ronmart17/nova-robot/docs/images/NOVA_RevB_hero_face.png

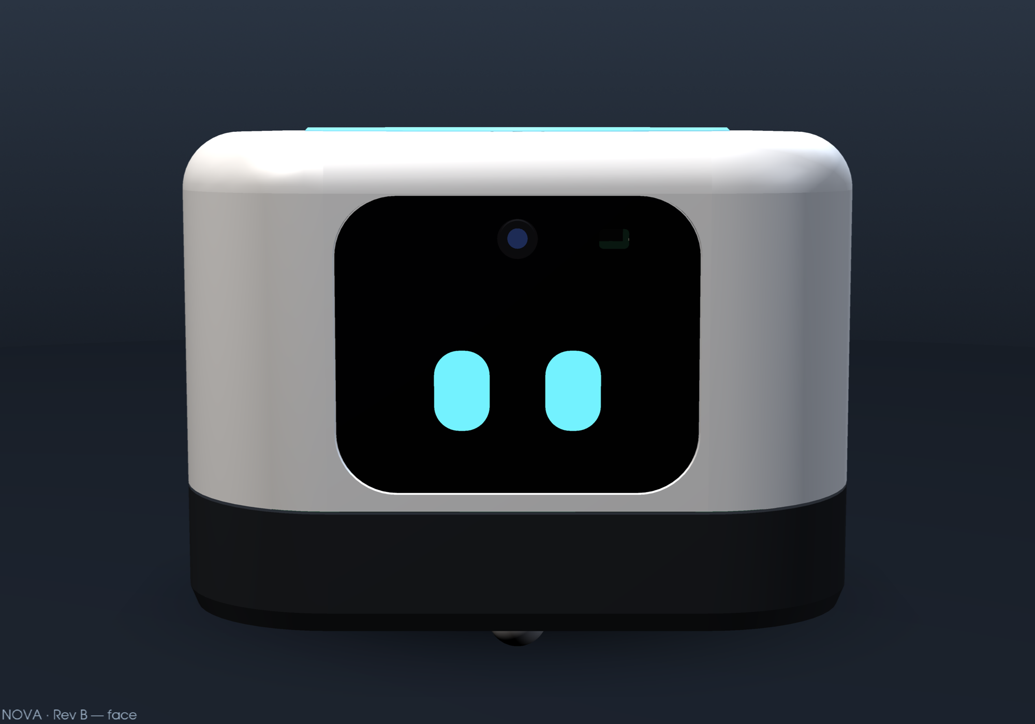
docs/images/NOVA_RevB_hero_face.png
