ronmart17/nova-robot/mechanics/renders/concept_core_iso.png

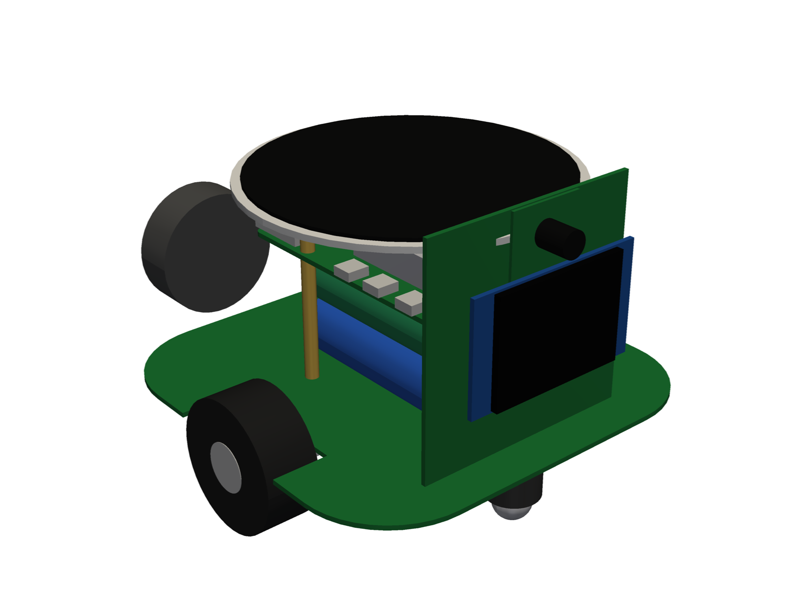
mechanics/renders/concept_core_iso.png
