ronmart17/nova-robot/mechanics/renders/concept_shell_iso.png

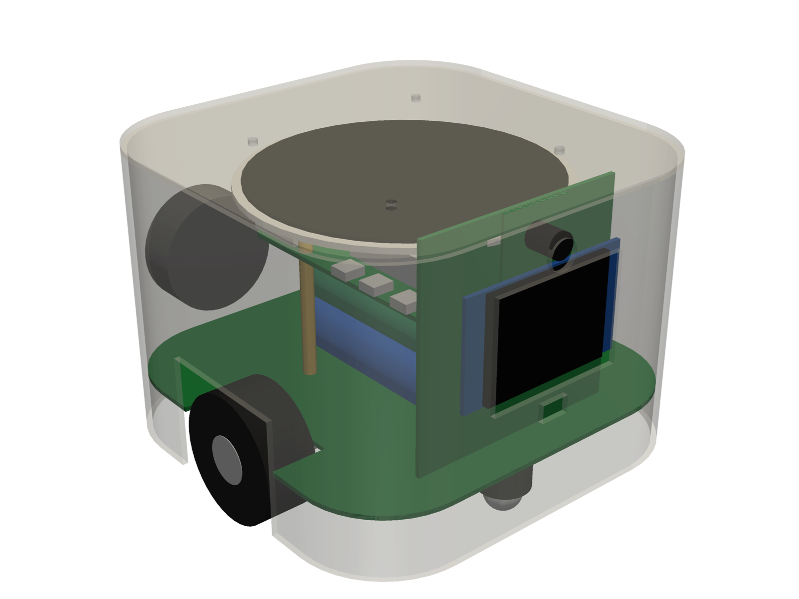
mechanics/renders/concept_shell_iso.png
