ronmart17/nova-robot/mechanics/renders/concept_side.png

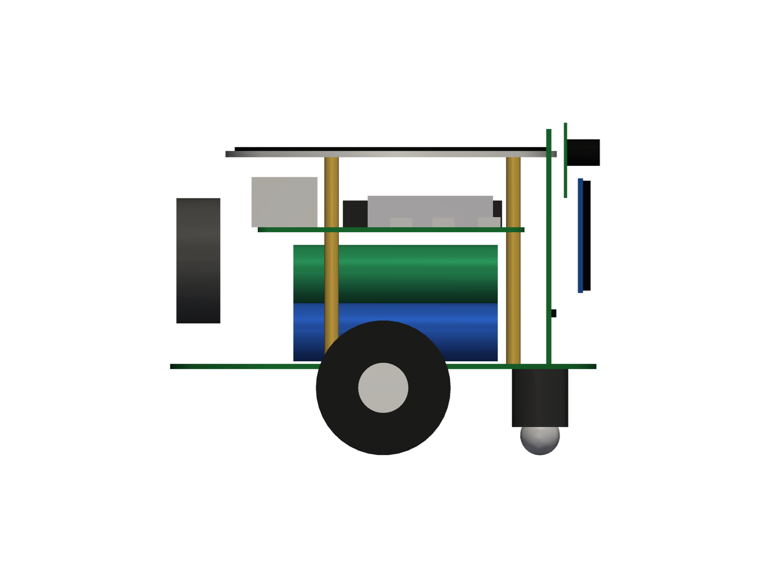
mechanics/renders/concept_side.png
