ronmart17/nova-robot/mechanics/renders/layout_top.png

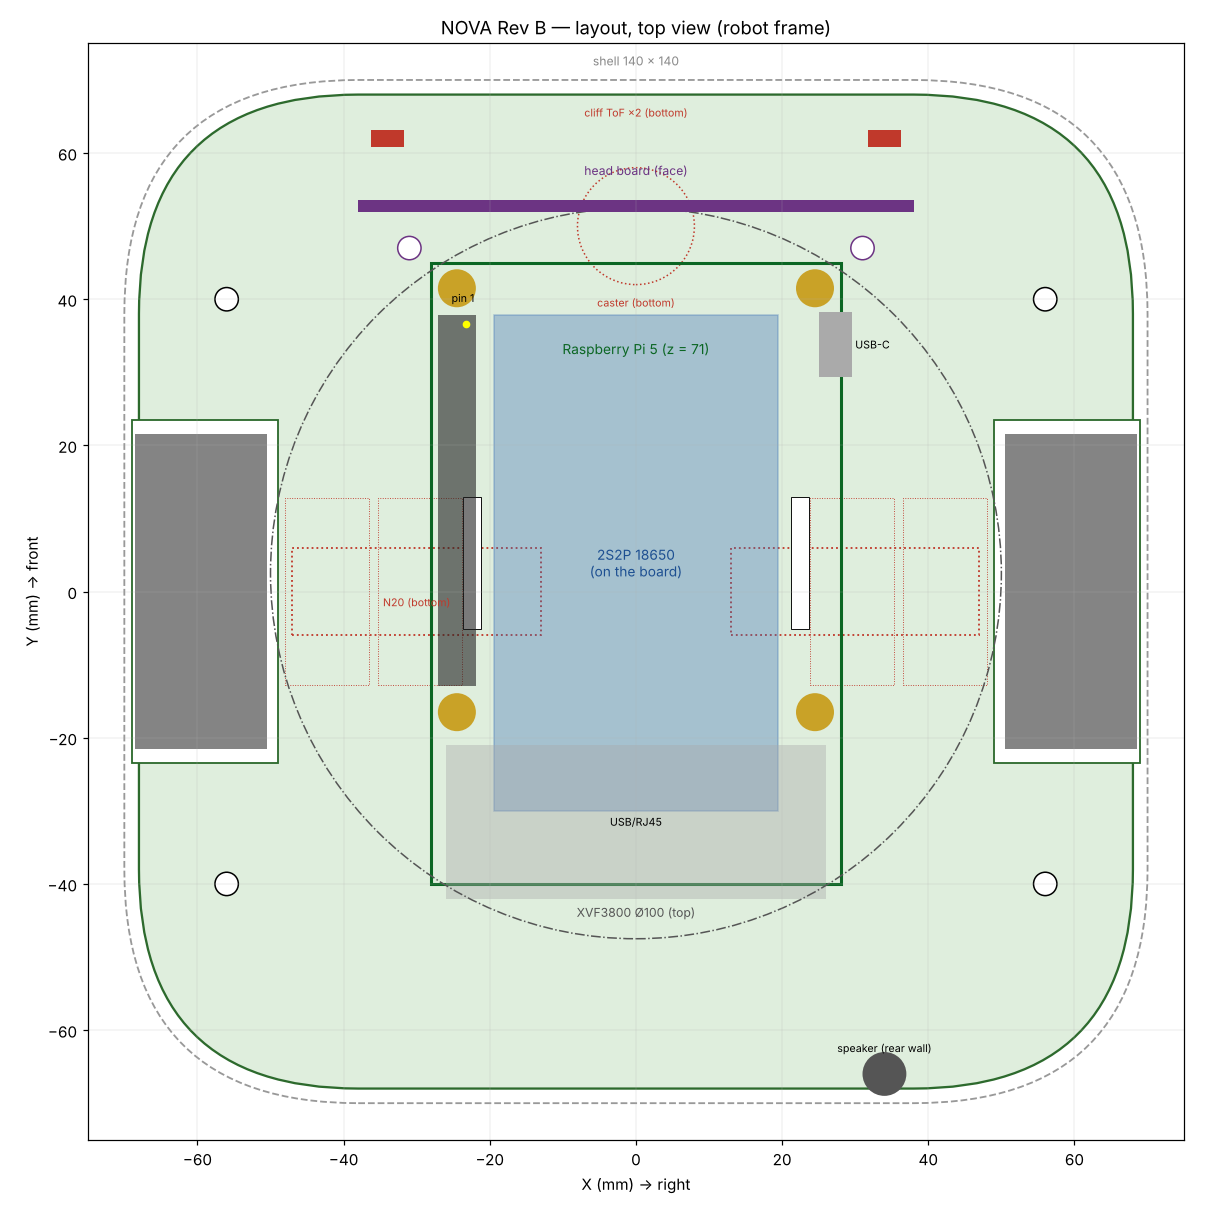
mechanics/renders/layout_top.png
