ronmart17/nova-robot/mechanics/renders/NOVA_RevB_core_left.png

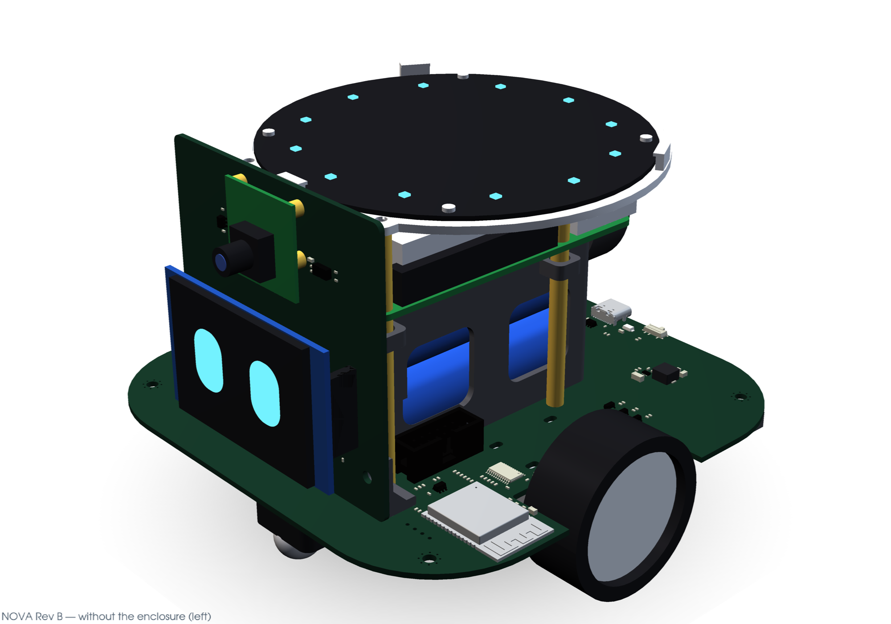
mechanics/renders/NOVA_RevB_core_left.png
