ronmart17/nova-robot/mechanics/renders/NOVA_RevB_dock.png

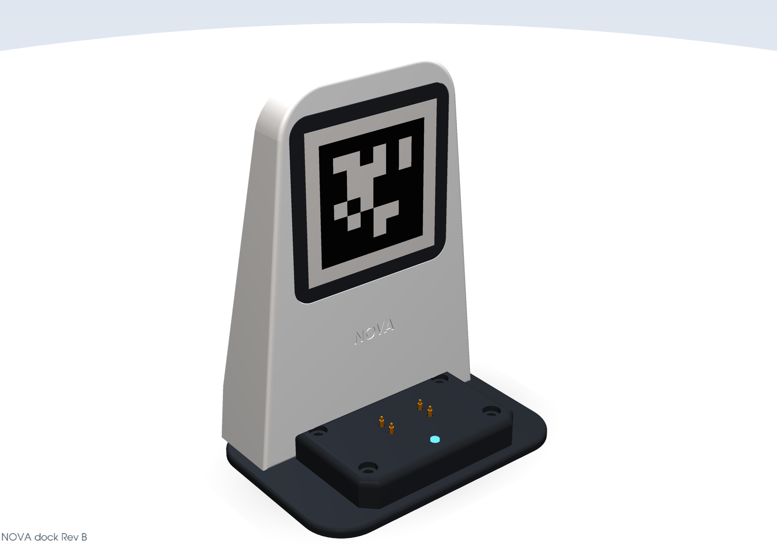
mechanics/renders/NOVA_RevB_dock.png
