ronmart17/nova-robot/mechanics/renders/NOVA_RevB_docked.png

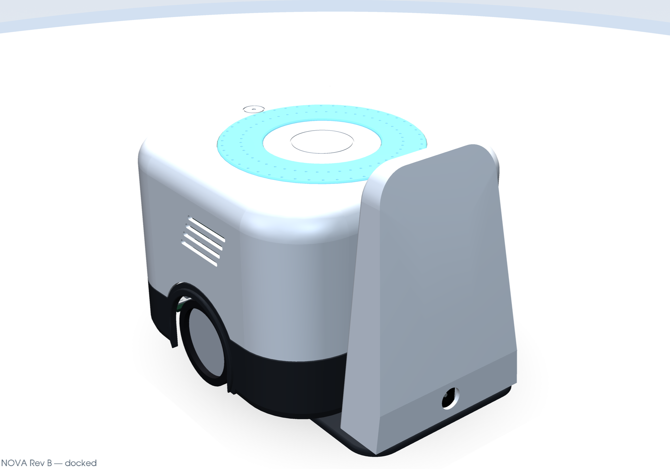
mechanics/renders/NOVA_RevB_docked.png
