ronmart17/nova-robot/mechanics/renders/NOVA_RevB_front.png

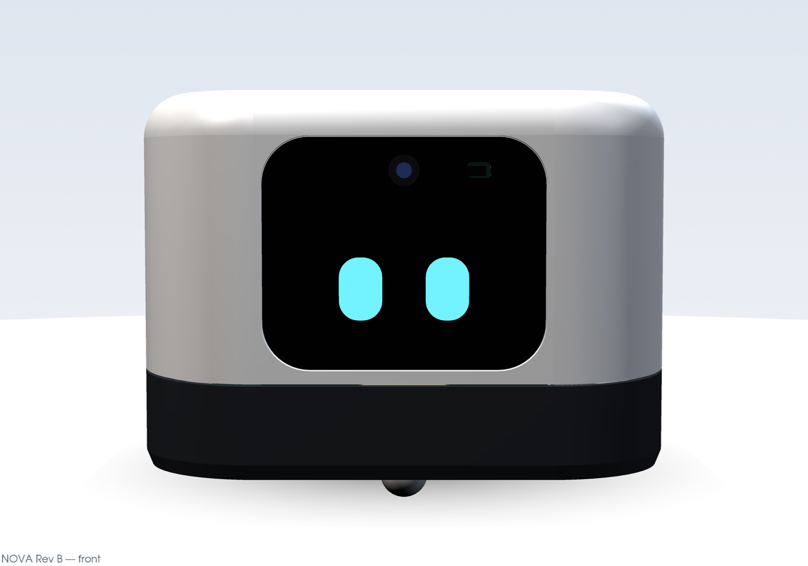
mechanics/renders/NOVA_RevB_front.png
