ronmart17/nova-robot/mechanics/renders/NOVA_RevB_hero_dock.png

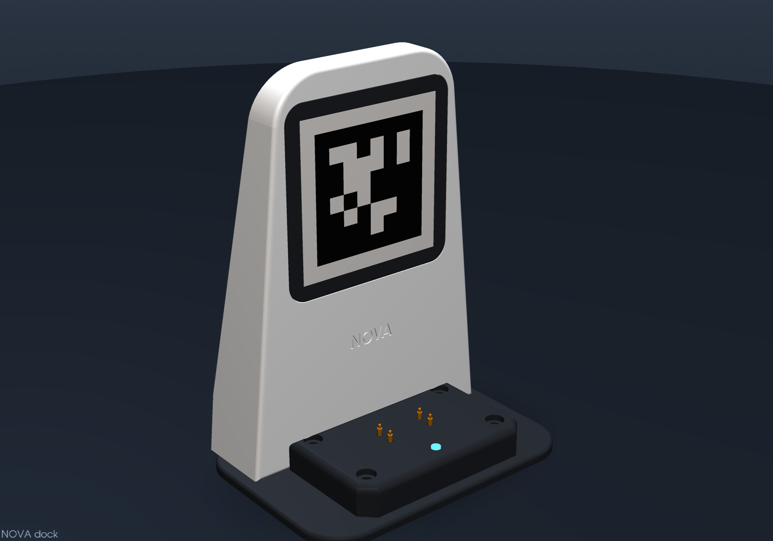
mechanics/renders/NOVA_RevB_hero_dock.png
