ronmart17/nova-robot/mechanics/renders/NOVA_RevB_iso.png

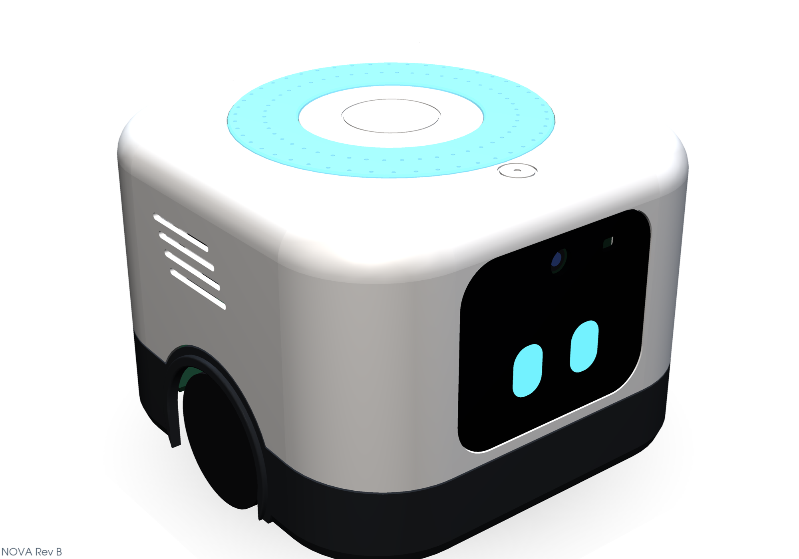
mechanics/renders/NOVA_RevB_iso.png
