ronmart17/nova-robot/mechanics/renders/NOVA_RevB_rear.png

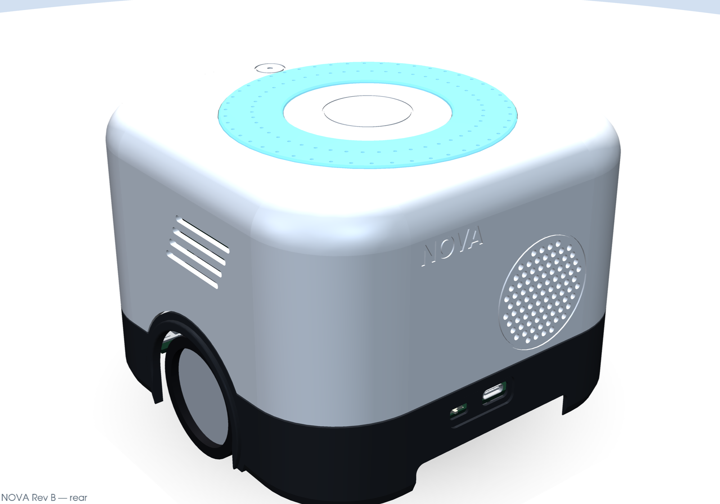
mechanics/renders/NOVA_RevB_rear.png
