ronmart17/nova-robot/mechanics/renders/NOVA_RevB_under.png

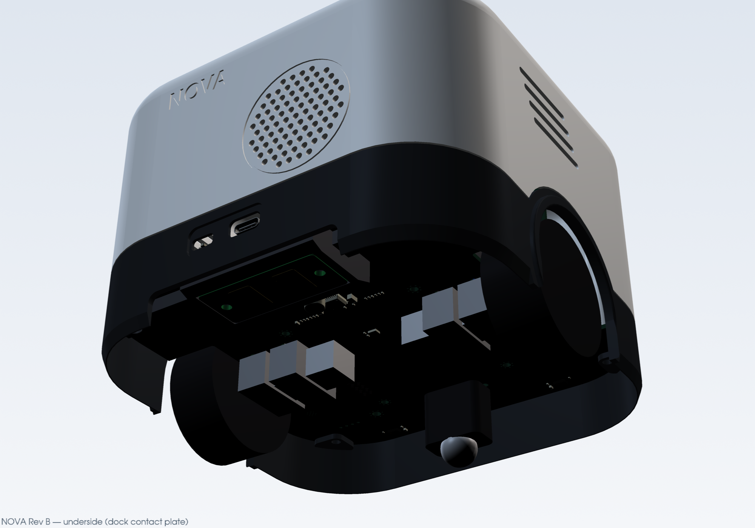
mechanics/renders/NOVA_RevB_under.png
