ronmart17/nova-robot/simulations/plots/s1_vsys_motors_6.6V.png

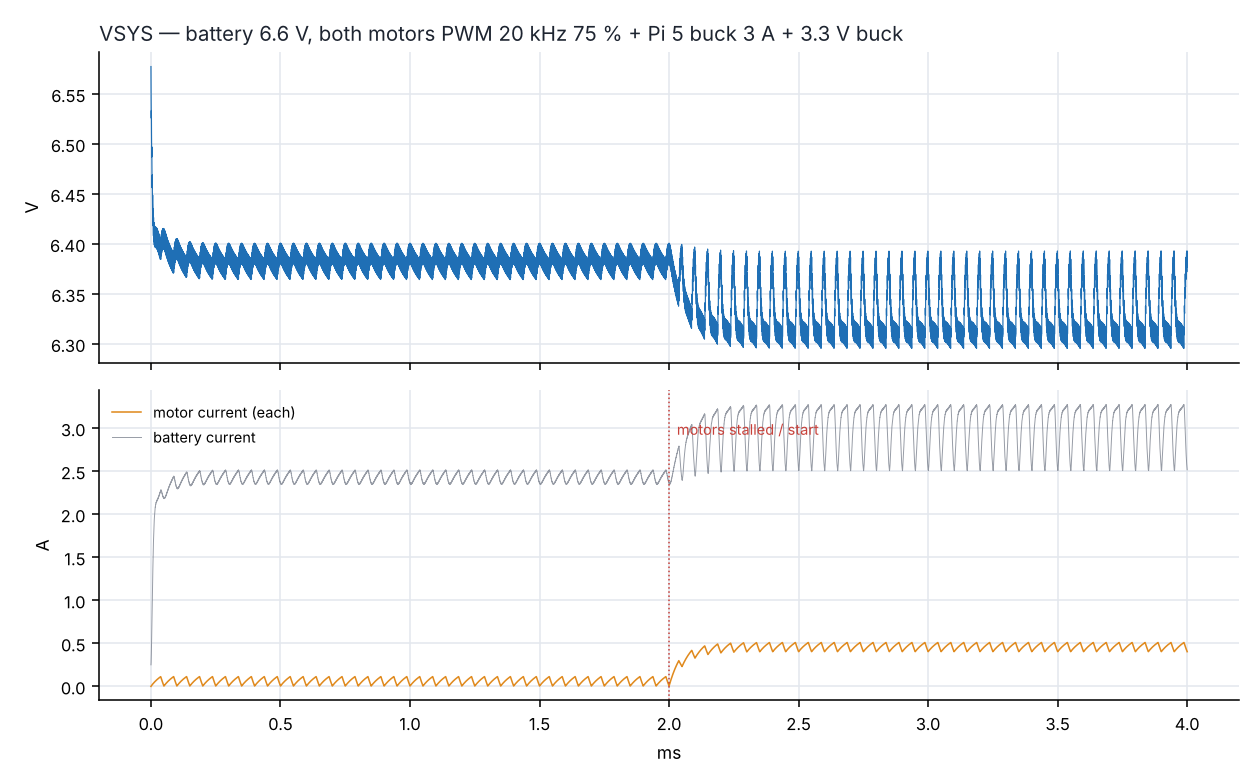
simulations/plots/s1_vsys_motors_6.6V.png
