ronmart17/nova-robot/hardware/nova-head/fabrication/nova-head_BOM.csv

Item | Qty | Designators | Value | Footprint | Manufacturer | MPN | LCSC | Mouser | DigiKey | Alt MPN | Alt Mouser | Alt DigiKey | Description | Sourcing note | DNP
1 | 1 | C101 | 10u/10V | C_0603_1608Metric | Yageo | CC0603KRX5R6BB106 | C326057 | 603-CC603KRX5R6BB106 |  |  |  |  | MLCC 10uF 10V X5R 0603 | JLC Basic alt C19702
2 | 5 | C102, C103, C105, C106, C108 | 100n | C_0402_1005Metric | Samsung | CL05B104KB54PNC | C307331 | 187-CL05B104KB54PNC | 1276-CL05B104KB54PNCCT-ND |  |  |  | MLCC 100nF 50V X7R 0402 | JLC Basic
3 | 1 | C104 | 4.7u/16V | C_0603_1608Metric | Samsung | CL10A475KO8NNNC | C19666 |  | 1276-1784-1-ND |  |  |  | MLCC 4.7uF 16V X5R 0603 | JLC Basic
4 | 1 | C109 | 8.2n | C_0402_1005Metric | Yageo | CC0402KRX7R9BB822 | C107032 | 603-CC402KRX7R9BB822 | 311-3817-1-ND |  |  |  | MLCC 8.2nF 50V X7R 0402 — QT1010 Cs
5 | 1 | J101 | HEAD | JST_SH_SM20B-SRSS-TB_1x20-1MP_P1.00mm_Horizontal | JST | SM20B-SRSS-TB(LF)(SN) | C160415 | 306-SM20BSRSSTBLFSN | 455-SM20B-SRSS-TBCT-ND |  |  |  | JST SH 20-pin SMD — cable to head board
6 | 1 | J102 | LCD ST7789 | PinSocket_1x08_P2.54mm_Vertical | Amphenol FCI | 75915-308LF | C3322318 | 649-75915-308LF | 609-3559-ND |  |  |  | Female header 1x8 2.54 mm — 2.0" ST7789 240x320 SPI module (GND VCC SCL SDA RES DC CS BLK) | LCSC 151 pcs.
7 | 1 | J103 | LCD ST7789 | PinSocket_1x08_P2.54mm_Vertical | Amphenol FCI | 75915-308LF | C3322318 | 649-75915-308LF | 609-3559-ND |  |  |  | Female header 1x8 2.54 mm — 2.0" ST7789 240x320 SPI module (GND VCC SCL SDA RES DC CS BLK) | LCSC 151 pcs. | DNP
8 | 1 | Q101 | AO3401A | SOT-23 | Alpha & Omega | AO3401A | C15127 |  | 785-1001-1-ND |  |  |  | P-MOSFET -30V -4A, VGS ±12V, 60 mOhm@-4.5V, SOT-23 | JLC Basic
9 | 1 | Q102 | 2N7002LT1G | SOT-23 | onsemi | 2N7002LT1G | C16338 | 863-2N7002LT1G | 2N7002LT1GOSCT-ND |  |  |  | N-MOSFET 60V 115mA SOT-23
10 | 4 | R101, R102, R105, R106 | 10k | R_0402_1005Metric | Yageo | RC0402FR-0710KL | C60490 | 603-RC0402FR-0710KL | 311-10.0KLRCT-ND |  |  |  | Thick-film resistor 10k 1% 0402
11 | 1 | R103 | 100R | R_0402_1005Metric | Yageo | RC0402FR-07100RL | C106232 | 603-RC0402FR-07100RL | 311-100LRCT-ND |  |  |  | Thick-film resistor 100R 1% 0402 | JLC Basic alt C25076
12 | 1 | R104 | 100k | R_0402_1005Metric | Yageo | RC0402FR-07100KL | C60491 | 603-RC0402FR-07100KL | 311-100KLRCT-ND |  |  |  | Thick-film resistor 100k 1% 0402 | JLC Basic alt C25741
13 | 1 | R108 | 4.7k | R_0402_1005Metric | Yageo | RC0402FR-074K7L | C105871 | 603-RC0402FR-074K7L |  |  |  |  | Thick-film resistor 4.7k 1% 0402 | JLC Basic alt C25900
14 | 1 | R109 | 1k | R_0402_1005Metric | Yageo | RC0402FR-071KL | C106235 | 603-RC0402FR-071KL | 311-1.00KLRCT-ND |  |  |  | Thick-film resistor 1k 1% 0402 | JLC Basic alt C11702
15 | 1 | U101 | VL53L1CXV0FY/1 | ST_VL53L1x | STMicroelectronics | VL53L1CXV0FY/1 | C190004 | 511-VL53L1CXV0FY/1 | 497-17764-1-ND |  |  |  | 4m distance ranging ToF sensor, Optical LGA12
16 | 1 | U103 | AT42QT1010-TSHR | SOT-23-6 | Microchip | AT42QT1010-TSHR | C74512 | 556-AT42QT1010-TSHR | AT42QT1010-TSHRCT-ND |  |  |  | Single-key Touch Sensor, SOT-23-6
