ronmart17/nova-robot/hardware/nova-main/fabrication/nova-main_BOM.csv

Item | Qty | Designators | Value | Footprint | Manufacturer | MPN | LCSC | Mouser | DigiKey | Alt MPN | Alt Mouser | Alt DigiKey | Description | Sourcing note | DNP
1 | 2 | C201, C202 | 1u/25V | C_0603_1608Metric | Yageo | CC0603KRX5R8BB105 | C14664 | 603-CC603KRX5R8BB105 | 311-1445-1-ND |  |  |  | MLCC 1uF 25V X5R 0603
2 | 15 | C203, C204, C206, C207, C208, C210, C211, C212, C213, C214, C216, C217, C301, C302, C303 | 10u/25V | C_0805_2012Metric | Samsung | CL21A106KAYNNNE | C15850 | 187-CL21A106KAYNNNE | 1276-6455-1-ND |  |  |  | MLCC 10uF 25V X5R 0805 | JLC Basic
3 | 21 | C205, C209, C215, C304, C306, C310, C315, C316, C321, C323, C326, C402, C404, C501, C505, C601, C602, C604, C608, C702, C703 | 100n | C_0402_1005Metric | Samsung | CL05B104KB54PNC | C307331 | 187-CL05B104KB54PNC | 1276-CL05B104KB54PNCCT-ND |  |  |  | MLCC 100nF 50V X7R 0402 | JLC Basic
4 | 3 | C218, C603, C607 | 4.7u/16V | C_0603_1608Metric | Samsung | CL10A475KO8NNNC | C19666 |  | 1276-1784-1-ND |  |  |  | MLCC 4.7uF 16V X5R 0603 | JLC Basic
5 | 2 | C219, C220 | 47n | C_0402_1005Metric | Samsung | CL05B473KA5NNNC | C318631 | 187-CL05B473KA5NNNC |  |  |  |  | MLCC 47nF 25V X7R 0402
6 | 6 | C221, C312, C506, C507, C508, C509 | 1n | C_0402_1005Metric | Samsung | CL05B102KB5NNNC | C14442 | 187-CL05B102KB5NNNC | 1276-1032-1-ND |  |  |  | MLCC 1nF 50V X7R 0402
7 | 2 | C305, C403 | 1u/25V | C_0402_1005Metric | Samsung | CL05A105KA5NQNC | C52923 | 187-CL05A105KA5NQNC | 1276-1445-1-ND |  |  |  | MLCC 1uF 25V X5R 0402 | JLC Basic
8 | 3 | C307, C308, C309 | 47u/10V | C_1206_3216Metric | Samsung | CL31A476MPHNNNE | C96123 |  |  |  |  |  | MLCC 47uF 10V X5R 1206 | JLC Basic; alt. Murata GRM31CR61A476ME15L (C94034)
9 | 1 | C311 | 33p C0G | C_0402_1005Metric | Samsung | CL05C330JB5NNNC | C70465 | 187-CL05C330JB5NNNC | 1276-1009-1-ND |  |  |  | MLCC 33pF 50V C0G 0402
10 | 3 | C320, C503, C504 | 22u/25V | C_1206_3216Metric | Samsung | CL31A226KAHNNNE | C12891 |  | 1276-3047-6-ND |  |  |  | MLCC 22uF 25V X5R 1206 | JLC Basic; Western sourcing: Yageo CC1206MKX5R8BB226 (Mouser/DigiKey)
11 | 1 | C322 | 33n | C_0402_1005Metric | Samsung | CL05B333KB5VPNC | C472437 | 187-CL05B333KB5VPNC |  |  |  |  | MLCC 33nF 50V X7R 0402
12 | 4 | C324, C325, C401, C701 | 22u/10V | C_0805_2012Metric | Taiyo Yuden | LMK212BJ226MG-T | C92814 | 963-LMK212BJ226MG-T | 587-1958-1-ND |  |  |  | MLCC 22uF 10V X5R 0805
13 | 1 | C502 | 100u/50V | CP_Elec_6.3x7.7 | Panasonic | EEE-FTH101XAP | C165974 | 667-EEE-FTH101XAP | PCE5024CT-ND |  |  |  | Aluminium electrolytic 100uF 50V, 6.3x7.7 mm, ESR 0.34 ohm — damping bulk on VM
14 | 2 | C510, C609 | 10u/10V | C_0603_1608Metric | Yageo | CC0603KRX5R6BB106 | C326057 | 603-CC603KRX5R6BB106 |  |  |  |  | MLCC 10uF 10V X5R 0603 | JLC Basic alt C19702
15 | 1 | C612 | 100u/50V | CP_Elec_6.3x7.7 | Panasonic | EEE-FTH101XAP | C165974 | 667-EEE-FTH101XAP | PCE5024CT-ND |  |  |  | Aluminium electrolytic 100uF 50V, 6.3x7.7 mm, ESR 0.34 ohm — damping bulk on VM |  | DNP
16 | 1 | D201 | SMF12A | D_SMF | Littelfuse | SMF12A | C123800 | 576-SMF12A |  |  |  |  | TVS unidirectional 12V standoff (VBR 13.3-14.7V, Vc 19.9V) 200W SMF — USB-C VBUS
17 | 1 | D202 | SMF15A | D_SMF | Littelfuse | SMF15A | C123802 | 576-SMF15A |  |  |  |  | TVS unidirectional 15V standoff (VBR 16.7-18.5V, Vc 24.4V) 200W SMF — 12 V dock input
18 | 1 | D401 | Green | LED_0603_1608Metric | Lite-On | LTST-C191KGKT | C125098 | 859-LTST-C191KGKT | 160-1446-1-ND |  |  |  | LED yellow-green 574 nm 0603
19 | 1 | D701 | SMF6.0A | D_SMF | Littelfuse | SMF6.0A | C123790 | 576-SMF6.0A |  |  |  |  | TVS unidirectional 6.0V standoff (VBR 6.67-7.37V, Vc 10.3V) 200W SMF — Pi 5 V rail
20 | 1 | F301 | 10A very fast | Fuse_Littelfuse-NANO2-451_453 | Littelfuse | 0451010.MRL | C44479 | 576-0451010.MRL | F2350CT-ND |  |  |  | SMD fuse NANO2 10A very fast-acting, 125V, 5.6 mOhm, 2410 (6.1x2.69 mm)
21 | 2 | J201, J702 | USB-C | USB_C_Receptacle_HRO_TYPE-C-31-M-12_GCT_USB4105 | Korean Hroparts Elec | TYPE-C-31-M-12 | C165948 |  |  | USB4105-GF-A (GCT) | 640-USB4105-GF-A | 2073-USB4105-GF-ACT-ND | USB-C receptacle USB 2.0, 16P, top mount, horizontal (HRO TYPE-C-31-M-12 / GCT USB4105-GF-A) | Approved alternative on the same footprint: GCT USB4105-GF-A (Mouser 640-USB4105-GF-A, DigiKey 2073-USB4105-GF-ACT-ND)
22 | 1 | J202 | NTC | JST_PH_B2B-PH-K_1x02_P2.00mm_Vertical | JST | B2B-PH-K-S(LF)(SN) | C131337 | 306-B2BPHKSLFSN | 455-1704-ND |  |  |  | JST PH 2-pin — 10k NTC (103AT) taped to the cells | Vertical (top entry) since the PCB phase
23 | 1 | J203 | DOCK 12V | JST_XH_B2B-XH-A_1x02_P2.50mm_Vertical | JST | B2B-XH-A(LF)(SN) | C158012 | 306-B2B-XH-ALFSN | 455-2247-ND |  |  |  | JST XH 2-pin vertical, 3 A — wires from the dock contact plate (1 = +12 V, 2 = GND)
24 | 1 | J301 | BATTERY 2S | JST_VH_B3P-VH_1x03_P3.96mm_Vertical | JST | B3P-VH(LF)(SN) | C160316 | 306-B3P-VHLFSN |  |  |  |  | JST VH 3-pin 3.96 mm, 10 A — 2S pack: 1 B-, 2 BM, 3 B+
25 | 1 | J401 | UART | PinHeader_1x04_P2.54mm_Vertical | Molex | 22-28-4040 | C587039 | 538-22-28-4040 |  |  |  |  | Debug UART header 1x4 2.54 mm (not fitted) |  | DNP
26 | 2 | J501, J502 | MOTOR+ENC | JST_PH_S6B-PH-SM4-TB_1x06-1MP_P2.00mm_Horizontal | JST | S6B-PH-SM4-TB(LF)(SN) | C265405 |  |  |  |  |  | JST PH 6-pin SMD side entry (bottom side, under the pack) — N20 motor with Hall encoder
27 | 1 | J602 | HEAD | JST_SH_SM20B-SRSS-TB_1x20-1MP_P1.00mm_Horizontal | JST | SM20B-SRSS-TB(LF)(SN) | C160415 | 306-SM20BSRSSTBLFSN | 455-SM20B-SRSS-TBCT-ND |  |  |  | JST SH 20-pin SMD — cable to head board
28 | 1 | J603 | SERVO | PinHeader_1x03_P2.54mm_Vertical | BOOMELE | 2.54-1*3P header | C49257 |  |  |  |  |  | Pin header 1x3 2.54 mm — hobby servo (1 GND, 2 +5V, 3 signal) | Not fitted until a tilt servo is added | DNP
29 | 1 | J701 | PI GPIO 1-12 | IDC-Header_2x06_P2.54mm_Vertical | BOOMELE | 2.54-2*6P box header | C9136 |  |  |  |  |  | Box header 2x6 2.54 mm, shrouded, vertical — IDC ribbon to Raspberry Pi 5 header pins 1-12 | Any 2x6 2.54 mm shrouded box header fits
30 | 2 | L201, L301 | 2.2uH | L_Sunlord_MWSA0605S | Sunlord | MWSA0605S-2R2MT | C408463 |  |  |  |  |  | Power inductor 2.2uH 20%, Isat 11A, Irms 9A, 12.5 mOhm, shielded 7.0x6.6x5.0 mm | Alt. TAI-TECH TMPC0605H-2R2MG-D (C357209), same land pattern class
31 | 1 | L302 | 3.3uH | L_Bourns_SRP5030T | Bourns | SRP5030T-3R3M | C189931 | 652-SRP5030T-3R3M | SRP5030T-3R3MCT-ND |  |  |  | Power inductor 3.3uH 20%, Isat 8A, Irms 5A, 38 mOhm, shielded 5.7x5.2 — TPS62933 at 1.2 MHz
32 | 4 | Q201, Q202, Q203, Q204 | CSD17578Q3A | VSON-8_3.3x3.3mm_P0.65mm_NexFET | Texas Instruments | CSD17578Q3A | C205986 | 595-CSD17578Q3A |  |  |  |  | 30V N-channel NexFET, 9.4 mOhm @ VGS 4.5V, VSON-8 3.3x3.3 mm
33 | 2 | Q301, Q302 | CSD17579Q3A | VSON-8_3.3x3.3mm_P0.65mm_NexFET | Texas Instruments | CSD17579Q3A | C97376 | 595-CSD17579Q3A |  |  |  |  | 30V N-channel NexFET, 8.7 mOhm @ VGS 10V, VSON-8 3.3x3.3 mm
34 | 4 | Q303, Q701, Q702, Q703 | 2N7002LT1G | SOT-23 | onsemi | 2N7002LT1G | C16338 | 863-2N7002LT1G | 2N7002LT1GOSCT-ND |  |  |  | N-MOSFET 60V 115mA SOT-23
35 | 2 | R201, R202 | 5.1k | R_0402_1005Metric | Yageo | RC0402FR-075K1L | C105872 | 603-RC0402FR-075K1L | 311-5.10KLRCT-ND |  |  |  | Thick-film resistor 5.1k 1% 0402 | JLC Basic alt C25905
36 | 13 | R203, R214, R310, R312, R420, R601, R602, R604, R703, R705, R707, R710, R711 | 100k | R_0402_1005Metric | Yageo | RC0402FR-07100KL | C60491 | 603-RC0402FR-07100KL | 311-100KLRCT-ND |  |  |  | Thick-film resistor 100k 1% 0402 | JLC Basic alt C25741
37 | 1 | R204 | 200k | R_0402_1005Metric | Yageo | RC0402FR-07200KL | C114763 | 603-RC0402FR-07200KL | 311-200KLRCT-ND |  |  |  | Thick-film resistor 200k 1% 0402 | JLC Basic alt C25764
38 | 2 | R205, R206 | 0R | R_0402_1005Metric | Yageo | RC0402JR-070RL | C60485 | 603-RC0402JR-070RL | 311-0.0JRCT-ND |  |  |  | Thick-film resistor 0R 1% 0402 | JLC Basic alt C17168
39 | 1 | R207 | 5.23k | R_0402_1005Metric | Vishay | CRCW04025K23FKED | C2076550 | 71-CRCW0402-5.23K-E3 | 541-5.23KLCT-ND |  |  |  | Thick-film resistor 5.23k 1% 0402
40 | 1 | R208 | 30.1k | R_0402_1005Metric | Panasonic | ERJ-2RKF3012X | C2076806 | 667-ERJ-2RKF3012X | P30.1KLCT-ND |  |  |  | Thick-film resistor 30.1k 1% 0402
41 | 1 | R209 | 10k | R_0402_1005Metric | Yageo | RC0402FR-0710KL | C60490 | 603-RC0402FR-0710KL | 311-10.0KLRCT-ND |  |  |  | Thick-film resistor 10k 1% 0402 |  | DNP
42 | 1 | R210 | 4.7k | R_0402_1005Metric | Yageo | RC0402FR-074K7L | C105871 | 603-RC0402FR-074K7L |  |  |  |  | Thick-film resistor 4.7k 1% 0402 | JLC Basic alt C25900
43 | 19 | R212, R313, R321, R401, R410, R411, R414, R415, R416, R417, R418, R419, R501, R503, R505, R507, R709, R712, R713 | 10k | R_0402_1005Metric | Yageo | RC0402FR-0710KL | C60490 | 603-RC0402FR-0710KL | 311-10.0KLRCT-ND |  |  |  | Thick-film resistor 10k 1% 0402
44 | 1 | R213 | 8.2k | R_0402_1005Metric | UNI-ROYAL | 0402WGF8201TCE | C25924 |  |  |  |  |  | Thick-film resistor 8.2k 1% 0402 | JLC Basic
45 | 5 | R215, R603, R704, R706, R708 | 100R | R_0402_1005Metric | Yageo | RC0402FR-07100RL | C106232 | 603-RC0402FR-07100RL | 311-100LRCT-ND |  |  |  | Thick-film resistor 100R 1% 0402 | JLC Basic alt C25076
46 | 1 | R301 | 182k | R_0402_1005Metric | Yageo | RC0402FR-07182KL | C327365 | 603-RC0402FR-07182KL | 311-182KLRCT-ND |  |  |  | Thick-film resistor 182k 1% 0402 | TPS566238 feedback: 0.1% option RT0402BRD07182KL (C723556)
47 | 1 | R302 | 24k | R_0402_1005Metric | Yageo | RC0402FR-0724KL | C138026 | 603-RC0402FR-0724KL | 311-24.0KLRCT-ND |  |  |  | Thick-film resistor 24k 1% 0402
48 | 2 | R305, R308 | 330R | R_0402_1005Metric | Yageo | RC0402FR-07330RL | C105875 | 603-RC0402FR-07330RL |  |  |  |  | Thick-film resistor 330R 1% 0402
49 | 1 | R306 | 86.6k | R_0402_1005Metric | Yageo | RC0402FR-0786K6L | C477807 | 603-RC0402FR-0786K6L |  |  |  |  | Thick-film resistor 86.6k 1% 0402
50 | 1 | R307 | 23.2k | R_0402_1005Metric | Vishay | CRCW040223K2FKED | C2076557 | 71-CRCW0402-23.2K-E3 | 541-23.2KLCT-ND |  |  |  | Thick-film resistor 23.2k 1% 0402
51 | 8 | R309, R412, R502, R504, R506, R508, R701, R702 | 1k | R_0402_1005Metric | Yageo | RC0402FR-071KL | C106235 | 603-RC0402FR-071KL | 311-1.00KLRCT-ND |  |  |  | Thick-film resistor 1k 1% 0402 | JLC Basic alt C11702
52 | 1 | R320 | 31.6k | R_0402_1005Metric | Vishay | CRCW040231K6FKED | C482148 | 71-CRCW0402-31.6K-E3 | 541-31.6KLCT-ND |  |  |  | Thick-film resistor 31.6k 1% 0402
53 | 2 | R402, R403 | 33R | R_0402_1005Metric | Yageo | RC0402FR-0733RL | C138002 | 603-RC0402FR-0733RL | 311-33.0LRCT-ND |  |  |  | Thick-film resistor 33R 1% 0402
54 | 2 | R408, R409 | 2.2k | R_0402_1005Metric | Yageo | RC0402FR-072K2L | C114762 | 603-RC0402FR-072K2L | 311-2.20KLRCT-ND |  |  |  | Thick-film resistor 2.2k 1% 0402 | JLC Basic alt C25879
55 | 1 | SW301 | PWR | SW_SPDT_PCM12 | C&K | PCM12SMTR | C221841 | 611-PCM12SMTR | 401-2016-1-ND |  |  |  | Slide switch SPDT SMD; shorts PWR_EN to GND (OFF), contacts see <= 1.6 V
56 | 2 | SW401, SW402 | SW_Push | SW_SPST_PTS810 | C&K | PTS810SJK250SMTRLFS | C221896 | 611-PTS810SJK250SMTR | CKN10503CT-ND |  |  |  | Tactile switch SMD 4.2x3.2 mm, 2.6 N
57 | 1 | U201 | USBLC6-2SC6 | SOT-23-6 | STMicroelectronics | USBLC6-2SC6 | C7519 | 511-USBLC6-2SC6 | 497-5235-1-ND |  |  |  | Very low capacitance ESD protection diode, 2 data-line, SOT-23-6
58 | 1 | U202 | BQ25798RQMR | Texas_RQM0029A_VQFN-29_4x4mm_P0.4mm | Texas Instruments | BQ25798RQMR | C2876593 | 595-BQ25798RQMR |  |  |  |  | I2C 1-4 cell 5 A buck-boost charger, dual input selector, NVDC power path, 16-bit ADC, VQFN-HR-29
59 | 1 | U301 | R5460N212AF | SOT-23-6 | Nisshinbo (Ricoh) | R5460N212AF-TR-FE | C259717 | 848-R5460N212AF-TR |  |  |  |  | 2-cell Li-ion protector: OV 4.29V/4.05V, UV 3.00V/3.20V, discharge OC 0.2V, charge OC -0.2V, short 1.1V, SOT-23-6
60 | 1 | U302 | TPS566238PRQFR | Texas_RQF0009A_VQFN-HR-9_1.5x2mm_P0.5mm | Texas Instruments | TPS566238PRQFR | C2876603 | 595-TPS566238PRQFR |  |  |  |  | 3-18 V input, 6 A synchronous step-down converter, D-CAP3, 600 kHz, 98% max duty (frequency foldback), power-good, VQFN-HR-9 1.5x2 mm
61 | 1 | U303 | TPS62933DRLR | SOT-583-8 | Texas Instruments | TPS62933DRLR | C3200405 | 595-TPS62933DRLR | 296-TPS62933DRLRCT-ND |  |  |  | 3.8-30V, 3A Synchronous Buck Converters with pulse frequency modulation (PFM), SOT583-8
62 | 1 | U401 | ESP32-S3-WROOM-1-N16R8 | ESP32-S3-WROOM-1 | Espressif | ESP32-S3-WROOM-1-N16R8 | C2913202 | 356-ESP32S3WRM1N16R8 |  |  |  |  | RF Module, ESP32-S3 SoC, Wi-Fi 802.11b/g/n, Bluetooth, BLE, 32-bit, 3.3V, onboard antenna, SMD
63 | 1 | U402 | TCA9535PWR | TSSOP-24_4.4x7.8mm_P0.65mm | Texas Instruments | TCA9535PWR | C130204 | 595-TCA9535PWR | 296-25129-1-ND |  |  |  | 16-bit I/O expander, I2C and SMBus interface, interrupts, w/o pull-ups, TSSOP-24 package
64 | 1 | U501 | TB6612FNG | SSOP-24_5.3x8.2mm_P0.65mm | Toshiba | TB6612FNG,C,8,EL | C141517 | 757-TB6612FNGC8EL | TB6612FNGC8ELCT-ND |  |  |  | Driver IC for Dual DC motor, SSOP-24
65 | 1 | U601 | LSM6DSOXTR | LGA-14_3x2.5mm_P0.5mm_LayoutBorder3x4y | STMicroelectronics | LSM6DSOXTR | C481766 | 511-LSM6DSOXTR | 497-18367-1-ND |  |  |  | iNEMO 6DoF IMU with machine learning core, 3D accelerometer and 3D gyroscope, I2C/SPI, LGA-14L (pin-compatible with LSM6DSO)
66 | 2 | U602, U603 | VL53L4CDV0DH/1 | ST_VL53L4CD | STMicroelectronics | VL53L4CDV0DH/1 | C3178291 | 511-VL53L4CDV0DH/1 |  |  |  |  | Time-of-Flight ranging sensor 1-1300 mm, 18 deg FoV, I2C 0x29, 2.6-3.5 V, optical LGA12 4.4x2.4 mm
67 | 1 | U701 | SN74LVC1G125DBVR | SOT-23-5 | Texas Instruments | SN74LVC1G125DBVR | C23654 | 595-SN74LVC1G125DBVR | 296-11603-1-ND |  |  |  | Single bus buffer, 3-state, active-low OE, Ioff (partial power-down), 1.65-5.5 V, SOT-23-5
