ronmart17/nova-robot/hardware/nova-main/fabrication/nova-main.step

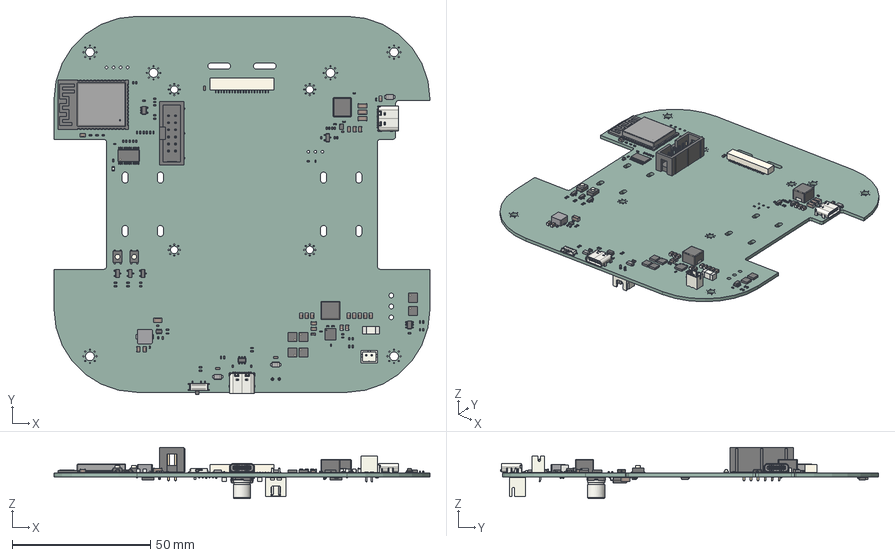
[picture p58: CAD file, 2026-11-02]
hardware/nova-main/fabrication/nova-main.step
136.0 x 136.9 x 18.5 mm
LED_0603_1608Metric
R_0402_1005Metric x 65
VSON_8_33x33mm_Pitch065mm_NexFET x 6
SOT_23_5
C_0402_1005Metric x 33
C_0805_2012Metric x 19
Fuse_Littelfuse-NANO2-451_453_0
Fuse_Littelfuse-NANO2-451_453_1
Fuse_Littelfuse-NANO2-451_453_2
C_1206_3216Metric x 6
SOT_23 x 4
SOT-583-8_0
SOT-583-8_1
SOT-583-8_2
SOT-583-8_3
SOT-583-8_4
SOT-583-8_5
SOT-583-8_6
SOT-583-8_7
SOT-583-8_8
SOT_23_6 x 2
Texas_RQF0009A_VQFN-HR-9_1.5x2mm_P0.5mm_0
Texas_RQF0009A_VQFN-HR-9_1.5x2mm_P0.5mm_1
Texas_RQF0009A_VQFN-HR-9_1.5x2mm_P0.5mm_2
Texas_RQF0009A_VQFN-HR-9_1.5x2mm_P0.5mm_3
Texas_RQF0009A_VQFN-HR-9_1.5x2mm_P0.5mm_4
Texas_RQF0009A_VQFN-HR-9_1.5x2mm_P0.5mm_5
Texas_RQF0009A_VQFN-HR-9_1.5x2mm_P0.5mm_6
Texas_RQF0009A_VQFN-HR-9_1.5x2mm_P0.5mm_7
Texas_RQF0009A_VQFN-HR-9_1.5x2mm_P0.5mm_8
Texas_RQF0009A_VQFN-HR-9_1.5x2mm_P0.5mm_9
Texas_RQF0009A_VQFN-HR-9_1.5x2mm_P0.5mm_10
IDC_Header_2x06_P254mm_Vertical
C_0603_1608Metric x 7
SW_SPST_PTS810_0 x 2
SW_SPST_PTS810_1 x 2
SW_SPST_PTS810_2 x 2
SW_SPST_PTS810_3 x 2
SW_SPST_PTS810_4 x 2
SW_SPST_PTS810_5 x 2
JST_B2B_PH_K
D_SMF x 3
USB_C_Receptacle_16P_TopMnt_Horizontal_GCT_USB4105-xx-A x 2
JST_SH_SM20B-SRSS-TB_1x20-1MP_P1.00mm_Horizontal_0
JST_SH_SM20B-SRSS-TB_1x20-1MP_P1.00mm_Horizontal_1
JST_SH_SM20B-SRSS-TB_1x20-1MP_P1.00mm_Horizontal_2
JST_SH_SM20B-SRSS-TB_1x20-1MP_P1.00mm_Horizontal_3
JST_SH_SM20B-SRSS-TB_1x20-1MP_P1.00mm_Horizontal_4
JST_SH_SM20B-SRSS-TB_1x20-1MP_P1.00mm_Horizontal_5
JST_SH_SM20B-SRSS-TB_1x20-1MP_P1.00mm_Horizontal_6
JST_SH_SM20B-SRSS-TB_1x20-1MP_P1.00mm_Horizontal_7
JST_SH_SM20B-SRSS-TB_1x20-1MP_P1.00mm_Horizontal_8
JST_SH_SM20B-SRSS-TB_1x20-1MP_P1.00mm_Horizontal_9
JST_SH_SM20B-SRSS-TB_1x20-1MP_P1.00mm_Horizontal_10
JST_SH_SM20B-SRSS-TB_1x20-1MP_P1.00mm_Horizontal_11
JST_SH_SM20B-SRSS-TB_1x20-1MP_P1.00mm_Horizontal_12
JST_SH_SM20B-SRSS-TB_1x20-1MP_P1.00mm_Horizontal_13
JST_SH_SM20B-SRSS-TB_1x20-1MP_P1.00mm_Horizontal_14
JST_SH_SM20B-SRSS-TB_1x20-1MP_P1.00mm_Horizontal_15
JST_SH_SM20B-SRSS-TB_1x20-1MP_P1.00mm_Horizontal_16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
