ronmart17/nova-robot/hardware/nova-dock/fabrication/nova-dock.step

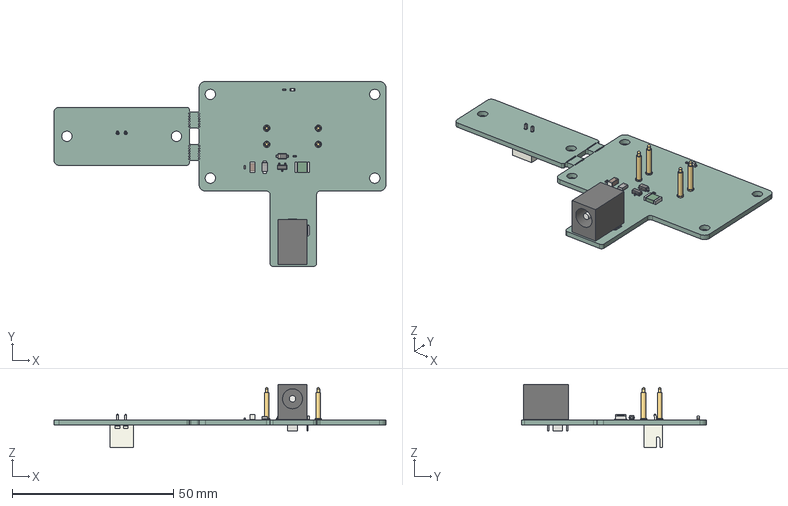
[picture p59: CAD file, 2026-11-02]
hardware/nova-dock/fabrication/nova-dock.step
103.0 x 57.4 x 19.7 mm
C_0402_1005Metric
Pogo_YTC1P-8020_D2.0mm_0 x 4
Pogo_YTC1P-8020_D2.0mm_1 x 4
Pogo_YTC1P-8020_D2.0mm_2 x 4
Pogo_YTC1P-8020_D2.0mm_3 x 4
LED_0603_1608Metric
C_1206_3216Metric
Fuse_1812_4532Metric_0
Fuse_1812_4532Metric_1
Fuse_1812_4532Metric_2
D_SMF
DC_Jack_XKB_DC-005-5A-2.0_Horizontal_0
DC_Jack_XKB_DC-005-5A-2.0_Horizontal_1
DC_Jack_XKB_DC-005-5A-2.0_Horizontal_2
DC_Jack_XKB_DC-005-5A-2.0_Horizontal_3
DC_Jack_XKB_DC-005-5A-2.0_Horizontal_4
D_SOD_123
R_0402_1005Metric x 2
SOT_23
JST_B2B_XH_A
nova-dock_PCB
