ronmart17/nova-robot/hardware/nova-head/fabrication/nova-head.step

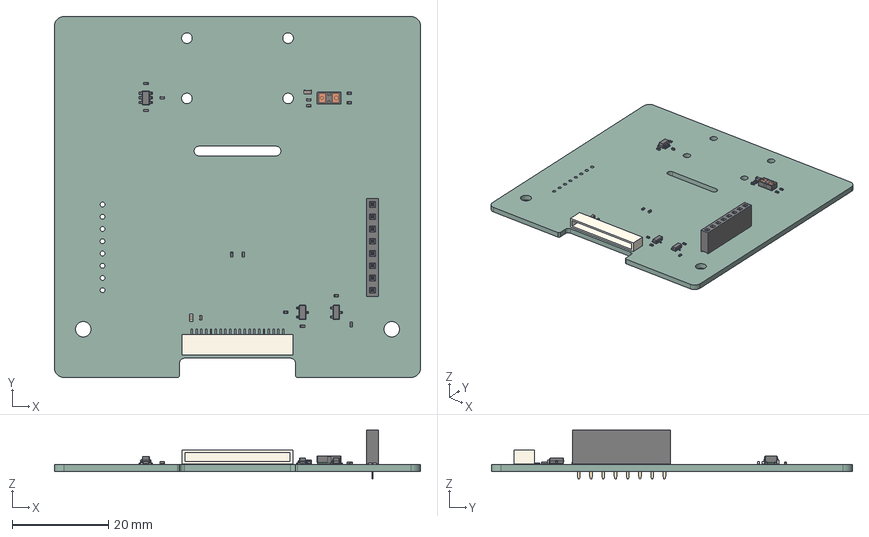
[picture p60: CAD file, 2026-11-02]
hardware/nova-head/fabrication/nova-head.step
76.0 x 74.9 x 10.1 mm
R_0402_1005Metric x 8
C_0603_1608Metric x 2
SOT_23 x 2
C_0402_1005Metric x 6
SOT_23_6
ST_VL53L1x
PinSocket_1x08_P254mm_Vertical
JST_SH_SM20B-SRSS-TB_1x20-1MP_P1.00mm_Horizontal_0
JST_SH_SM20B-SRSS-TB_1x20-1MP_P1.00mm_Horizontal_1
JST_SH_SM20B-SRSS-TB_1x20-1MP_P1.00mm_Horizontal_2
JST_SH_SM20B-SRSS-TB_1x20-1MP_P1.00mm_Horizontal_3
JST_SH_SM20B-SRSS-TB_1x20-1MP_P1.00mm_Horizontal_4
JST_SH_SM20B-SRSS-TB_1x20-1MP_P1.00mm_Horizontal_5
JST_SH_SM20B-SRSS-TB_1x20-1MP_P1.00mm_Horizontal_6
JST_SH_SM20B-SRSS-TB_1x20-1MP_P1.00mm_Horizontal_7
JST_SH_SM20B-SRSS-TB_1x20-1MP_P1.00mm_Horizontal_8
JST_SH_SM20B-SRSS-TB_1x20-1MP_P1.00mm_Horizontal_9
JST_SH_SM20B-SRSS-TB_1x20-1MP_P1.00mm_Horizontal_10
JST_SH_SM20B-SRSS-TB_1x20-1MP_P1.00mm_Horizontal_11
JST_SH_SM20B-SRSS-TB_1x20-1MP_P1.00mm_Horizontal_12
JST_SH_SM20B-SRSS-TB_1x20-1MP_P1.00mm_Horizontal_13
JST_SH_SM20B-SRSS-TB_1x20-1MP_P1.00mm_Horizontal_14
JST_SH_SM20B-SRSS-TB_1x20-1MP_P1.00mm_Horizontal_15
JST_SH_SM20B-SRSS-TB_1x20-1MP_P1.00mm_Horizontal_16
JST_SH_SM20B-SRSS-TB_1x20-1MP_P1.00mm_Horizontal_17
JST_SH_SM20B-SRSS-TB_1x20-1MP_P1.00mm_Horizontal_18
JST_SH_SM20B-SRSS-TB_1x20-1MP_P1.00mm_Horizontal_19
JST_SH_SM20B-SRSS-TB_1x20-1MP_P1.00mm_Horizontal_20
JST_SH_SM20B-SRSS-TB_1x20-1MP_P1.00mm_Horizontal_21
JST_SH_SM20B-SRSS-TB_1x20-1MP_P1.00mm_Horizontal_22
nova-head_PCB
