ronmart17/nova-robot/mechanics/printed_parts/NOVA_battery_cage.step

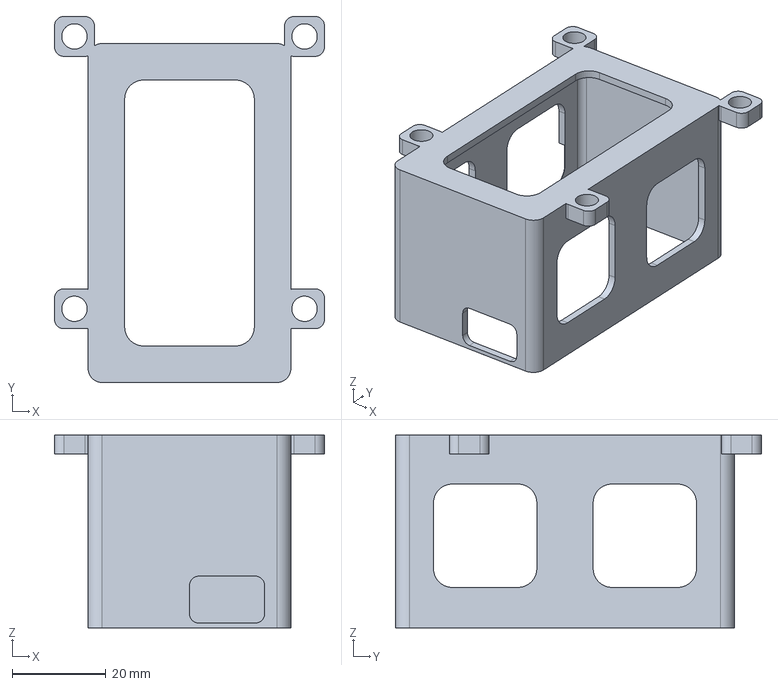
[picture p61: CAD file, 2026-11-02]
mechanics/printed_parts/NOVA_battery_cage.step
57.5 x 78.0 x 41.0 mm
