ronmart17/nova-robot/mechanics/step/NOVA_RevB_dock.step

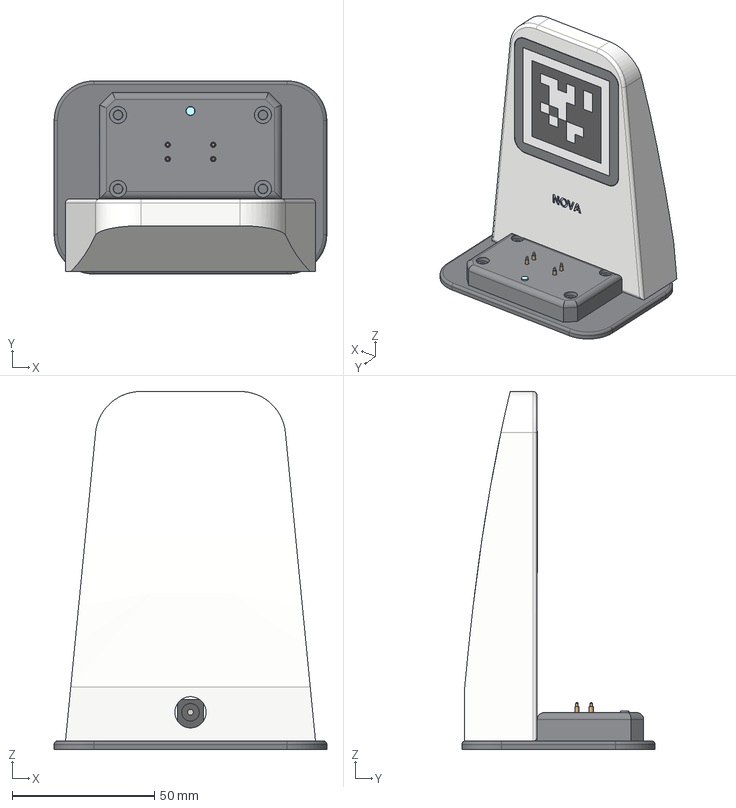
[picture p62: CAD file, 2026-11-02]
mechanics/step/NOVA_RevB_dock.step
96.0 x 68.0 x 126.0 mm
dock_pcb_0
dock_pcb_1
dock_pcb_2
dock_pcb_3
dock_pcb_4
dock_pcb_5
dock_pcb_6
dock_pcb_7
dock_pcb_8
dock_pcb_9
dock_pcb_10
dock_pcb_11
dock_pcb_12
dock_pcb_13
dock_pcb_14
dock_pcb_15
dock_pcb_16
dock_pcb_17
dock_pcb_18
dock_pcb_19
dock_pcb_20
dock_pcb_21
dock_pcb_22
dock_pcb_23
dock_pcb_24
dock_pcb_25
dock_pcb_26
dock_pcb_27
dock_pcb_28
dock_pcb_29
dock_pcb_30
dock_pcb_31
dock_pcb_32
dock_base
dock_tower
dock_tongue
dock_lightpipe
dock_tag_panel
dock_tag_white
dock_tag_black
