ronmart17/nova-robot/mechanics/printed_parts/NOVA_dock_lightpipe.step

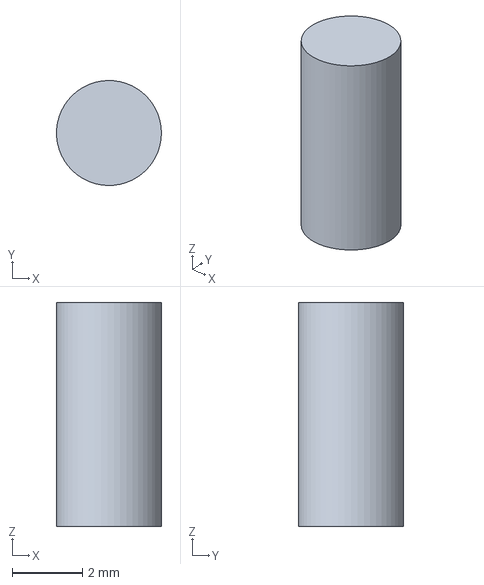
[picture p63: CAD file, 2026-11-02]
mechanics/printed_parts/NOVA_dock_lightpipe.step
3.00 x 3.00 x 6.40 mm
