ronmart17/nova-robot/mechanics/printed_parts/NOVA_dock_tag_panel.step

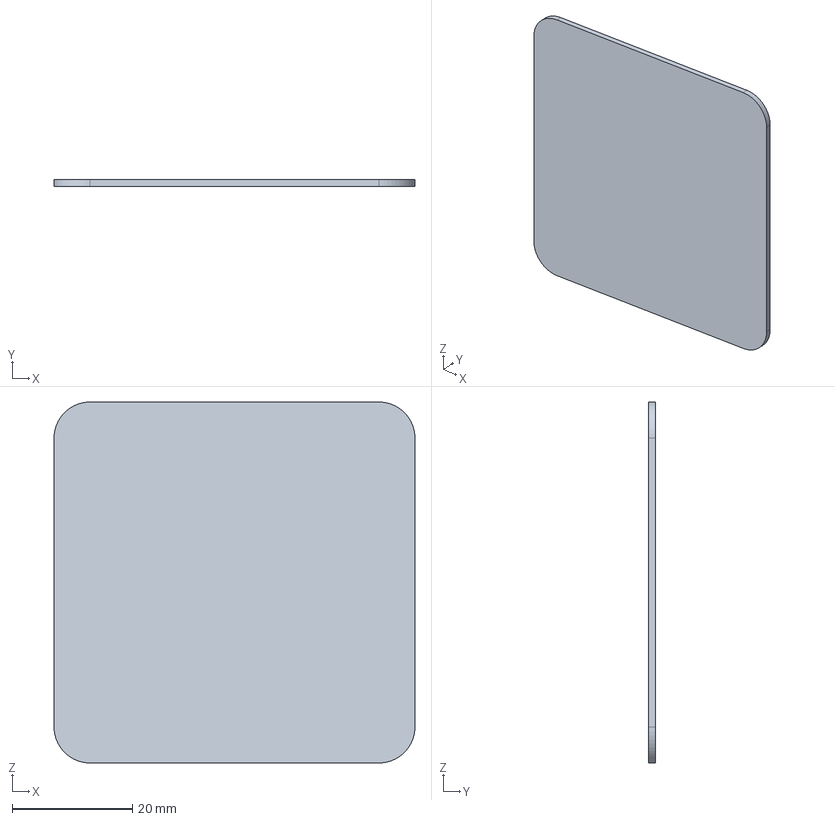
[picture p64: CAD file, 2026-11-02]
mechanics/printed_parts/NOVA_dock_tag_panel.step
60.0 x 1.20 x 60.0 mm
