ronmart17/nova-robot/mechanics/printed_parts/NOVA_head_bracket_R.step

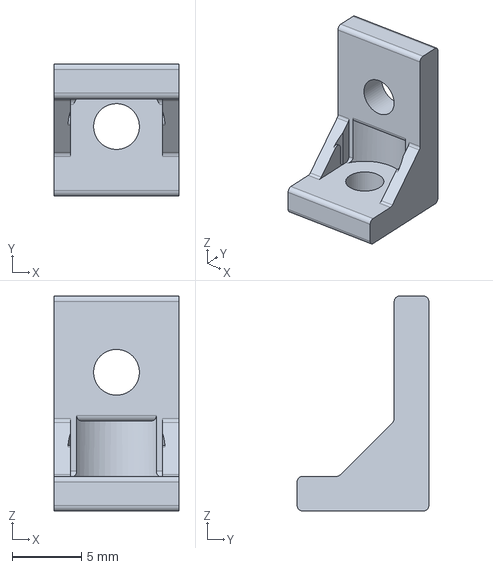
[picture p65: CAD file, 2026-11-02]
mechanics/printed_parts/NOVA_head_bracket_R.step
9.00 x 9.50 x 15.5 mm
