ronmart17/nova-robot/mechanics/printed_parts/NOVA_dock_tongue.step

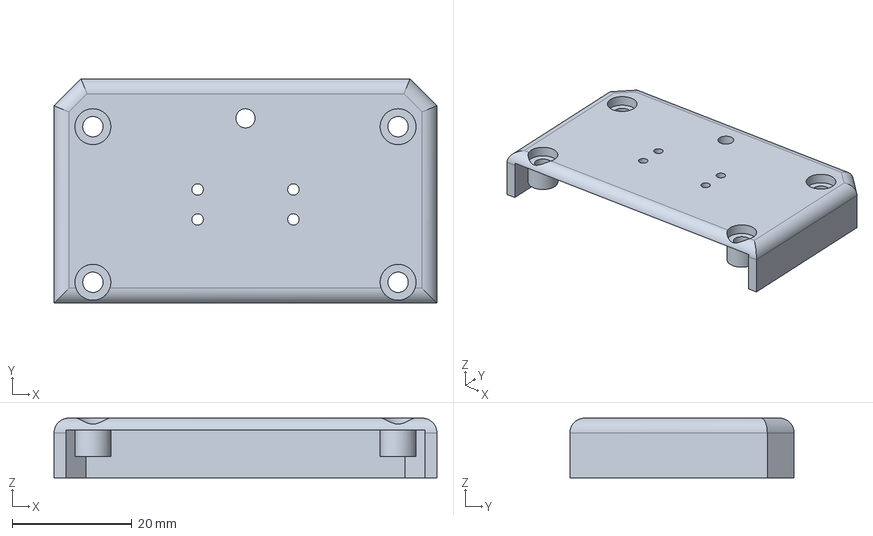
[picture p66: CAD file, 2026-11-02]
mechanics/printed_parts/NOVA_dock_tongue.step
64.0 x 37.5 x 10.0 mm
