ronmart17/nova-robot/mechanics/printed_parts/NOVA_dock_tower.step

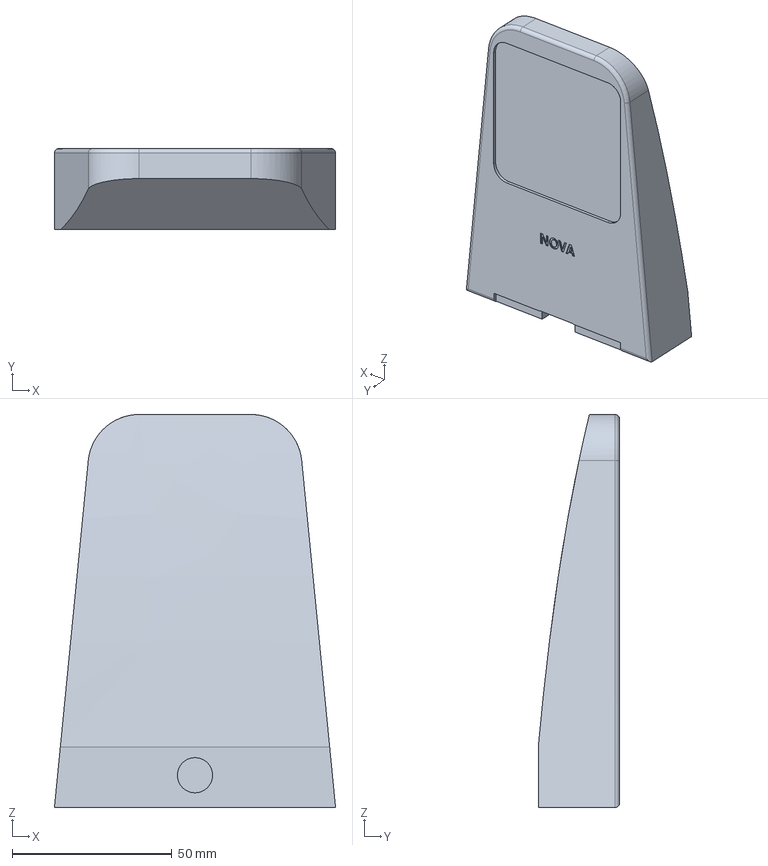
[picture p67: CAD file, 2026-11-02]
mechanics/printed_parts/NOVA_dock_tower.step
88.0 x 25.5 x 123.0 mm
