ronmart17/nova-robot/mechanics/printed_parts/NOVA_halo.step

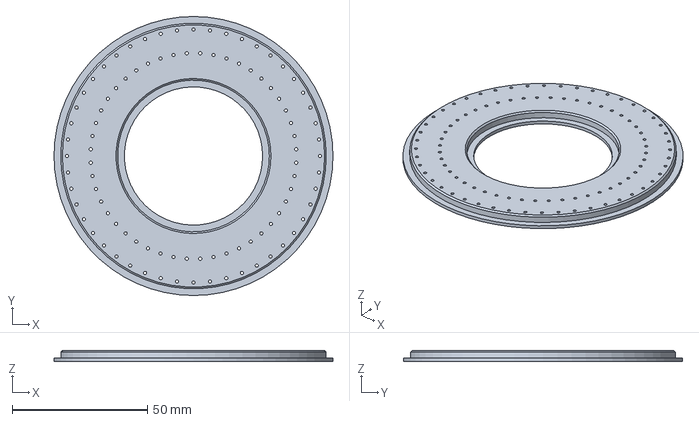
[picture p68: CAD file, 2026-11-02]
mechanics/printed_parts/NOVA_halo.step
103.0 x 103.0 x 4.00 mm
