ronmart17/nova-robot/mechanics/printed_parts/NOVA_top_cap.step

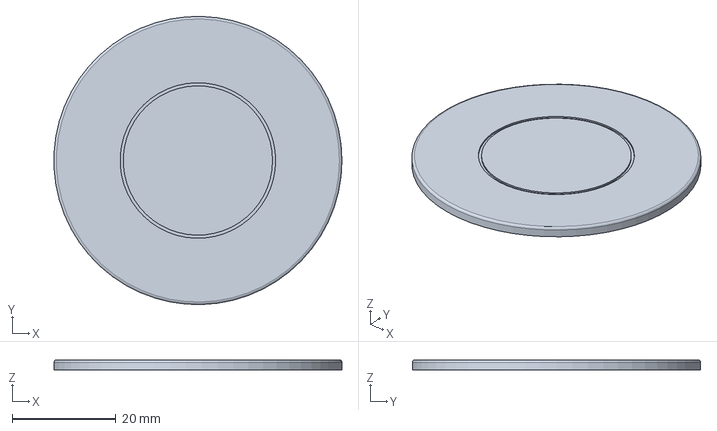
[picture p69: CAD file, 2026-11-02]
mechanics/printed_parts/NOVA_top_cap.step
55.6 x 55.6 x 2.00 mm
