ronmart17/nova-robot/mechanics/printed_parts/NOVA_dock_plate_bar.step

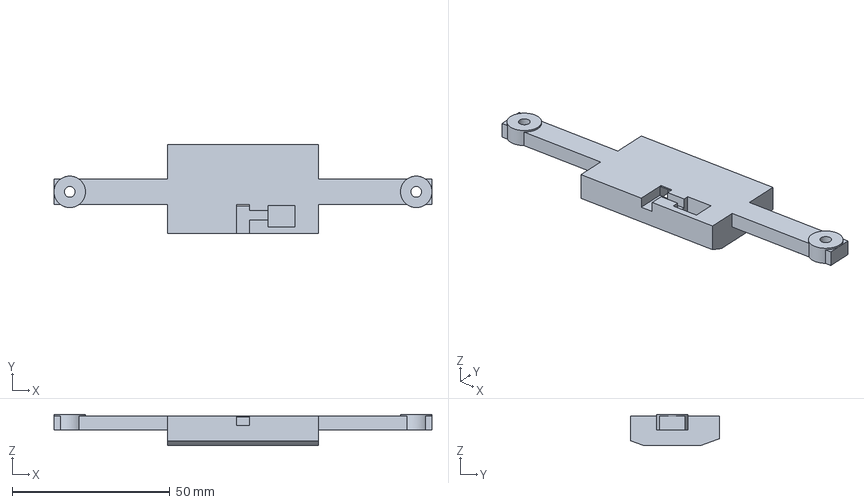
[picture p70: CAD file, 2026-11-02]
mechanics/printed_parts/NOVA_dock_plate_bar.step
120.0 x 28.2 x 9.90 mm
