ronmart17/nova-robot/mechanics/printed_parts/NOVA_dock_base.step

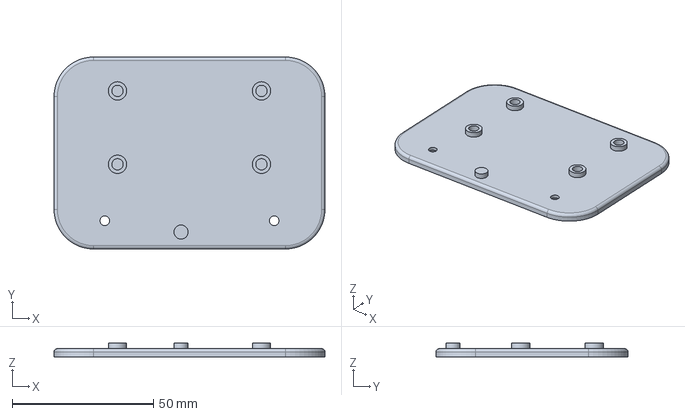
[picture p71: CAD file, 2026-11-02]
mechanics/printed_parts/NOVA_dock_base.step
96.0 x 68.0 x 4.99 mm
