ronmart17/nova-robot/mechanics/printed_parts/NOVA_shell_skirt.step

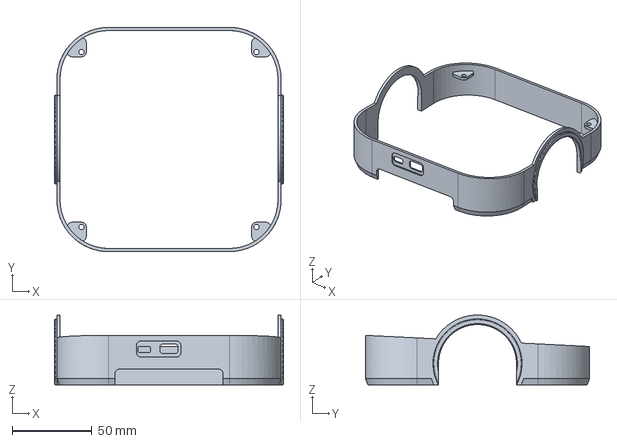
[picture p72: CAD file, 2026-11-02]
mechanics/printed_parts/NOVA_shell_skirt.step
144.0 x 141.0 x 44.0 mm
