ronmart17/nova-robot/mechanics/printed_parts/NOVA_visor.step

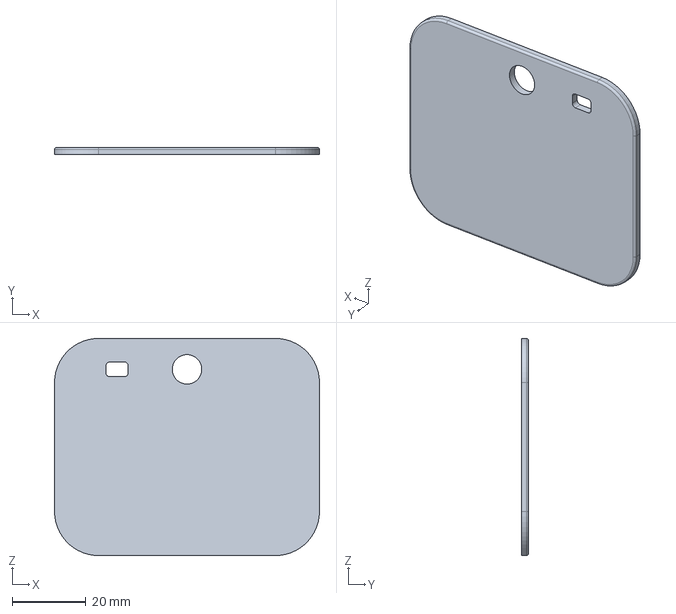
[picture p73: CAD file, 2026-11-02]
mechanics/printed_parts/NOVA_visor.step
72.0 x 2.00 x 59.0 mm
