ronmart17/nova-robot/mechanics/printed_parts/NOVA_shell_upper.step

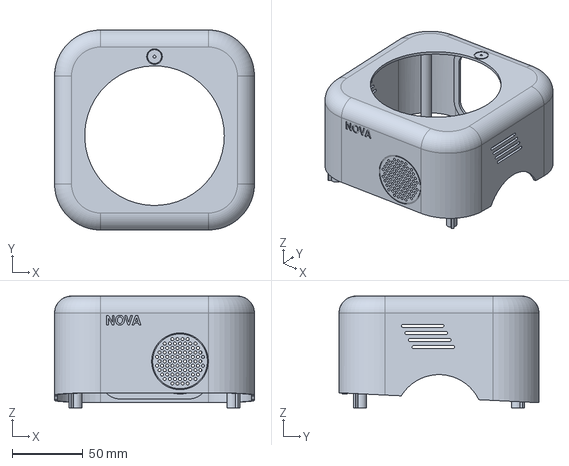
[picture p74: CAD file, 2026-11-02]
mechanics/printed_parts/NOVA_shell_upper.step
141.0 x 141.0 x 78.9 mm
