ronmart17/nova-robot/mechanics/printed_parts/NOVA_top_deck.step

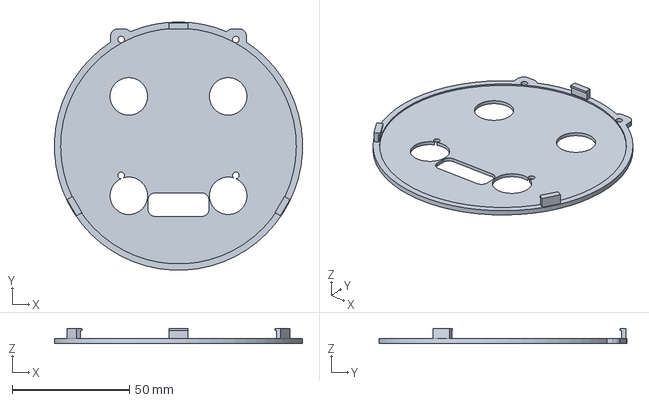
[picture p75: CAD file, 2026-11-02]
mechanics/printed_parts/NOVA_top_deck.step
105.9 x 105.9 x 6.20 mm
