ronmart17/nova-robot/(list of files, cad)

Other CAD files:
mechanics/printed_parts/NOVA_head_bracket_L.step
mechanics/printed_parts/NOVA_battery_cage.stl
mechanics/printed_parts/NOVA_dock_base.stl
mechanics/printed_parts/NOVA_dock_lightpipe.stl
mechanics/printed_parts/NOVA_dock_plate_bar.stl
mechanics/printed_parts/NOVA_dock_tag_panel.stl
mechanics/printed_parts/NOVA_dock_tongue.stl
mechanics/printed_parts/NOVA_dock_tower.stl
mechanics/printed_parts/NOVA_halo.stl
mechanics/printed_parts/NOVA_head_bracket_L.stl
mechanics/printed_parts/NOVA_head_bracket_R.stl
mechanics/printed_parts/NOVA_shell_skirt.stl
mechanics/printed_parts/NOVA_shell_upper.stl
mechanics/printed_parts/NOVA_top_cap.stl
mechanics/printed_parts/NOVA_top_deck.stl
mechanics/printed_parts/NOVA_visor.stl
