ronmart17/nova-robot/hardware/nova-dock/fabrication/nova-dock_3d_bottom.png

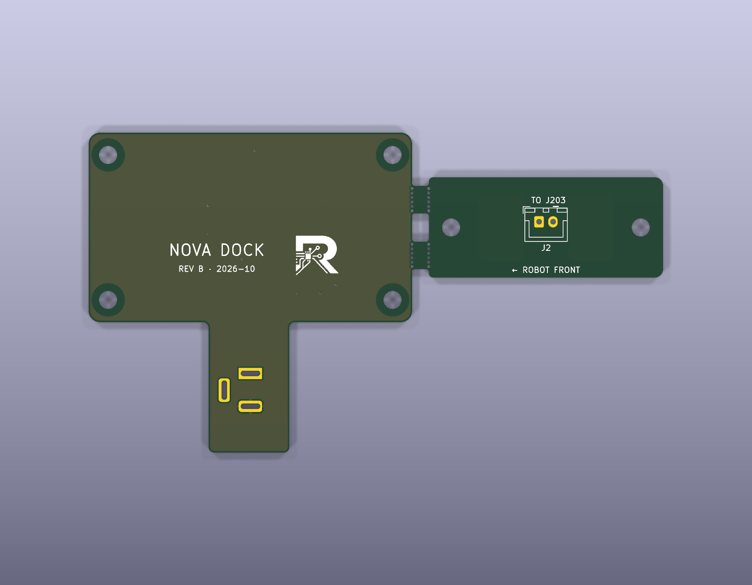
hardware/nova-dock/fabrication/nova-dock_3d_bottom.png
