ronmart17/nova-robot/hardware/nova-head/fabrication/nova-head_3d_bottom.png

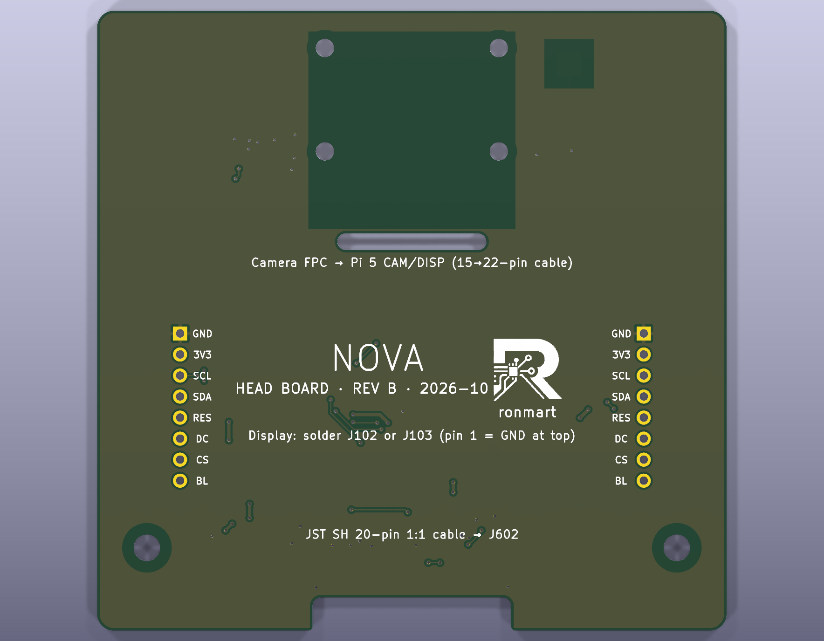
hardware/nova-head/fabrication/nova-head_3d_bottom.png
