ronmart17/nova-robot/hardware/nova-main/fabrication/nova-main_3d_bottom.png

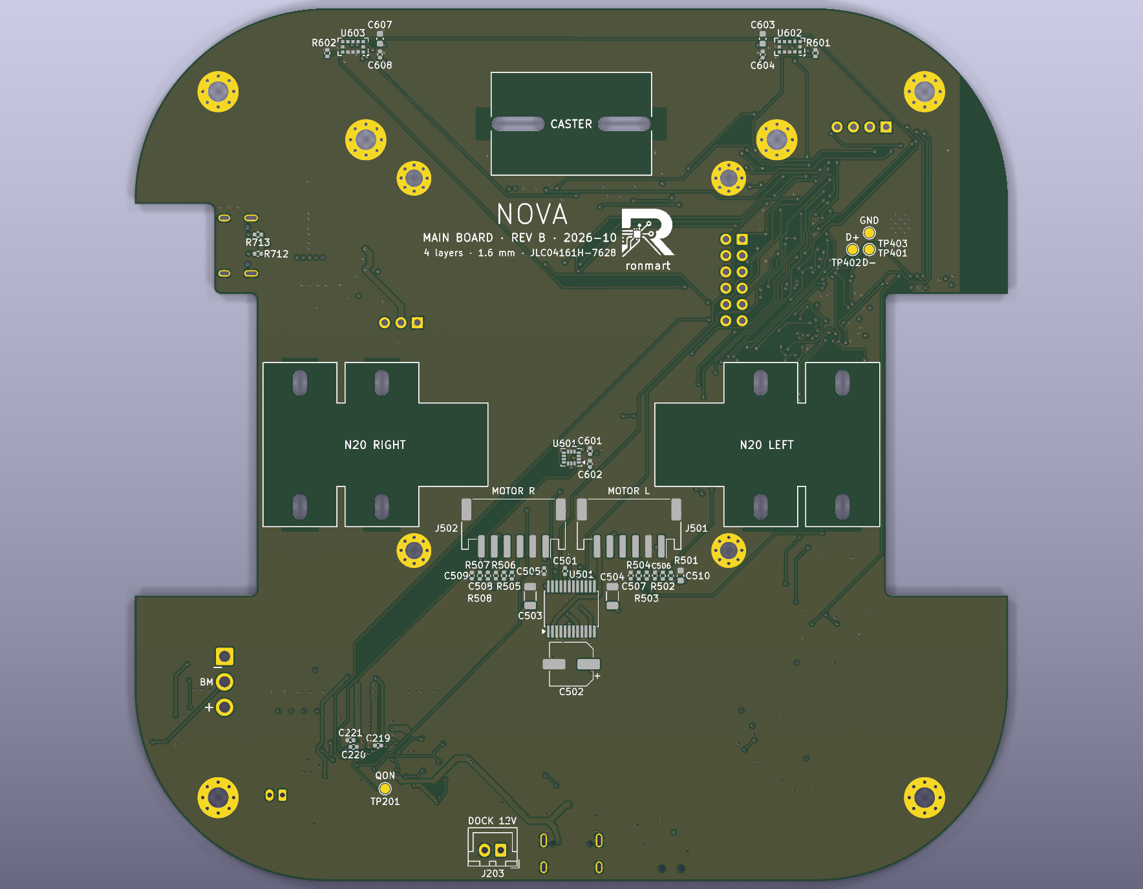
hardware/nova-main/fabrication/nova-main_3d_bottom.png
