ronmart17/nova-robot/hardware/nova-dock/fabrication/nova-dock_assembly_bottom.pdf

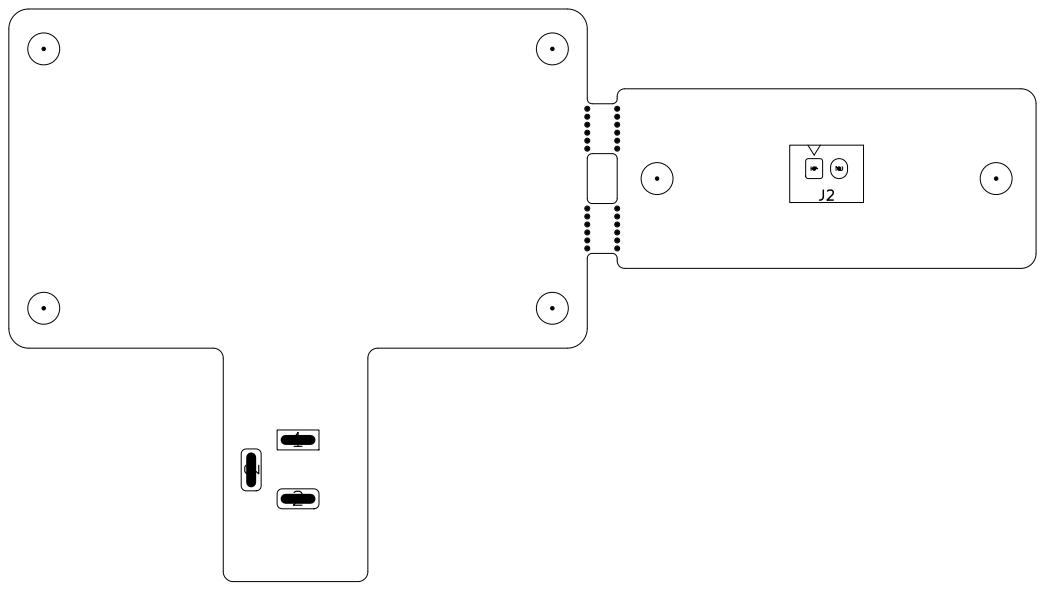
[picture p82: page 1]

ronmart · Caril Ronnie Martínez Vera
Sheet:
File: nova-dock.kicad_pcb
Title: NOVA — Charging dock and robot contact plate

Size: A4 | Rev: B
KiCad E.D.A. 10.0.7 | Id: 1/1
