ronmart17/nova-robot/hardware/nova-dock/fabrication/nova-dock_copper_layers.pdf

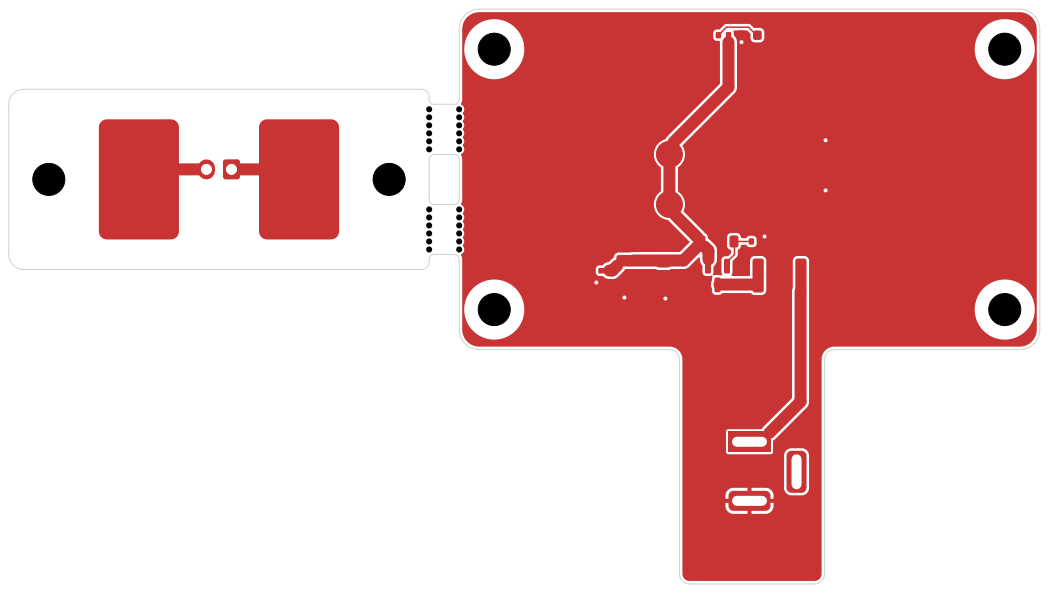
[picture p83: page 1]

ronmart · Caril Ronnie Martínez Vera
Sheet:
File: nova-dock.kicad_pcb
Title: NOVA — Charging dock and robot contact plate

Size: A4 | Rev: B
KiCad E.D.A. 10.0.7 | Id: 1/2

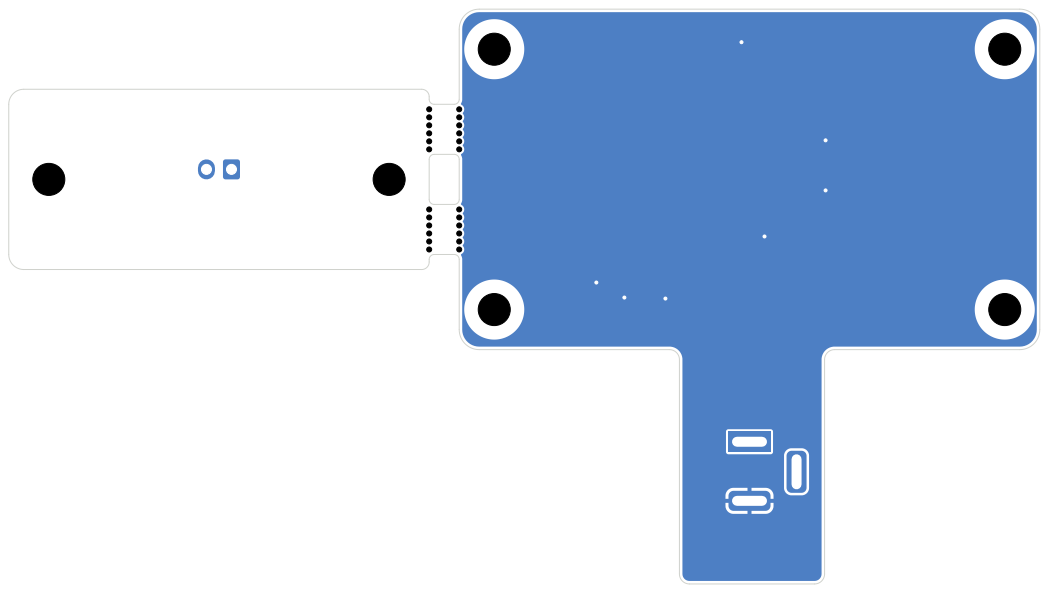
[picture p84: page 2]
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

Size: A4 | Rev: B
KiCad E.D.A. 10.0.7 | Id: 2/2
