ronmart17/nova-robot/hardware/nova-head/fabrication/nova-head_assembly_bottom.pdf

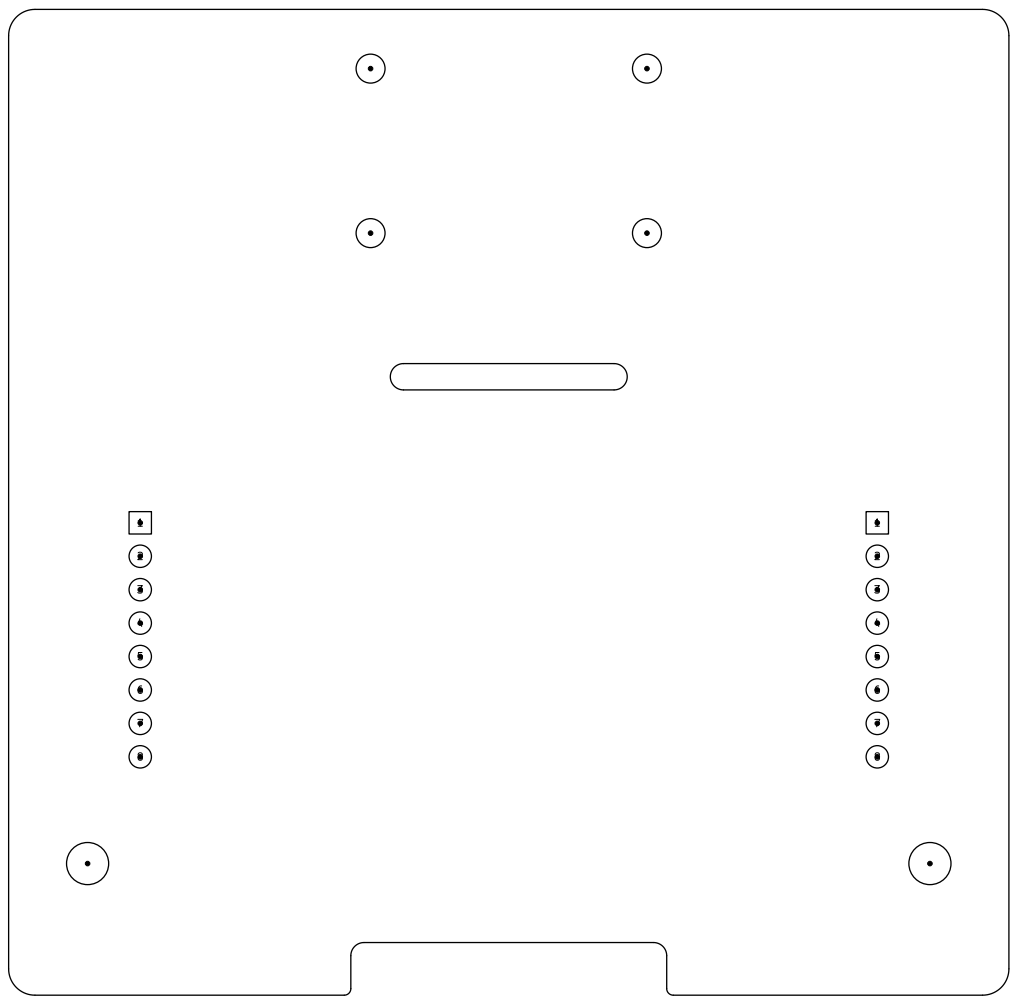
[picture p85: page 1]

ronmart · Caril Ronnie Martínez Vera
Sheet:
File: nova-head.kicad_pcb
Title: NOVA — Head board

Size: A4 | Rev: B
KiCad E.D.A. 10.0.7 | Id: 1/1
