ronmart17/nova-robot/hardware/nova-head/fabrication/nova-head_copper_layers.pdf

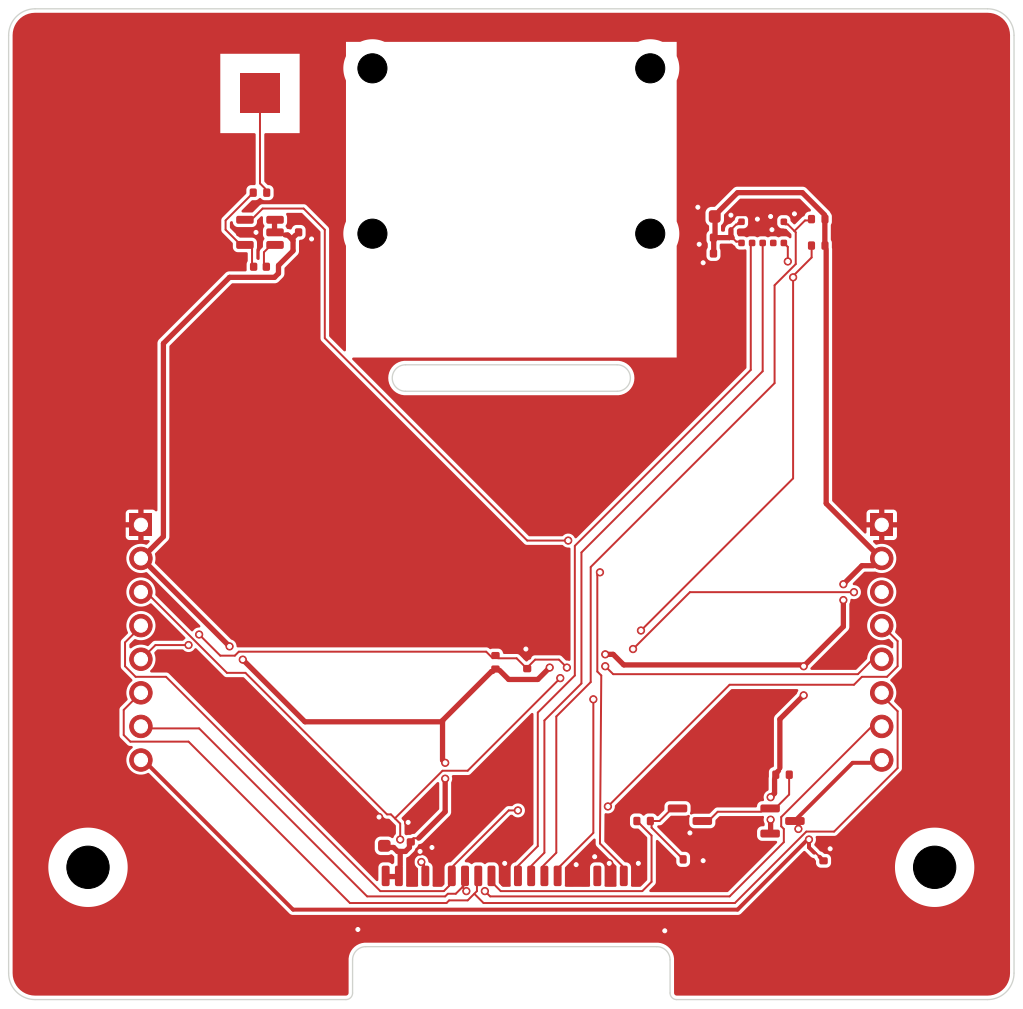
[picture p86: page 1]

ronmart · Caril Ronnie Martínez Vera
Sheet:
File: nova-head.kicad_pcb
Title: NOVA — Head board

Size: A4 | Rev: B
KiCad E.D.A. 10.0.7 | Id: 1/2

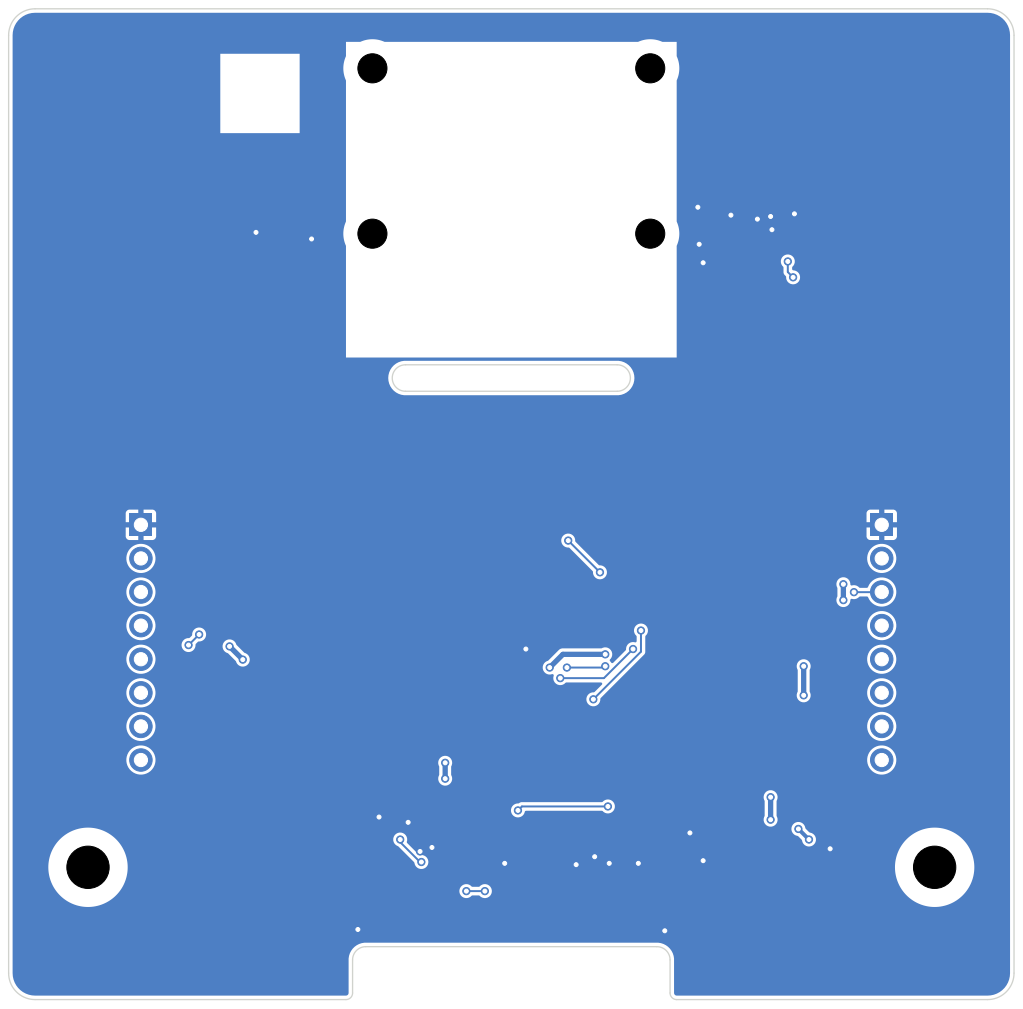
[picture p87: page 2]

ronmart · Caril Ronnie Martínez Vera
Sheet:
File: nova-head.kicad_pcb
Title: NOVA — Head board

Size: A4 | Rev: B
KiCad E.D.A. 10.0.7 | Id: 2/2
