ronmart17/nova-robot/hardware/nova-head/fabrication/nova-head_mechanical_1to1.pdf

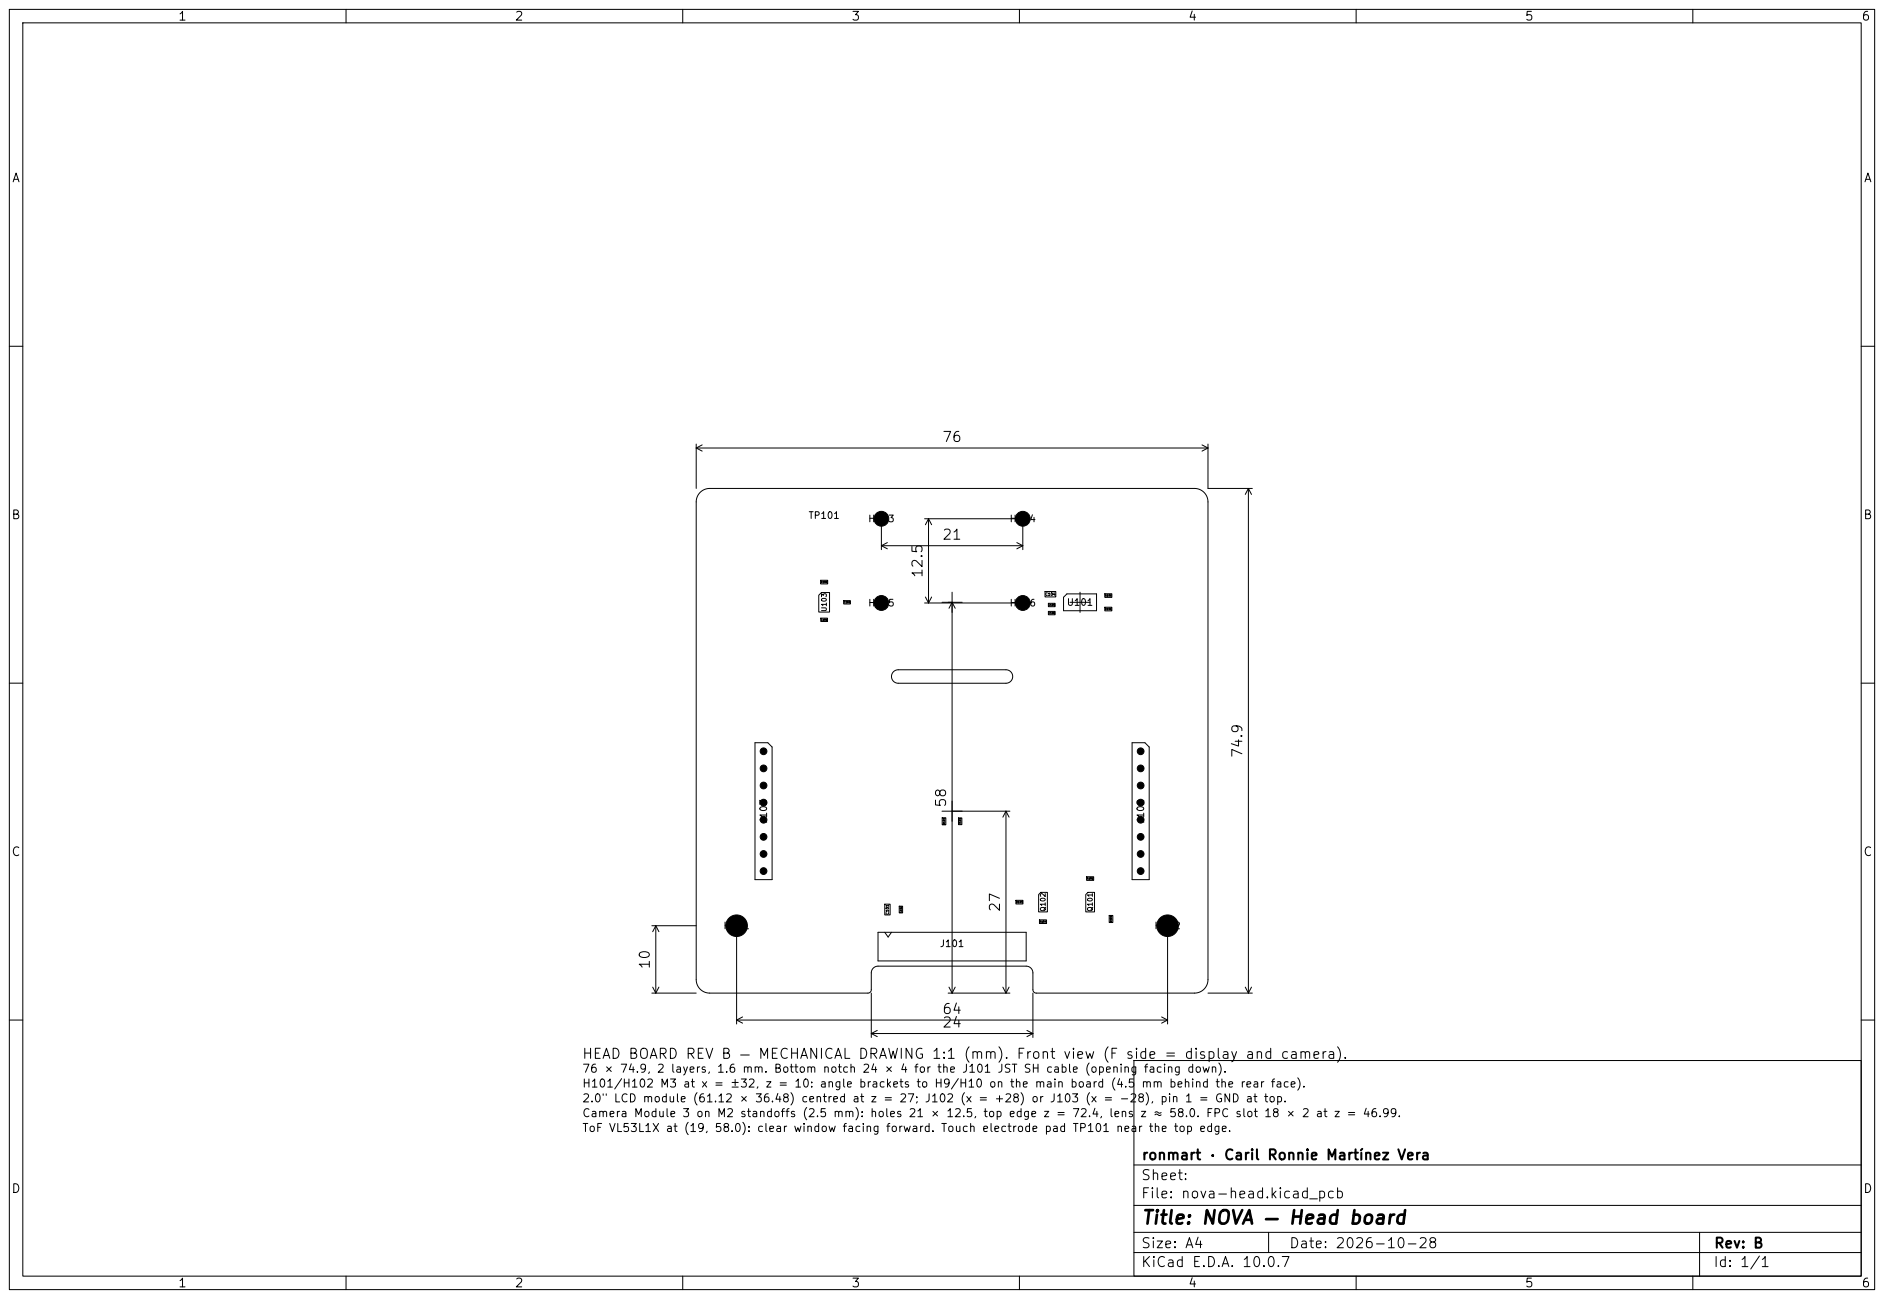
[picture p88: page 1]

HEAD BOARD REV B — MECHANICAL DRAWING 1:1 (mm). Front view (F side = display and camera).
76 × 74.9, 2 layers, 1.6 mm. Bottom notch 24 × 4 for the J101 JST SH cable (opening facing down).

ronmart · Caril Ronnie Martínez Vera
Sheet:
File: nova-head.kicad_pcb
Title: NOVA — Head board

Size: A4 | Rev: B
KiCad E.D.A. 10.0.7 | Id: 1/1
