ronmart17/nova-robot/hardware/nova-main/fabrication/nova-main_assembly_bottom.pdf

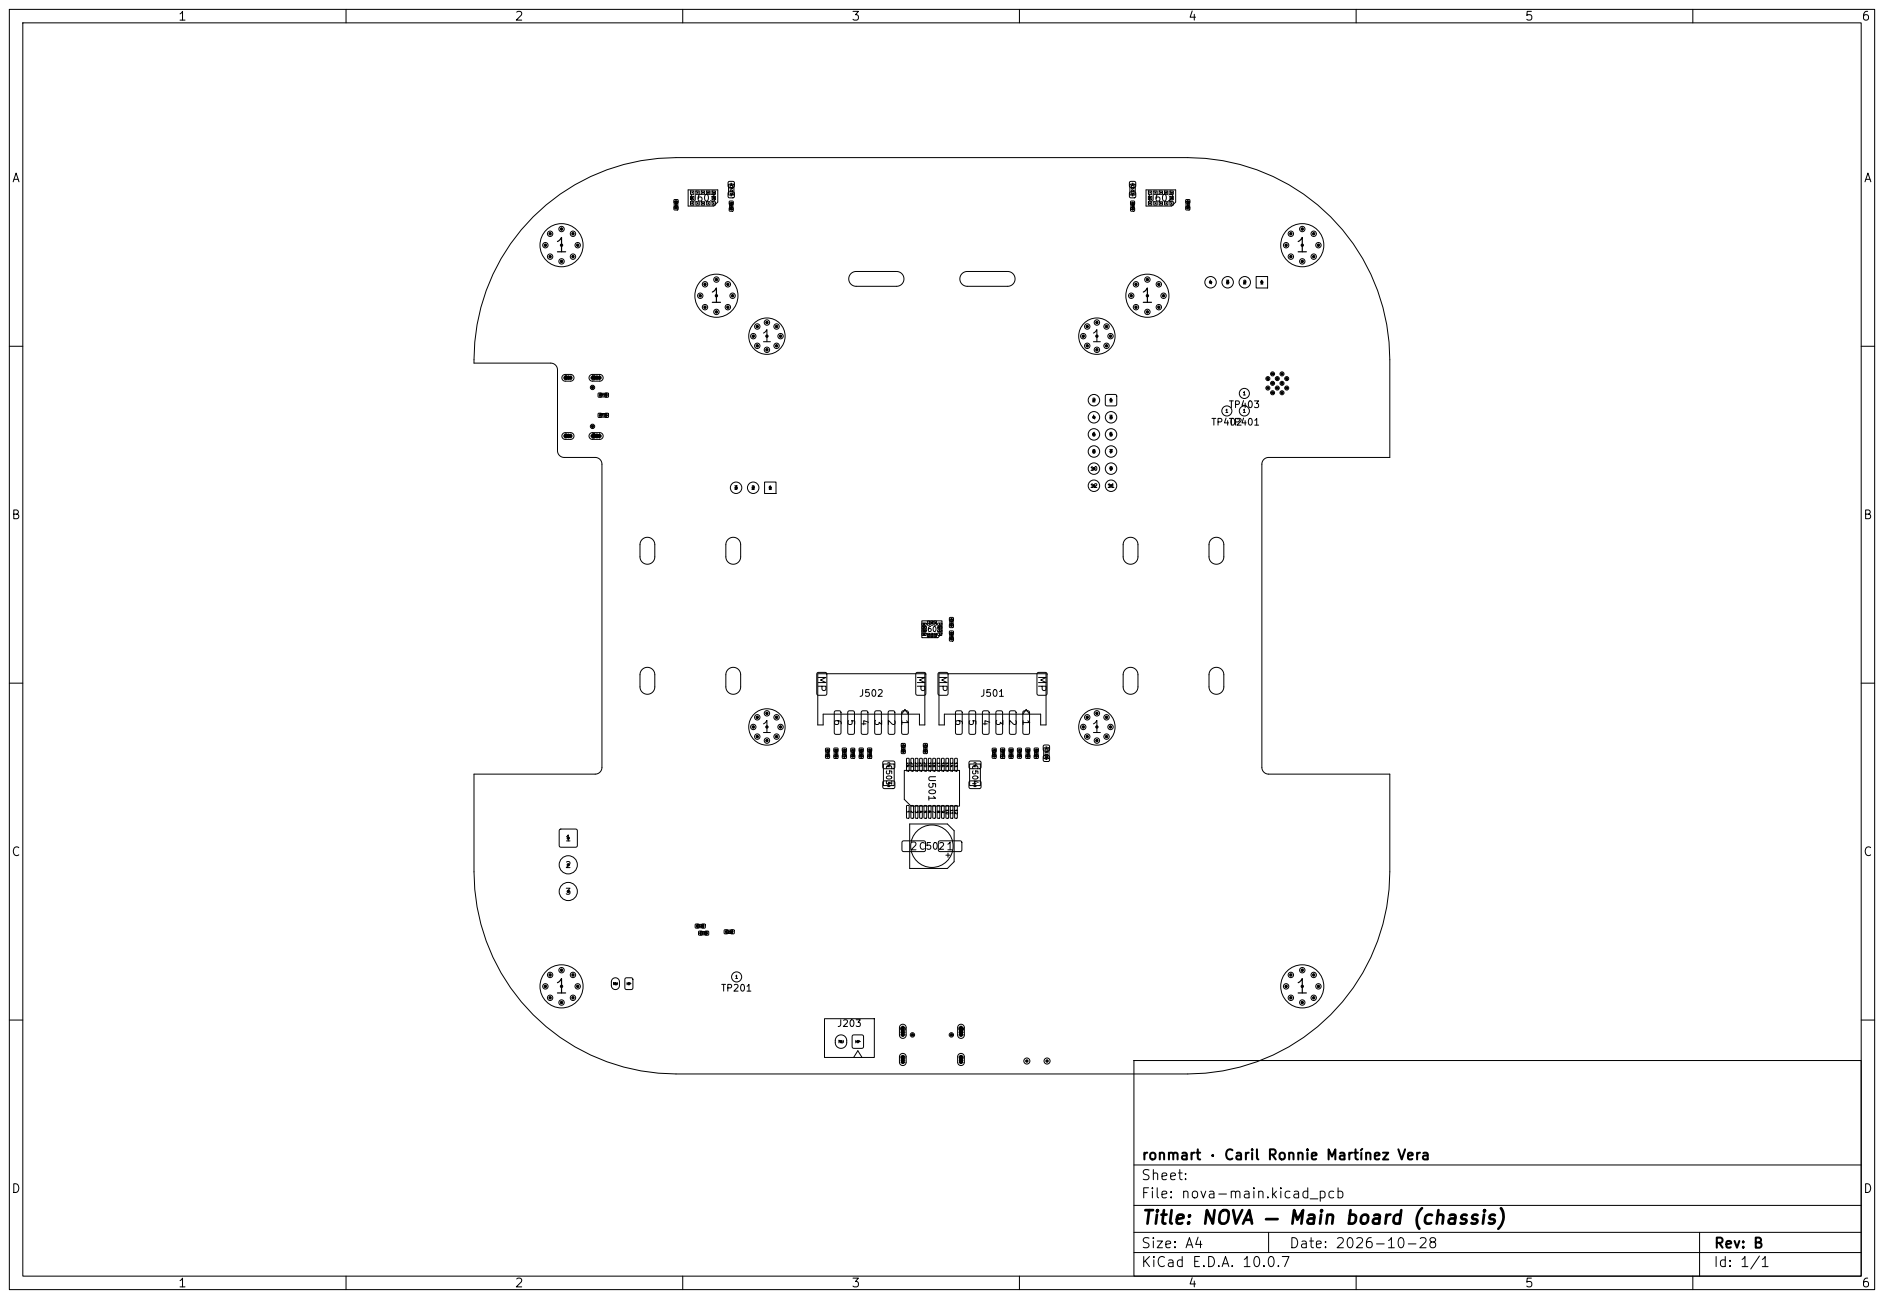
[picture p89: page 1]

Sheet:
File: nova-main.kicad_pcb
Title: NOVA — Main board (chassis)

Size: A4 | Rev: B
KiCad E.D.A. 10.0.7 | Id: 1/1
