ronmart17/nova-robot/hardware/nova-main/fabrication/nova-main_copper_layers.pdf

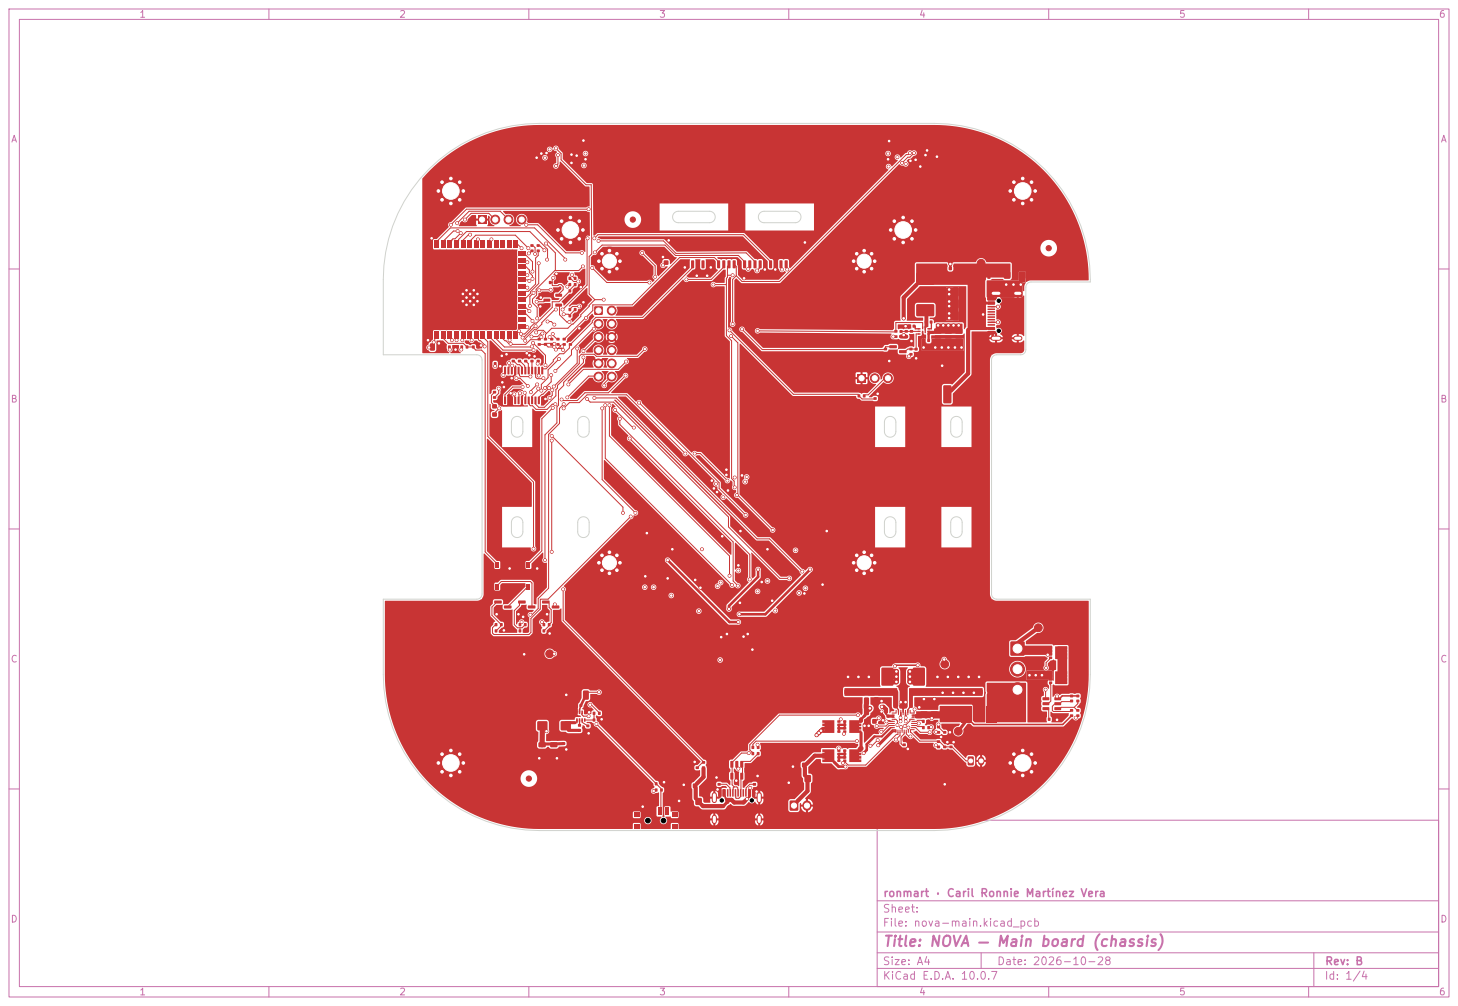
[picture p90: page 1]

ronmart · Caril Ronnie Martínez Vera
Sheet:
File: nova-main.kicad_pcb
Title: NOVA — Main board (chassis)

Size: A4 | Rev: B
KiCad E.D.A. 10.0.7 | Id: 1/4

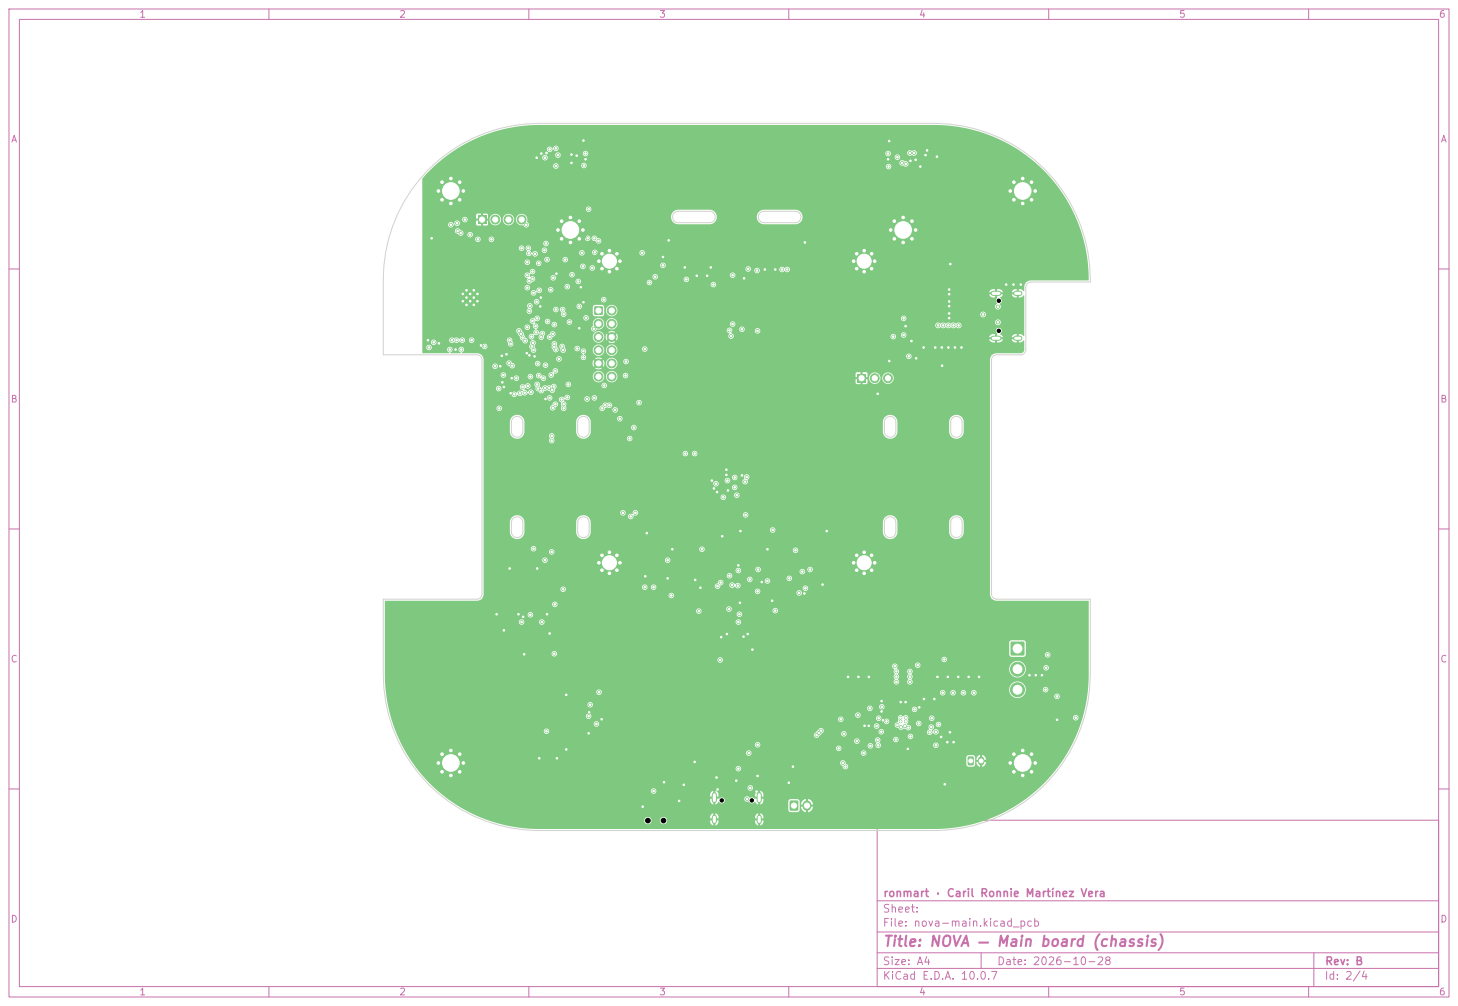
[picture p91: page 2]

ronmart · Caril Ronnie Martínez Vera
Sheet:
File: nova-main.kicad_pcb
Title: NOVA — Main board (chassis)

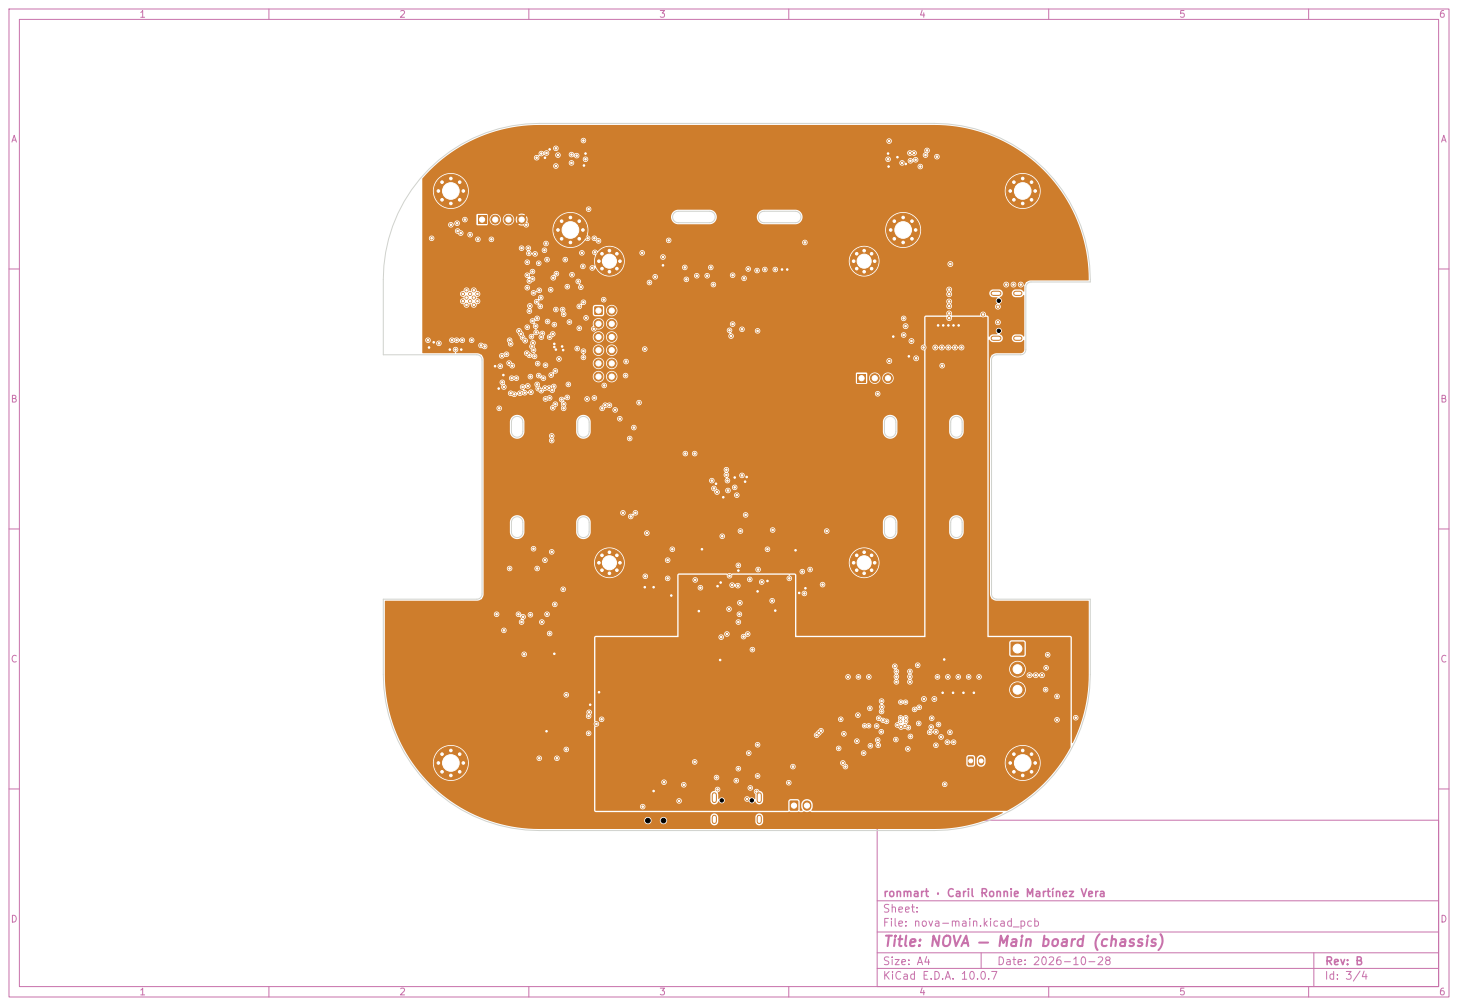
[picture p92: page 3]

ronmart · Caril Ronnie Martínez Vera
Sheet:
File: nova-main.kicad_pcb
Title: NOVA — Main board (chassis)

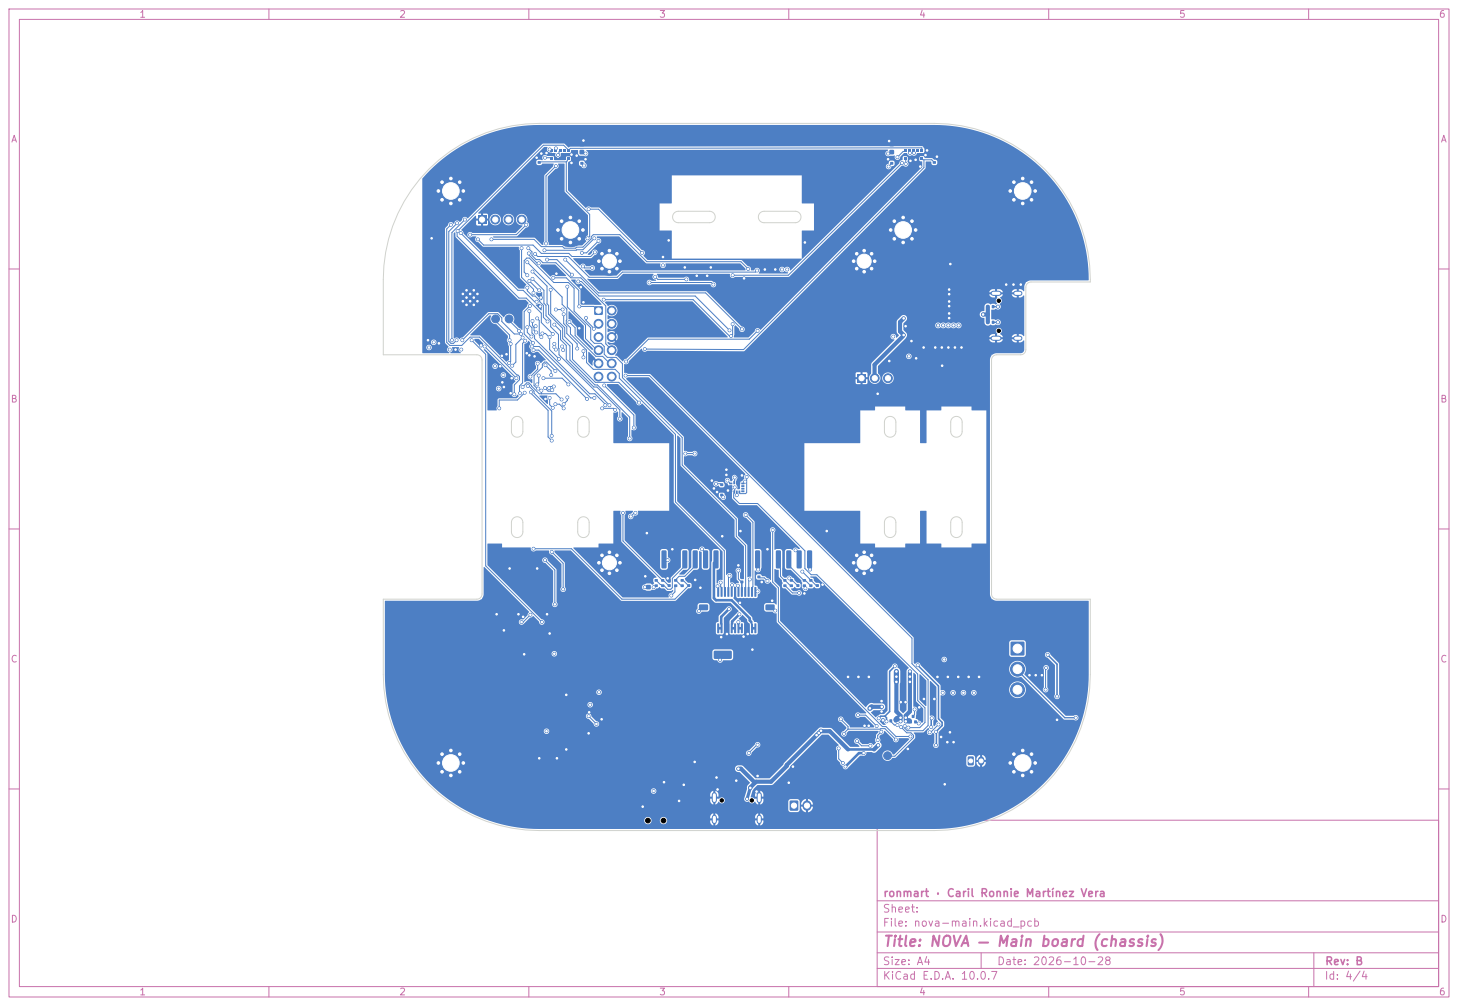
[picture p93: page 4]

ronmart · Caril Ronnie Martínez Vera
Sheet:
File: nova-main.kicad_pcb
Title: NOVA — Main board (chassis)
