ronmart17/nova-robot/hardware/nova-dock/nova-dock.kicad_pcb

## KiCad design hardware/nova-dock/nova-dock.kicad_pcb (2026-11-02)

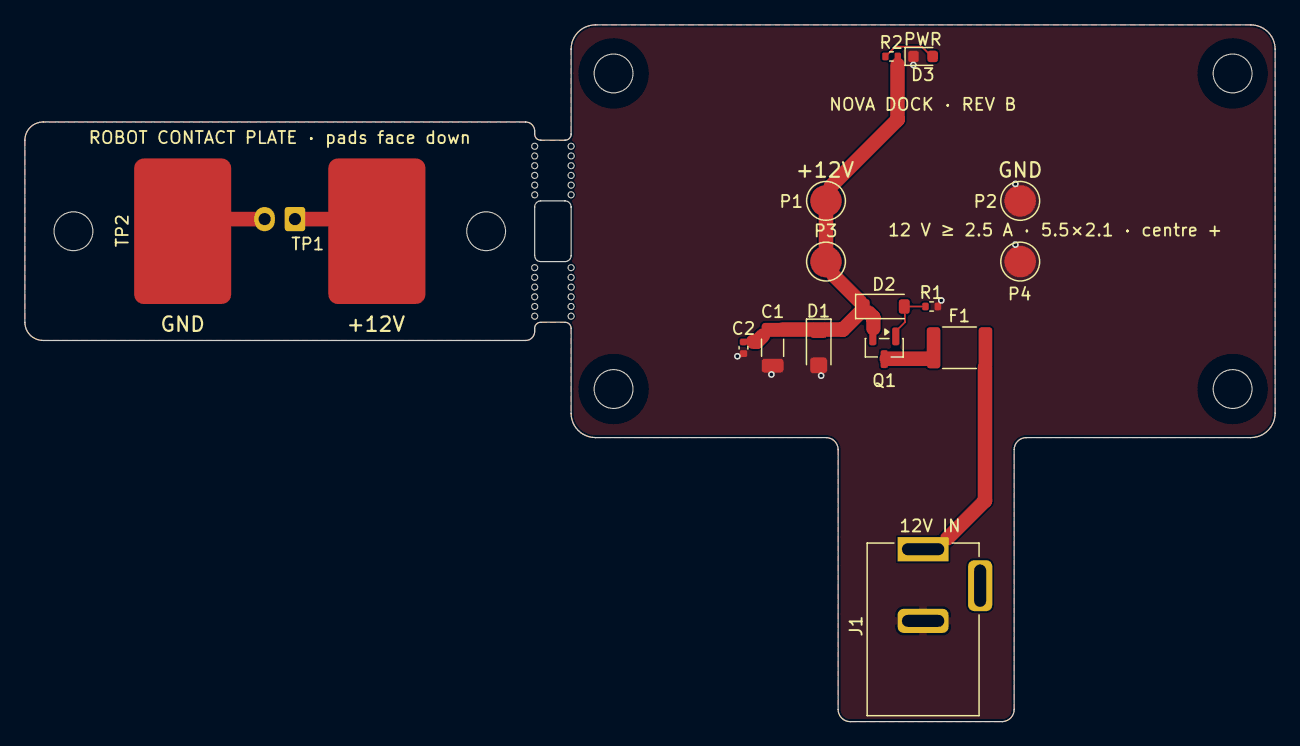
[picture p95: board nova-dock.kicad_pcb from above]

Board: 2 copper layers, 103.0 x 57.4 mm, 25 parts (1 on the bottom side), 8 nets.

Parts:
C1: 22u/25V; C_1206_3216Metric
C2: 100n; C_0402_1005Metric
D1: SMF15A; D_SMF
D2: BZT52C10; D_SOD-123
D3: Green; LED_0603_1608Metric
F1: 3A hold; Fuse_1812_4532Metric
H1, H2, H3, H4, H5, H6: M3; MountingHole_3.2mm_M3
J1: 12V IN; DC_Jack_XKB_DC-005-5A-2.0_Horizontal
J2: TO ROBOT; JST_XH_B2B-XH-A_1x02_P2.50mm_Vertical
MB1, MB2: TAB; MouseBite_Tab_5x3mm
P1, P2, P3, P4: POGO; Pogo_YTC1P-8020_D2.0mm
Q1: AO3401A; SOT-23
R1: 10k; R_0402_1005Metric
R2: 4.7k; R_0402_1005Metric
TP1, TP2: CONTACT; ContactPad_8x12mm

Connections:
/PLATE_GND: J2.2, TP2.1 (1_1)
/PLATE_POS: J2.1, TP1.1 (1_1)
/VDOCK_OUT: C1.1, C2.1, D1.1 (A1), D2.1 (K), P1.1 (Pin_1_1), P3.1 (Pin_1_1), Q1.2 (S), R2.1
GND: C1.2, C2.2, D1.2 (A2), D3.1 (K), J1.2, P2.1 (Pin_1_1), P4.1 (Pin_1_1), R1.2
unnamed: D2.2 (A), Q1.1 (G), R1.1
unnamed: D3.2 (A), R2.2
unnamed: F1.1, J1.1
unnamed: F1.2, Q1.3 (D)
