ronmart17/nova-robot/hardware/nova-head/nova-head.kicad_pcb

## KiCad design hardware/nova-head/nova-head.kicad_pcb (2026-11-02)

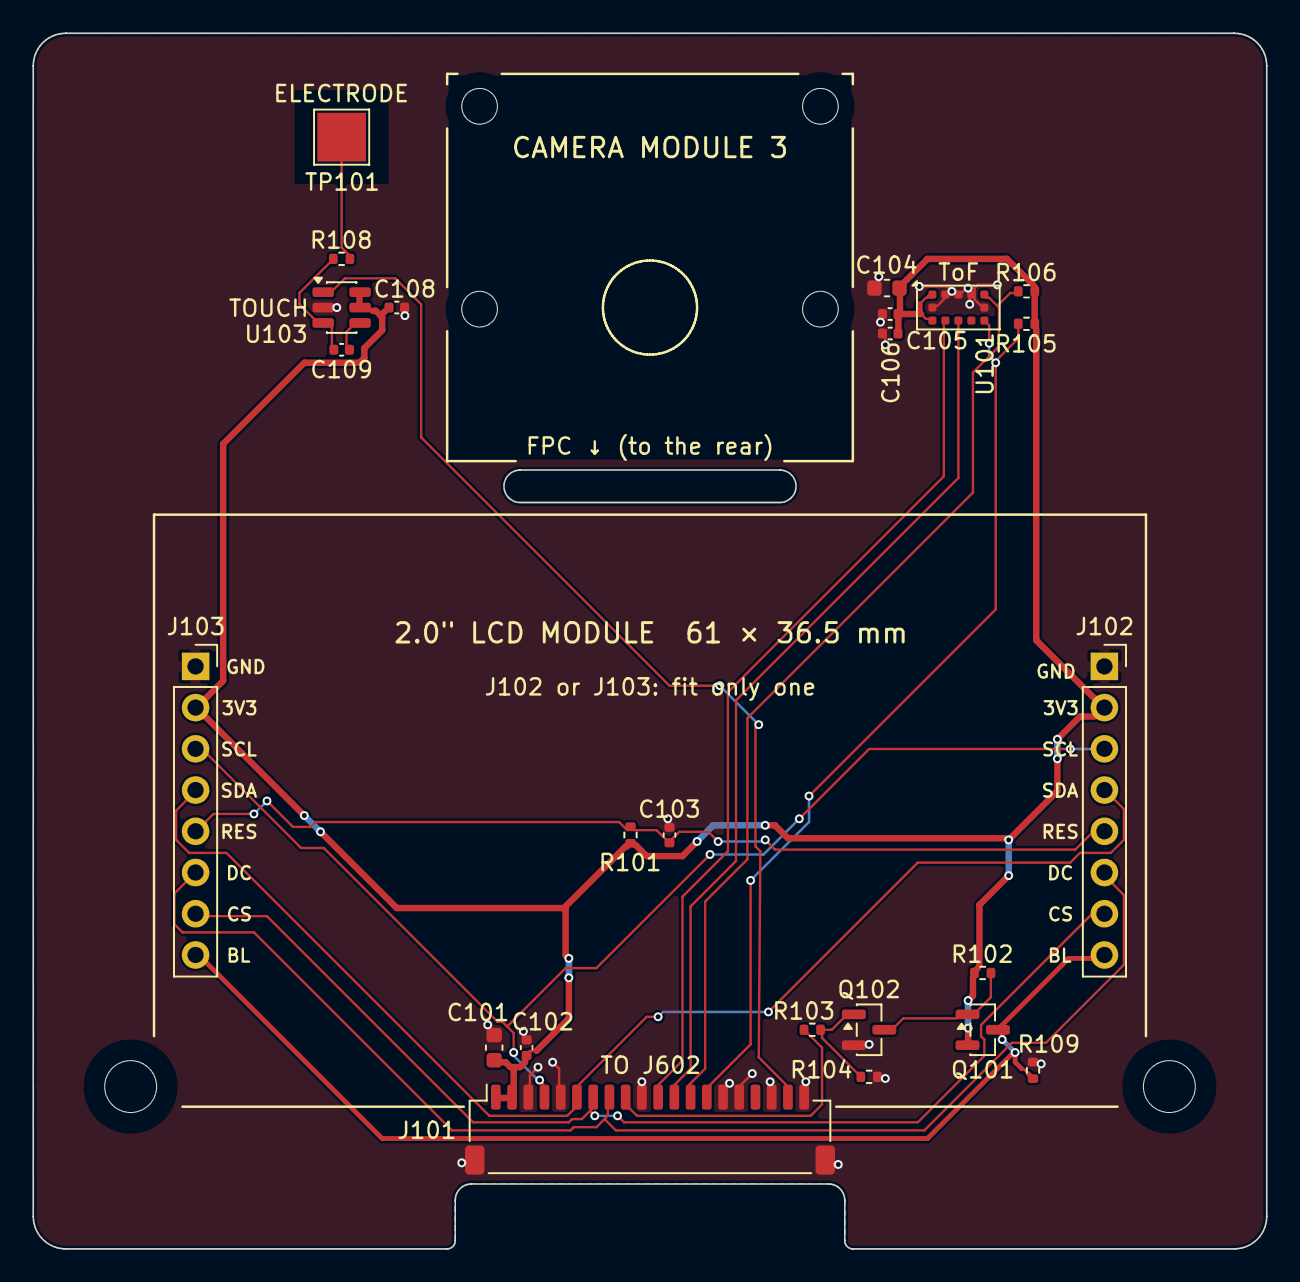
[picture p96: board nova-head.kicad_pcb from above]

Board: 2 copper layers, 76.0 x 74.9 mm, 30 parts (0 on the bottom side), 19 nets.

Parts:
C101: 10u/10V; C_0603_1608Metric
C102, C103, C105, C106, C108: 100n; C_0402_1005Metric
C104: 4.7u/16V; C_0603_1608Metric
C109: 8.2n; C_0402_1005Metric
H101, H102: M3; MountingHole_3.2mm_M3
H103, H104, H105, H106: M2; MountingHole_2.2mm_M2
J101: HEAD; JST_SH_SM20B-SRSS-TB_1x20-1MP_P1.00mm_Horizontal
J102, J103: LCD ST7789; PinSocket_1x08_P2.54mm_Vertical
Q101: AO3401A; SOT-23
Q102: 2N7002LT1G; SOT-23
R101, R102, R105, R106: 10k; R_0402_1005Metric
R103: 100R; R_0402_1005Metric
R104: 100k; R_0402_1005Metric
R108: 4.7k; R_0402_1005Metric
R109: 1k; R_0402_1005Metric
TP101: TOUCH; TestPoint_Pad_3.0x3.0mm
U101: VL53L1CXV0FY/1; ST_VL53L1x
U103: AT42QT1010-TSHR; SOT-23-6

Connections:
+3V3: C101.1, C102.1, C104.1, C105.1, C106.1, C108.1, J101.1, J101.2, J102.2, J103.2, Q101.2 (S), R101.1, R102.1, R105.1, R106.1, U101.1 (AVDDVCSEL), U101.11 (AVDD), U103.5 (VDD), U103.6 (SYNC)
/BL_OUT: J102.8, J103.8, Q101.3 (D), R109.1
/I2C_SCL: J101.11, U101.10 (SCL)
/I2C_SDA: J101.12, U101.9 (SDA)
/LCD_BL: J101.9, R103.1
/LCD_CS: J101.7, J102.7, J103.7
/LCD_DC: J101.8, J102.6, J103.6
/LCD_MOSI: J101.6, J102.4, J103.4
/LCD_RES: C103.1, J102.5, J103.5, R101.2
/LCD_SCLK: J101.4, J102.3, J103.3
/TOF_INT: J101.14, R105.2, U101.7 (GPIO1)
/TOF_XSHUT: J101.13, R106.2, U101.5 (XSHUT)
/TOUCH: J101.19, U103.1 (OUT)
GND: C101.2, C102.2, C103.2, C104.2, C105.2, C106.2, C108.2, J101.3, J101.5, J101.10, J101.15, J101.16, J101.18, J101.20, J101.MP (MountPin), J102.1, J103.1, Q102.2 (S), R104.2, R109.2, U101.2 (AVSSVCSEL), U101.3 (GND), U101.4 (GND), U101.6 (GND), U101.12 (GND), U103.2 (VSS)
unnamed: Q101.1 (G), Q102.3 (D), R102.2
unnamed: Q102.1 (G), R103.2, R104.1
unnamed: R108.2, TP101.1 (1_1)
unnamed: C109.2, U103.4 (SNS)
unnamed: C109.1, R108.1, U103.3 (SNSK)
