ronmart17/nova-robot/hardware/nova-main/nova-main.kicad_pcb

## KiCad design hardware/nova-main/nova-main.kicad_pcb (2026-11-02)

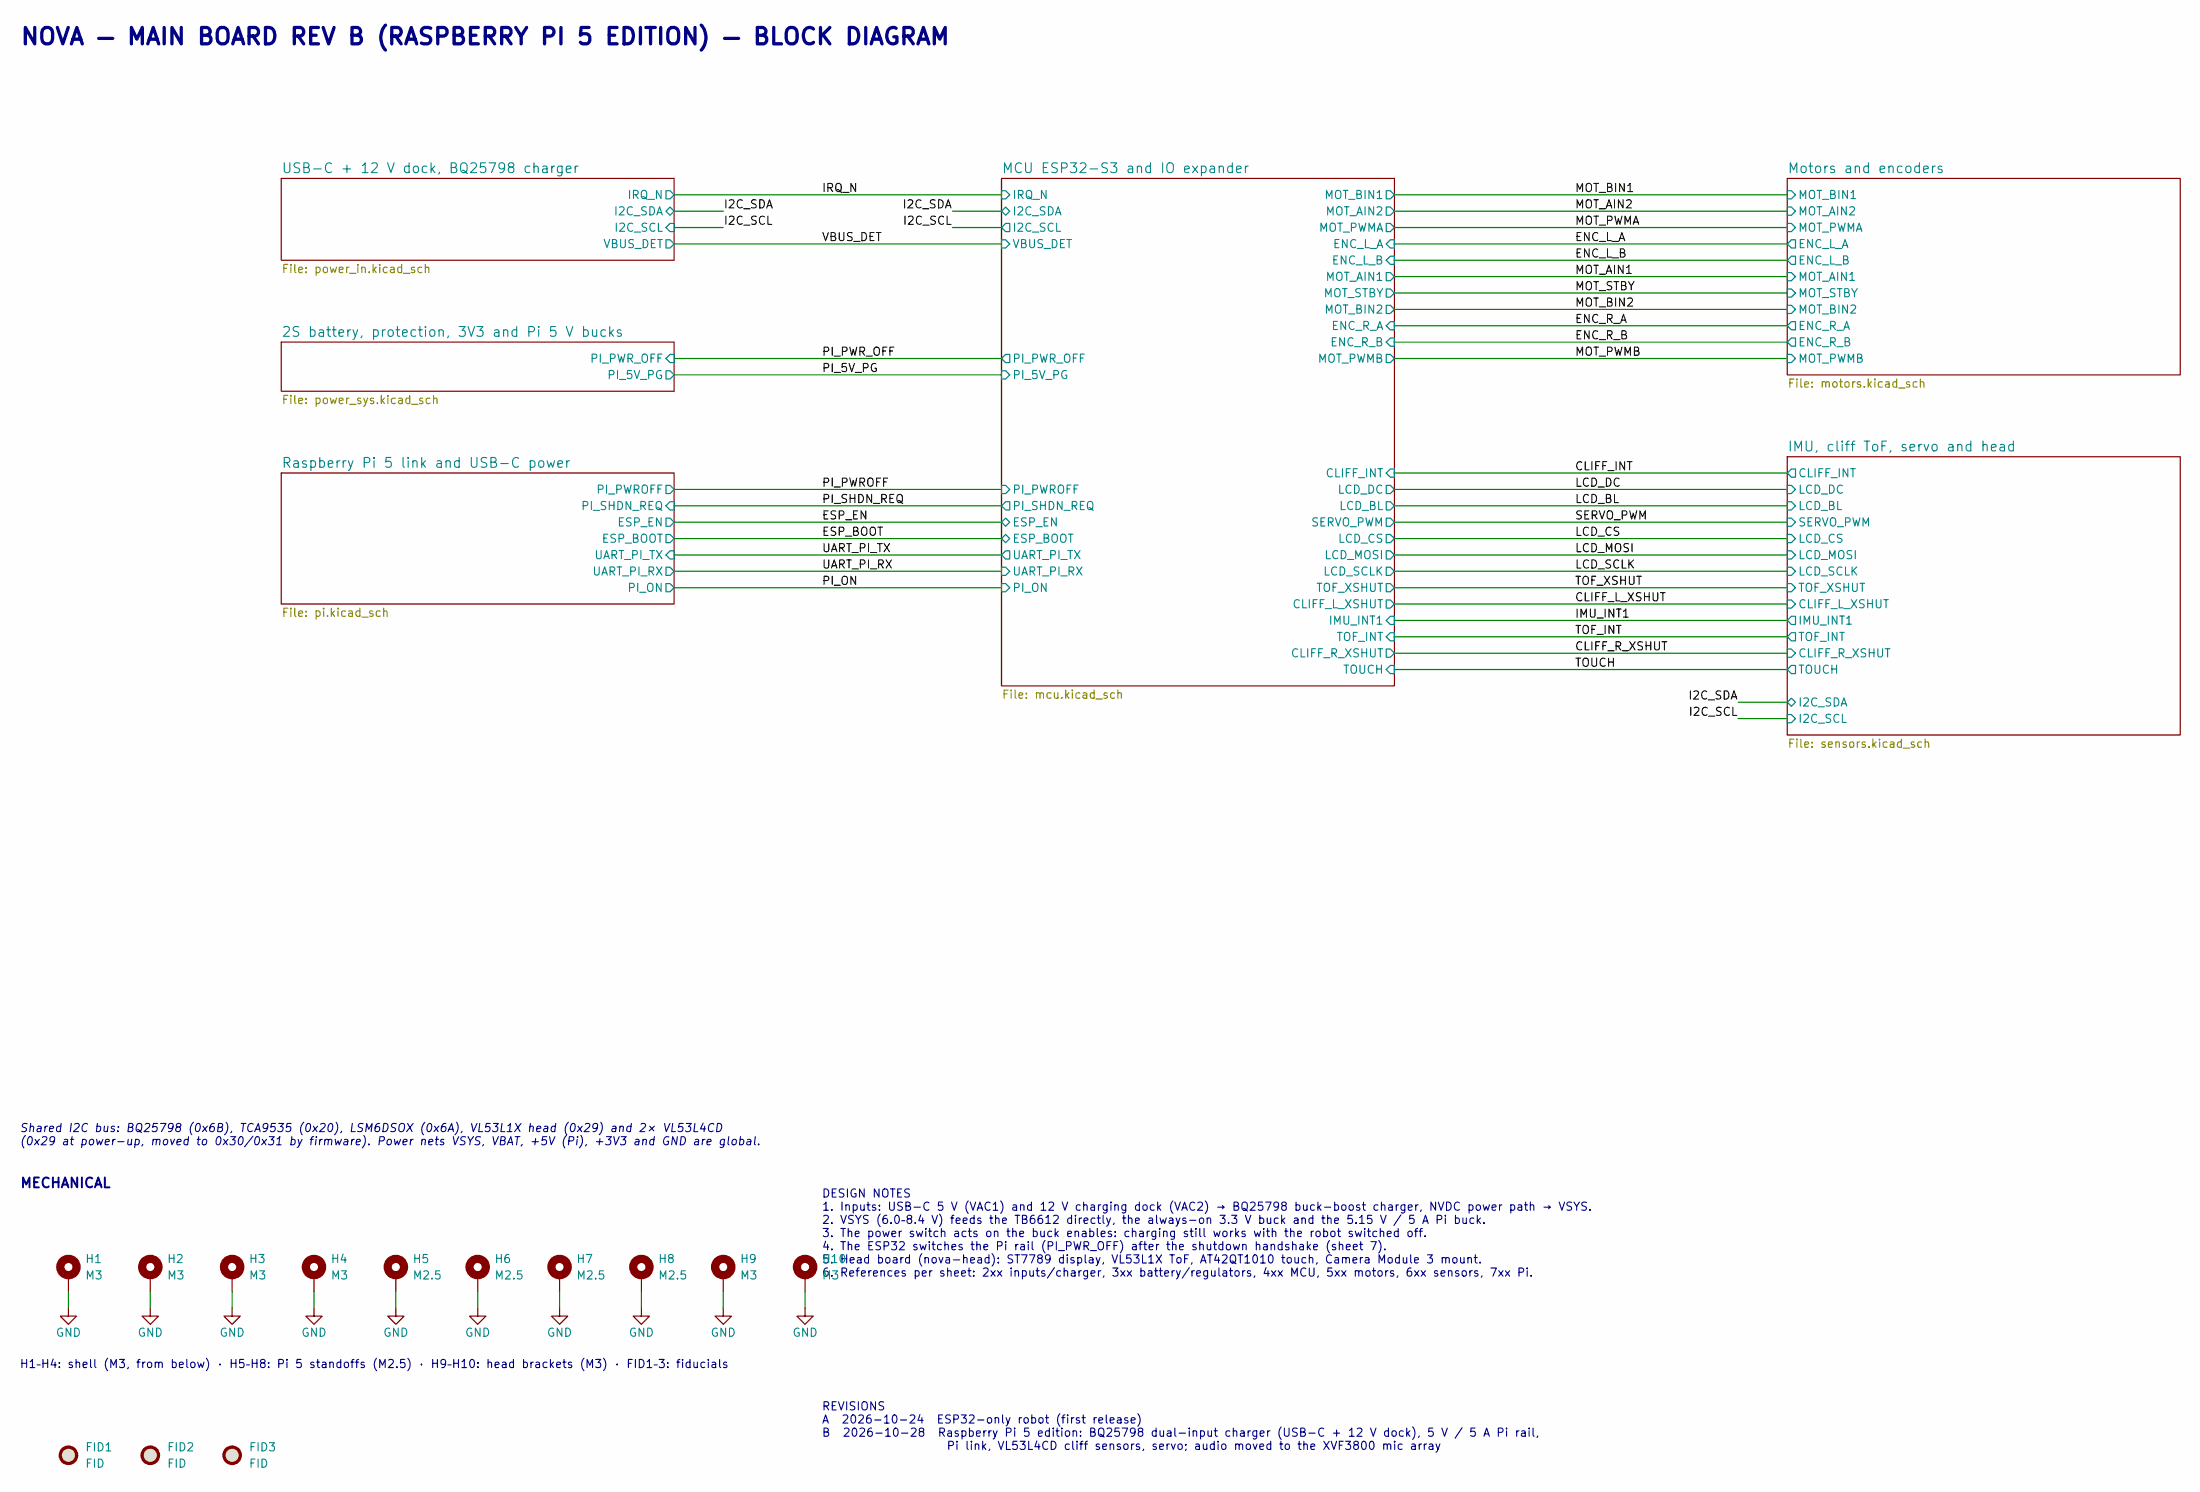
[picture p97: schematic nova-main.kicad_sch, NOVA — Main board (chassis)]

Parts:
FID1, FID2, FID3: FID; Fiducial_1mm_Mask2mm
H1, H2, H3, H4, H9, H10: M3; MountingHole_3.2mm_M3_Pad_Via
H5, H6, H7, H8: M2.5; MountingHole_2.7mm_M2.5_Pad_Via

Notes on the sheet:
NOVA — MAIN BOARD REV B (RASPBERRY PI 5 EDITION) — BLOCK DIAGRAM
Shared I2C bus: BQ25798 (0x6B), TCA9535 (0x20), LSM6DSOX (0x6A), VL53L1X head (0x29) and 2× VL53L4CD (0x29 at power-up, moved to 0x30/0x31 by firmware). Power nets VSYS, VBAT, +5V (Pi), +3V3 and GND are global.
MECHANICAL
H1–H4: shell (M3, from below) · H5–H8: Pi 5 standoffs (M2.5) · H9–H10: head brackets (M3) · FID1–3: fiducials
DESIGN NOTES 1. Inputs: USB-C 5 V (VAC1) and 12 V charging dock (VAC2) → BQ25798 buck-boost charger, NVDC power path → VSYS. 2. VSYS (6.0–8.4 V) feeds the TB6612 directly, the always-on 3.3 V buck and the 5.15 V / 5 A Pi buck. 3. The power switch acts on the buck enables: charging still works with 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
REVISIONS A 2026-10-24 ESP32-only robot (first release) B 2026-10-28 Raspberry Pi 5 edition: BQ25798 dual-input charger (USB-C + 12 V dock), 5 V / 5 A Pi rail, Pi link, VL53L4CD cliff sensors, servo; audio moved to the XVF3800 mic array

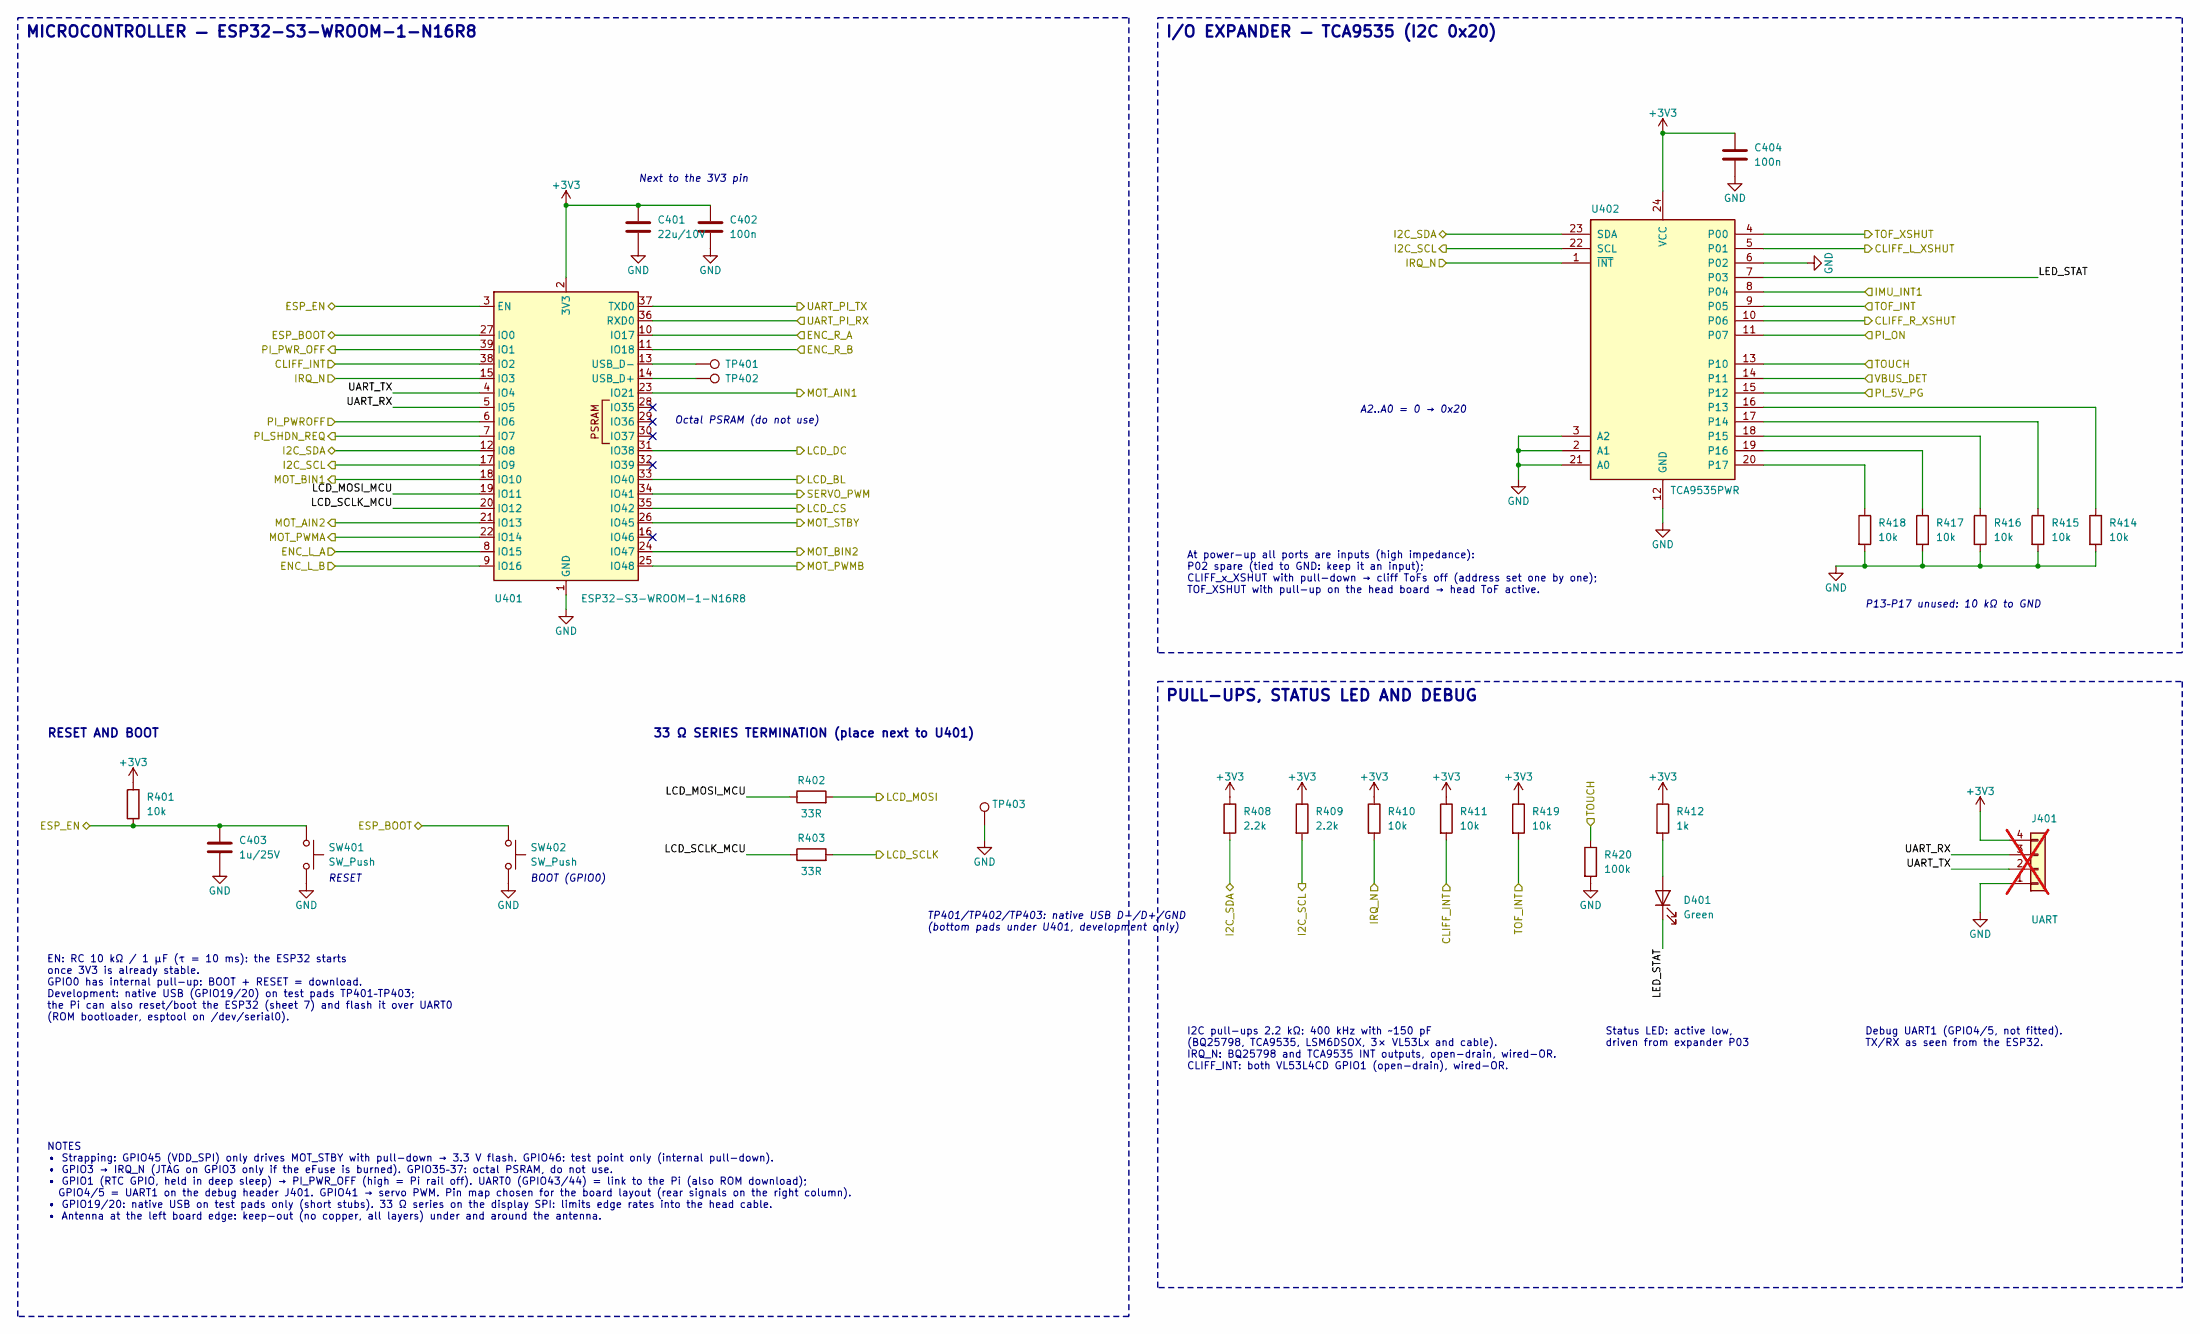
[picture p98: schematic mcu.kicad_sch, ESP32-S3 microcontroller and IO expander]

Parts:
C401: 22u/10V; C_0805_2012Metric; Voltage 10V; MPN LMK212BJ226MG-T; LCSC C92814
C402, C404: 100n; C_0402_1005Metric; Voltage 50V; MPN CL05B104KB54PNC; LCSC C307331
C403: 1u/25V; C_0402_1005Metric; Voltage 25V; MPN CL05A105KA5NQNC; LCSC C52923
D401: Green; LED_0603_1608Metric; MPN LTST-C191KGKT; LCSC C125098
J401: UART; PinHeader_1x04_P2.54mm_Vertical; MPN 22-28-4040; LCSC C587039; not fitted
R401, R410, R411, R414, R415, R416, R417, R418, R419: 10k; R_0402_1005Metric; Tolerance 1%; MPN RC0402FR-0710KL; LCSC C60490
R402, R403: 33R; R_0402_1005Metric; Tolerance 1%; MPN RC0402FR-0733RL; LCSC C138002
R408, R409: 2.2k; R_0402_1005Metric; Tolerance 1%; MPN RC0402FR-072K2L; LCSC C114762
R412: 1k; R_0402_1005Metric; Tolerance 1%; MPN RC0402FR-071KL; LCSC C106235
R420: 100k; R_0402_1005Metric; Tolerance 1%; MPN RC0402FR-07100KL; LCSC C60491
SW401, SW402: SW_Push; SW_SPST_PTS810; MPN PTS810SJK250SMTRLFS; LCSC C221896
TP401, TP402, TP403: TP; TestPoint_Pad_D1.5mm
U401: ESP32-S3-WROOM-1-N16R8; ESP32-S3-WROOM-1; MPN ESP32-S3-WROOM-1-N16R8; LCSC C2913202
U402: TCA9535PWR; TSSOP-24_4.4x7.8mm_P0.65mm; MPN TCA9535PWR; LCSC C130204

Connections:
/CLIFF_INT: R411.2, U401.38 (IO2); also elsewhere on the board
/CLIFF_L_XSHUT: U402.5 (P01); also elsewhere on the board
/CLIFF_R_XSHUT: U402.10 (P06); also elsewhere on the board
/ENC_L_A: U401.8 (IO15); also elsewhere on the board
/ENC_L_B: U401.9 (IO16); also elsewhere on the board
/ENC_R_A: U401.10 (IO17); also elsewhere on the board
/ENC_R_B: U401.11 (IO18); also elsewhere on the board
/ESP_BOOT: SW402.1, U401.27 (IO0); also elsewhere on the board
/ESP_EN: C403.1, R401.2, SW401.1, U401.3 (EN); also elsewhere on the board
/I2C_SCL: R409.2, U401.17 (IO9), U402.22 (SCL); also elsewhere on the board
/I2C_SDA: R408.2, U401.12 (IO8), U402.23 (SDA); also elsewhere on the board
/IMU_INT1: U402.8 (P04); also elsewhere on the board
/IRQ_N: R410.2, U401.15 (IO3), U402.1 (~INT); also elsewhere on the board
/LCD_BL: U401.33 (IO40); also elsewhere on the board
/LCD_CS: U401.35 (IO42); also elsewhere on the board
/LCD_DC: U401.31 (IO38); also elsewhere on the board
/LCD_MOSI: R402.2; also elsewhere on the board
/LCD_SCLK: R403.2; also elsewhere on the board
/MCU ESP32-S3 and IO expander/LCD_MOSI_MCU: R402.1, U401.19 (IO11)
/MCU ESP32-S3 and IO expander/LCD_SCLK_MCU: R403.1, U401.20 (IO12)
/MCU ESP32-S3 and IO expander/LED_STAT: D401.1 (K), U402.7 (P03)
/MCU ESP32-S3 and IO expander/UART_RX: J401.3, U401.5 (IO5)
/MCU ESP32-S3 and IO expander/UART_TX: J401.2, U401.4 (IO4)
/MOT_AIN1: U401.23 (IO21); also elsewhere on the board
/MOT_AIN2: U401.21 (IO13); also elsewhere on the board
/MOT_BIN1: U401.18 (IO10); also elsewhere on the board
/MOT_BIN2: U401.24 (IO47); also elsewhere on the board
/MOT_PWMA: U401.22 (IO14); also elsewhere on the board
/MOT_PWMB: U401.25 (IO48); also elsewhere on the board
/MOT_STBY: U401.26 (IO45); also elsewhere on the board
/PI_5V_PG: U402.15 (P12); also elsewhere on the board
/PI_ON: U402.11 (P07); also elsewhere on the board
/PI_PWROFF: U401.6 (IO6); also elsewhere on the board
/PI_PWR_OFF: U401.39 (IO1); also elsewhere on the board
/PI_SHDN_REQ: U401.7 (IO7); also elsewhere on the board
/SERVO_PWM: U401.34 (IO41); also elsewhere on the board
/TOF_INT: R419.2, U402.9 (P05); also elsewhere on the board
/TOF_XSHUT: U402.4 (P00); also elsewhere on the board
/TOUCH: R420.1, U402.13 (P10); also elsewhere on the board
/UART_PI_RX: U401.36 (RXD0); also elsewhere on the board
/UART_PI_TX: U401.37 (TXD0); also elsewhere on the board
/VBUS_DET: U402.14 (P11); also elsewhere on the board
unnamed: D401.2 (A), R412.2
unnamed: TP402.1 (1_1), U401.14 (USB_D+)
unnamed: TP401.1 (1_1), U401.13 (USB_D-)
unnamed: R414.1, U402.16 (P13)
unnamed: R415.1, U402.17 (P14)
unnamed: R416.1, U402.18 (P15)
unnamed: R417.1, U402.19 (P16)
unnamed: R418.1, U402.20 (P17)

Notes on the sheet:
MICROCONTROLLER — ESP32-S3-WROOM-1-N16R8
I/O EXPANDER — TCA9535 (I2C 0x20)
PULL-UPS, STATUS LED AND DEBUG
Octal PSRAM (do not use)
TP401/TP402/TP403: native USB D−/D+/GND (bottom pads under U401, development only)
Next to the 3V3 pin
RESET AND BOOT
RESET
BOOT (GPIO0)
EN: RC 10 kΩ / 1 µF (τ = 10 ms): the ESP32 starts once 3V3 is already stable. GPIO0 has internal pull-up: BOOT + RESET = download. Development: native USB (GPIO19/20) on test pads TP401–TP403; the Pi can also reset/boot the ESP32 (sheet 7) and flash it over UART0 (ROM bootloader, esptool on /dev/se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
33 Ω SERIES TERMINATION (place next to U401)
NOTES • Strapping: GPIO45 (VDD_SPI) only drives MOT_STBY with pull-down → 3.3 V flash. GPIO46: test point only (internal pull-down). • GPIO3 → IRQ_N (JTAG on GPIO3 only if the eFuse is burned). GPIO35–37: octal PSRAM, do not use. • GPIO1 (RTC GPIO, held in deep sleep) → PI_PWR_OFF (high = Pi rail o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
A2..A0 = 0 → 0x20
P13–P17 unused: 10 kΩ to GND
At power-up all ports are inputs (high impedance): P02 spare (tied to GND: keep it an input); CLIFF_x_XSHUT with pull-down → cliff ToFs off (address set one by one); TOF_XSHUT with pull-up on the head board → head ToF active.
I2C pull-ups 2.2 kΩ: 400 kHz with ~150 pF (BQ25798, TCA9535, LSM6DSOX, 3× VL53Lx and cable). IRQ_N: BQ25798 and TCA9535 INT outputs, open-drain, wired-OR. CLIFF_INT: both VL53L4CD GPIO1 (open-drain), wired-OR.
Status LED: active low, driven from expander P03
Debug UART1 (GPIO4/5, not fitted). TX/RX as seen from the ESP32.

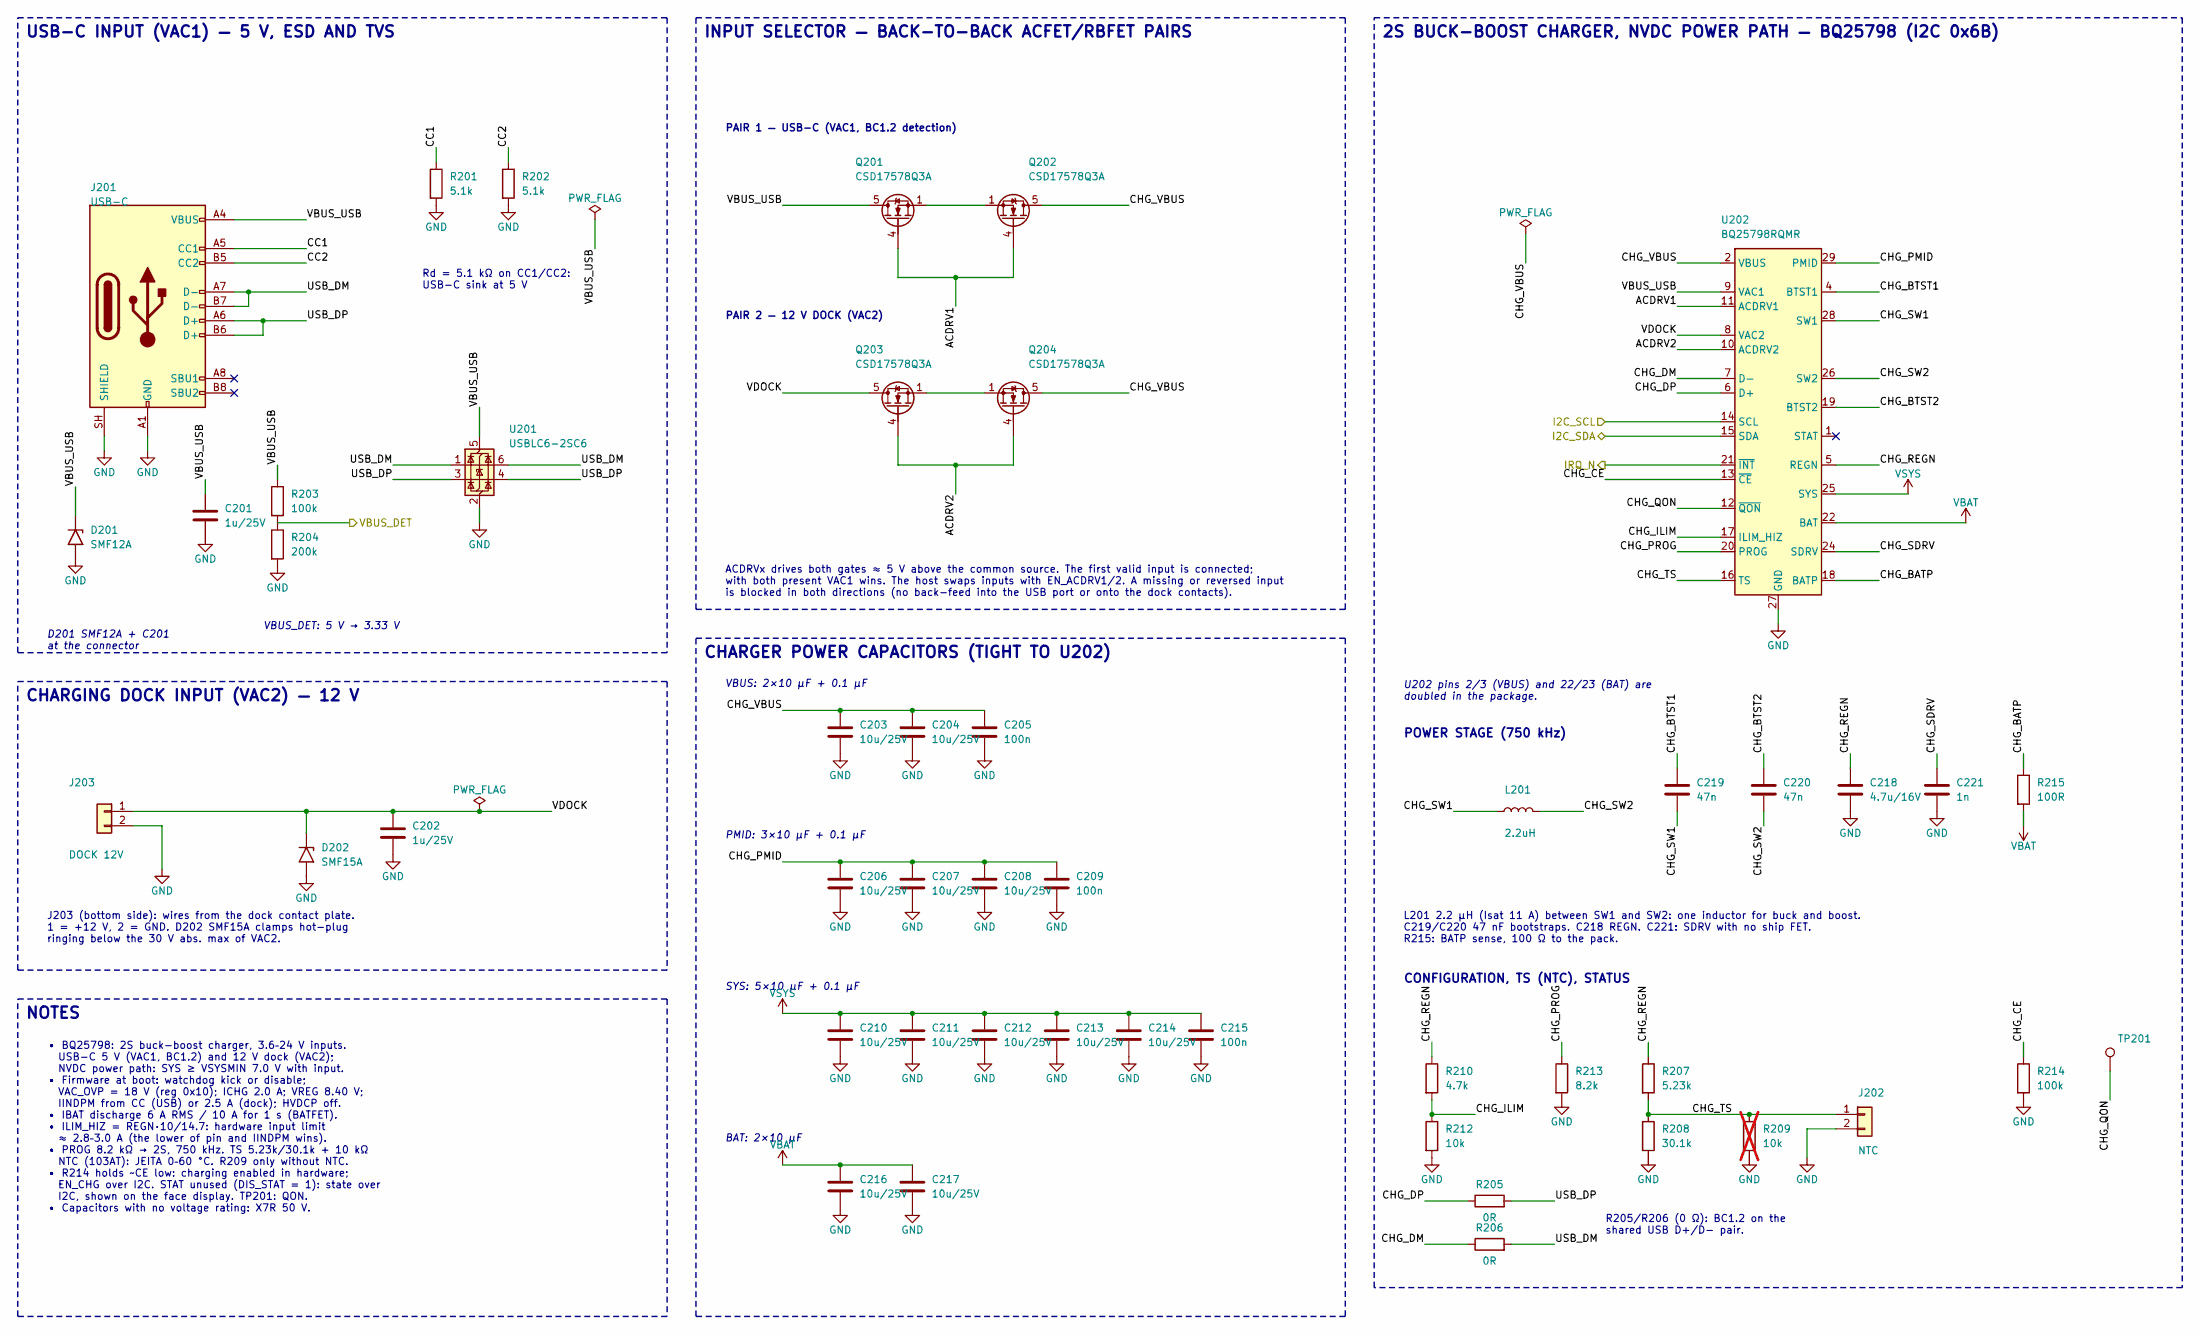
[picture p99: schematic power_in.kicad_sch, Power inputs and 2S buck-boost charger]

Parts:
C201, C202: 1u/25V; C_0603_1608Metric; Voltage 25V; MPN CC0603KRX5R8BB105; LCSC C14664
C203, C204, C206, C207, C208, C210, C211, C212, C213, C214, C216, C217: 10u/25V; C_0805_2012Metric; Voltage 25V; MPN CL21A106KAYNNNE; LCSC C15850
C205, C209, C215: 100n; C_0402_1005Metric; Voltage 50V; MPN CL05B104KB54PNC; LCSC C307331
C218: 4.7u/16V; C_0603_1608Metric; Voltage 16V; MPN CL10A475KO8NNNC; LCSC C19666
C219, C220: 47n; C_0402_1005Metric; Voltage 25V; MPN CL05B473KA5NNNC; LCSC C318631
C221: 1n; C_0402_1005Metric; Voltage 50V; MPN CL05B102KB5NNNC; LCSC C14442
D201: SMF12A; D_SMF; MPN SMF12A; LCSC C123800
D202: SMF15A; D_SMF; MPN SMF15A; LCSC C123802
J201: USB-C; USB_C_Receptacle_HRO_TYPE-C-31-M-12_GCT_USB4105; MPN TYPE-C-31-M-12; LCSC C165948
J202: NTC; JST_PH_B2B-PH-K_1x02_P2.00mm_Vertical; MPN B2B-PH-K-S(LF)(SN); LCSC C131337
J203: DOCK 12V; JST_XH_B2B-XH-A_1x02_P2.50mm_Vertical; MPN B2B-XH-A(LF)(SN); LCSC C158012
L201: 2.2uH; L_Sunlord_MWSA0605S; MPN MWSA0605S-2R2MT; LCSC C408463
Q201, Q202, Q203, Q204: CSD17578Q3A; VSON-8_3.3x3.3mm_P0.65mm_NexFET; MPN CSD17578Q3A; LCSC C205986
R201, R202: 5.1k; R_0402_1005Metric; Tolerance 1%; MPN RC0402FR-075K1L; LCSC C105872
R203, R214: 100k; R_0402_1005Metric; Tolerance 1%; MPN RC0402FR-07100KL; LCSC C60491
R204: 200k; R_0402_1005Metric; Tolerance 1%; MPN RC0402FR-07200KL; LCSC C114763
R205, R206: 0R; R_0402_1005Metric; Tolerance 1%; MPN RC0402JR-070RL; LCSC C60485
R207: 5.23k; R_0402_1005Metric; Tolerance 1%; MPN CRCW04025K23FKED; LCSC C2076550
R208: 30.1k; R_0402_1005Metric; Tolerance 1%; MPN ERJ-2RKF3012X; LCSC C2076806
R209: 10k; R_0402_1005Metric; Tolerance 1%; MPN RC0402FR-0710KL; LCSC C60490; not fitted
R210: 4.7k; R_0402_1005Metric; Tolerance 1%; MPN RC0402FR-074K7L; LCSC C105871
R212: 10k; R_0402_1005Metric; Tolerance 1%; MPN RC0402FR-0710KL; LCSC C60490
R213: 8.2k; R_0402_1005Metric; Tolerance 1%; MPN 0402WGF8201TCE; LCSC C25924
R215: 100R; R_0402_1005Metric; Tolerance 1%; MPN RC0402FR-07100RL; LCSC C106232
TP201: TP; TestPoint_Pad_D1.5mm
U201: USBLC6-2SC6; SOT-23-6; MPN USBLC6-2SC6; LCSC C7519
U202: BQ25798RQMR; Texas_RQM0029A_VQFN-29_4x4mm_P0.4mm; MPN BQ25798RQMR; LCSC C2876593

Connections:
/I2C_SCL: U202.14 (SCL); also elsewhere on the board
/I2C_SDA: U202.15 (SDA); also elsewhere on the board
/IRQ_N: U202.21 (~INT); also elsewhere on the board
/USB-C + 12 V dock, BQ25798 charger/ACDRV1: Q201.4 (G), Q202.4 (G), U202.11 (ACDRV1)
/USB-C + 12 V dock, BQ25798 charger/ACDRV2: Q203.4 (G), Q204.4 (G), U202.10 (ACDRV2)
/USB-C + 12 V dock, BQ25798 charger/CC1: J201.A5 (CC1), R201.1
/USB-C + 12 V dock, BQ25798 charger/CC2: J201.B5 (CC2), R202.1
/USB-C + 12 V dock, BQ25798 charger/CHG_BATP: R215.1, U202.18 (BATP)
/USB-C + 12 V dock, BQ25798 charger/CHG_BTST1: C219.1, U202.4 (BTST1)
/USB-C + 12 V dock, BQ25798 charger/CHG_BTST2: C220.1, U202.19 (BTST2)
/USB-C + 12 V dock, BQ25798 charger/CHG_CE: R214.1, U202.13 (~CE)
/USB-C + 12 V dock, BQ25798 charger/CHG_DM: R206.1, U202.7 (D-)
/USB-C + 12 V dock, BQ25798 charger/CHG_DP: R205.1, U202.6 (D+)
/USB-C + 12 V dock, BQ25798 charger/CHG_ILIM: R210.2, R212.1, U202.17 (ILIM_HIZ)
/USB-C + 12 V dock, BQ25798 charger/CHG_PMID: C206.1, C207.1, C208.1, C209.1, U202.29 (PMID)
/USB-C + 12 V dock, BQ25798 charger/CHG_PROG: R213.1, U202.20 (PROG)
/USB-C + 12 V dock, BQ25798 charger/CHG_QON: TP201.1 (1_1), U202.12 (~QON)
/USB-C + 12 V dock, BQ25798 charger/CHG_REGN: C218.1, R207.1, R210.1, U202.5 (REGN)
/USB-C + 12 V dock, BQ25798 charger/CHG_SDRV: C221.1, U202.24 (SDRV)
/USB-C + 12 V dock, BQ25798 charger/CHG_SW1: C219.2, L201.1, U202.28 (SW1)
/USB-C + 12 V dock, BQ25798 charger/CHG_SW2: C220.2, L201.2, U202.26 (SW2)
/USB-C + 12 V dock, BQ25798 charger/CHG_TS: J202.1, R207.2, R208.1, R209.1, U202.16 (TS)
/USB-C + 12 V dock, BQ25798 charger/USB_DM: J201.A7 (D-), J201.B7 (D-), R206.2, U201.1 (I/O1), U201.6 (I/O1)
/USB-C + 12 V dock, BQ25798 charger/USB_DP: J201.A6 (D+), J201.B6 (D+), R205.2, U201.3 (I/O2), U201.4 (I/O2)
/VBUS_DET: R203.2, R204.1; also elsewhere on the board
unnamed: Q201.1 (S), Q201.2 (S), Q201.3 (S), Q202.1 (S), Q202.2 (S), Q202.3 (S)
unnamed: Q203.1 (S), Q203.2 (S), Q203.3 (S), Q204.1 (S), Q204.2 (S), Q204.3 (S)
VBAT: C216.1, C217.1, R215.2, U202.22 (BAT), U202.23 (BAT); also elsewhere on the board
VSYS: C210.1, C211.1, C212.1, C213.1, C214.1, C215.1, U202.25 (SYS); also elsewhere on the board

Notes on the sheet:
USB-C INPUT (VAC1) — 5 V, ESD AND TVS
CHARGING DOCK INPUT (VAC2) — 12 V
NOTES
INPUT SELECTOR — BACK-TO-BACK ACFET/RBFET PAIRS
CHARGER POWER CAPACITORS (TIGHT TO U202)
2S BUCK-BOOST CHARGER, NVDC POWER PATH — BQ25798 (I2C 0x6B)
Rd = 5.1 kΩ on CC1/CC2: USB-C sink at 5 V
VBUS_DET: 5 V → 3.33 V
D201 SMF12A + C201 at the connector
J203 (bottom side): wires from the dock contact plate. 1 = +12 V, 2 = GND. D202 SMF15A clamps hot-plug ringing below the 30 V abs. max of VAC2.
PAIR 1 — USB-C (VAC1, BC1.2 detection)
PAIR 2 — 12 V DOCK (VAC2)
ACDRVx drives both gates ≈ 5 V above the common source. The first valid input is connected; with both present VAC1 wins. The host swaps inputs with EN_ACDRV1/2. A missing or reversed input is blocked in both directions (no back-feed into the USB port or onto the dock contacts).
VBUS: 2×10 µF + 0.1 µF
PMID: 3×10 µF + 0.1 µF
SYS: 5×10 µF + 0.1 µF
BAT: 2×10 µF
U202 pins 2/3 (VBUS) and 22/23 (BAT) are doubled in the package.
POWER STAGE (750 kHz)
L201 2.2 µH (Isat 11 A) between SW1 and SW2: one inductor for buck and boost. C219/C220 47 nF bootstraps. C218 REGN. C221: SDRV with no ship FET. R215: BATP sense, 100 Ω to the pack.
CONFIGURATION, TS (NTC), STATUS
R205/R206 (0 Ω): BC1.2 on the shared USB D+/D− pair.
• BQ25798: 2S buck-boost charger, 3.6–24 V inputs. USB-C 5 V (VAC1, BC1.2) and 12 V dock (VAC2); NVDC power path: SYS ≥ VSYSMIN 7.0 V with input. • Firmware at boot: watchdog kick or disable; VAC_OVP = 18 V (reg 0x10); ICHG 2.0 A; VREG 8.40 V; IINDPM from CC (USB) or 2.5 A (dock); HVDCP off. • IBAT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
