ronmart17/nova-robot/hardware/nova-main/nova-main.kicad_pcb

## KiCad design hardware/nova-main/nova-main.kicad_pcb (continued)

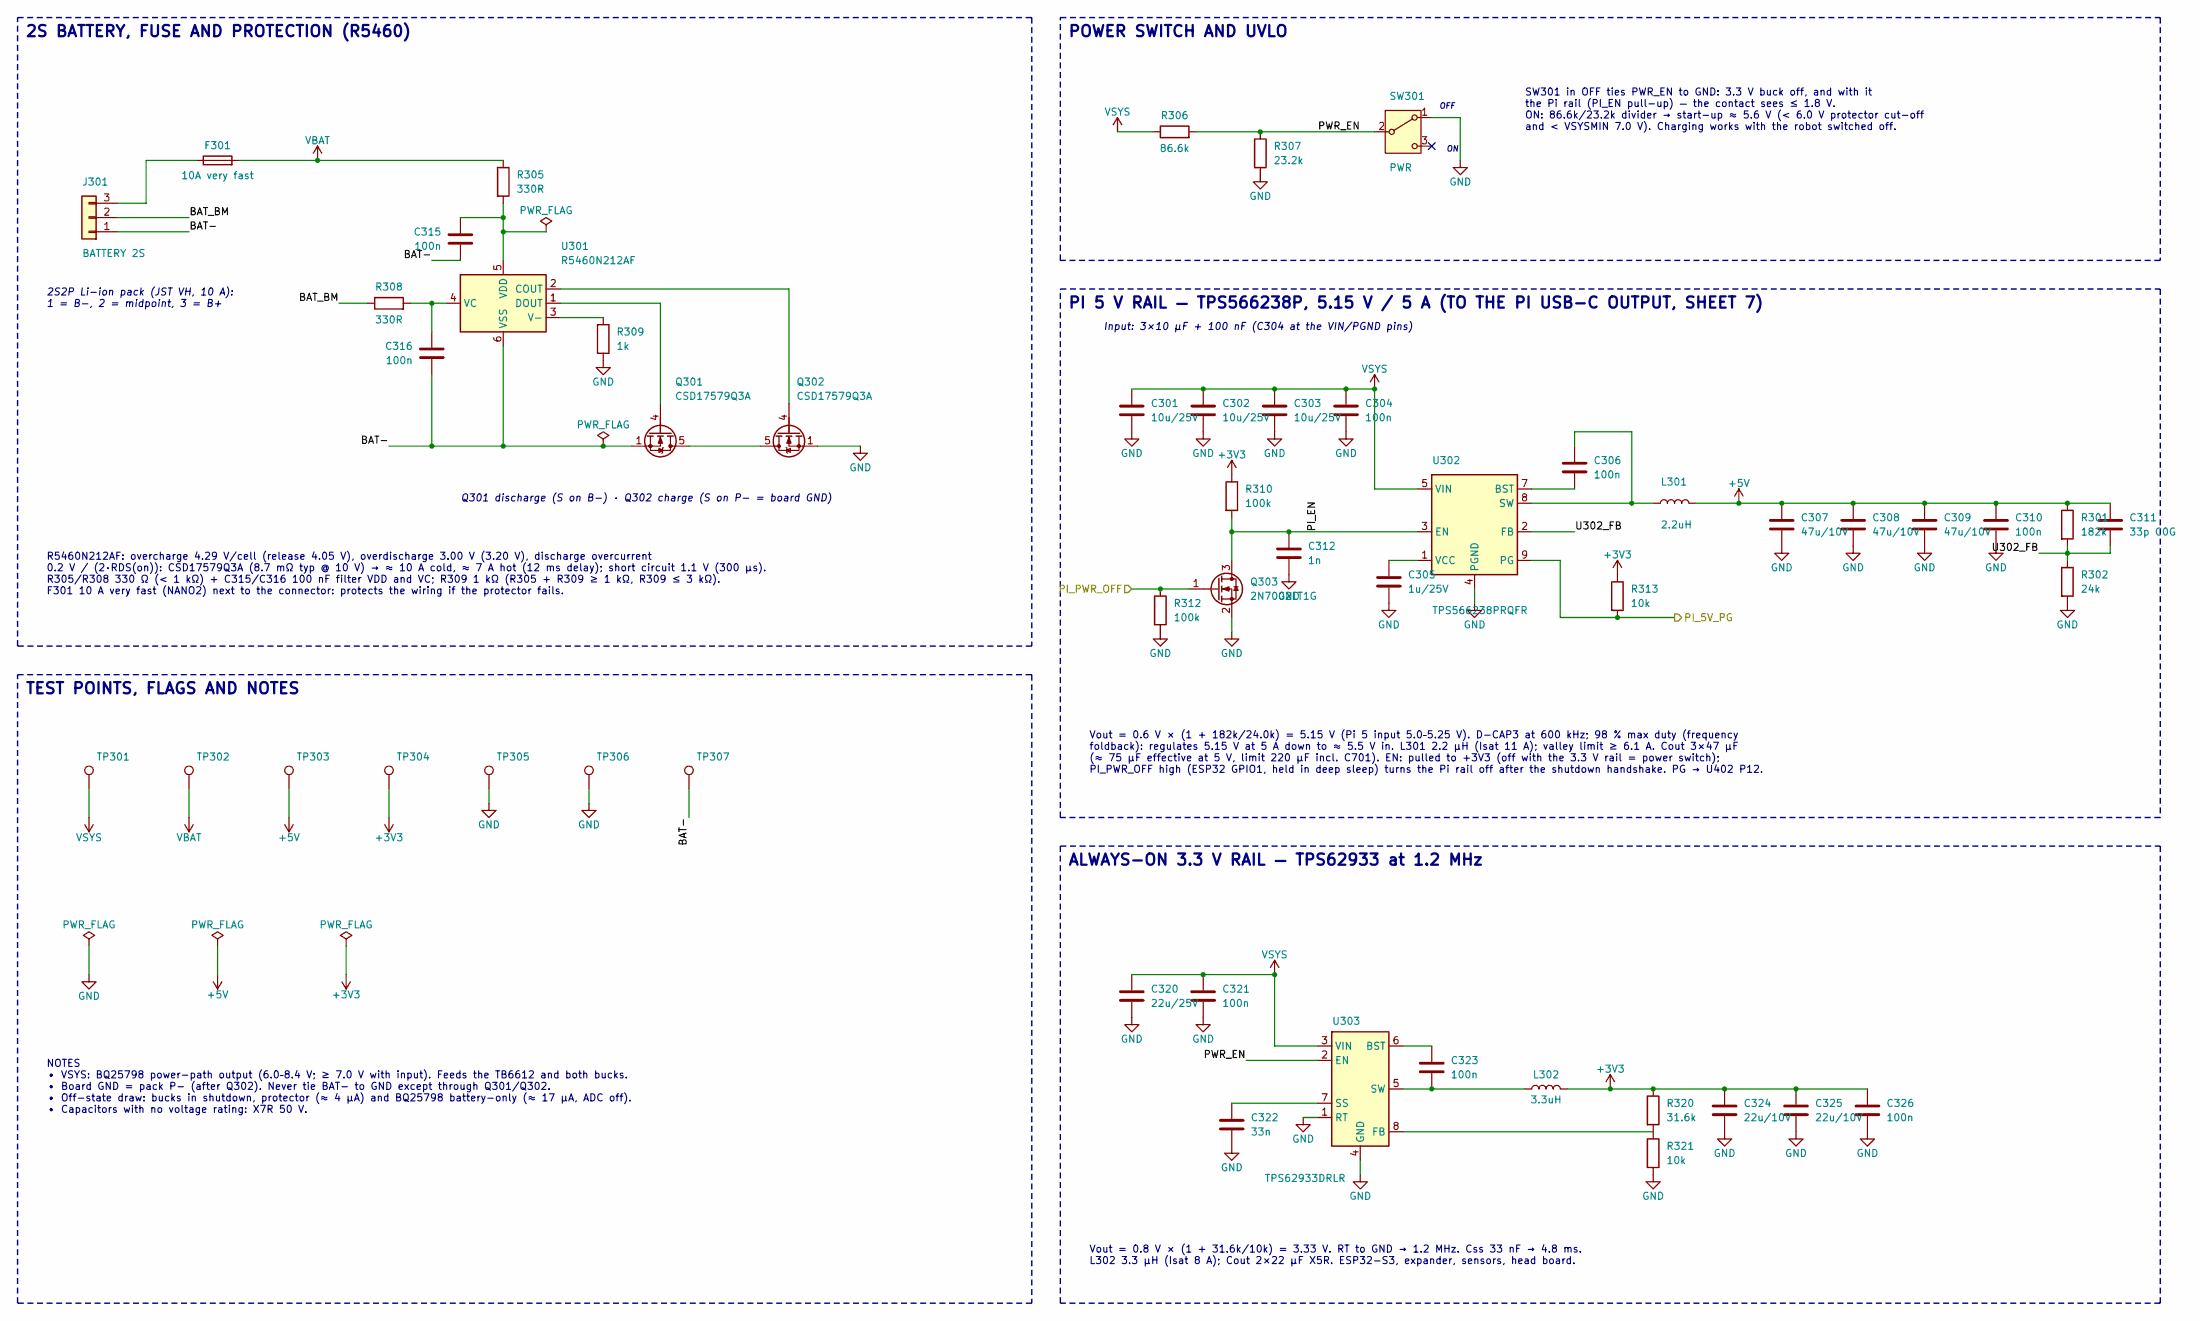
[picture p100: schematic power_sys.kicad_sch, Battery, protection and regulators]

Parts:
C301, C302, C303: 10u/25V; C_0805_2012Metric; Voltage 25V; MPN CL21A106KAYNNNE; LCSC C15850
C304, C306, C310, C315, C316, C321, C323, C326: 100n; C_0402_1005Metric; Voltage 50V; MPN CL05B104KB54PNC; LCSC C307331
C305: 1u/25V; C_0402_1005Metric; Voltage 25V; MPN CL05A105KA5NQNC; LCSC C52923
C307, C308, C309: 47u/10V; C_1206_3216Metric; Voltage 10V; MPN CL31A476MPHNNNE; LCSC C96123
C311: 33p C0G; C_0402_1005Metric; Voltage 50V; MPN CL05C330JB5NNNC; LCSC C70465
C312: 1n; C_0402_1005Metric; Voltage 50V; MPN CL05B102KB5NNNC; LCSC C14442
C320: 22u/25V; C_1206_3216Metric; Voltage 25V; MPN CL31A226KAHNNNE; LCSC C12891
C322: 33n; C_0402_1005Metric; Voltage 50V; MPN CL05B333KB5VPNC; LCSC C472437
C324, C325: 22u/10V; C_0805_2012Metric; Voltage 10V; MPN LMK212BJ226MG-T; LCSC C92814
F301: 10A very fast; Fuse_Littelfuse-NANO2-451_453; MPN 0451010.MRL; LCSC C44479
J301: BATTERY 2S; JST_VH_B3P-VH_1x03_P3.96mm_Vertical; MPN B3P-VH(LF)(SN); LCSC C160316
L301: 2.2uH; L_Sunlord_MWSA0605S; MPN MWSA0605S-2R2MT; LCSC C408463
L302: 3.3uH; L_Bourns_SRP5030T; MPN SRP5030T-3R3M; LCSC C189931
Q301, Q302: CSD17579Q3A; VSON-8_3.3x3.3mm_P0.65mm_NexFET; MPN CSD17579Q3A; LCSC C97376
Q303: 2N7002LT1G; SOT-23; MPN 2N7002LT1G; LCSC C16338
R301: 182k; R_0402_1005Metric; Tolerance 1%; MPN RC0402FR-07182KL; LCSC C327365
R302: 24k; R_0402_1005Metric; Tolerance 1%; MPN RC0402FR-0724KL; LCSC C138026
R305, R308: 330R; R_0402_1005Metric; Tolerance 1%; MPN RC0402FR-07330RL; LCSC C105875
R306: 86.6k; R_0402_1005Metric; Tolerance 1%; MPN RC0402FR-0786K6L; LCSC C477807
R307: 23.2k; R_0402_1005Metric; Tolerance 1%; MPN CRCW040223K2FKED; LCSC C2076557
R309: 1k; R_0402_1005Metric; Tolerance 1%; MPN RC0402FR-071KL; LCSC C106235
R310, R312: 100k; R_0402_1005Metric; Tolerance 1%; MPN RC0402FR-07100KL; LCSC C60491
R313, R321: 10k; R_0402_1005Metric; Tolerance 1%; MPN RC0402FR-0710KL; LCSC C60490
R320: 31.6k; R_0402_1005Metric; Tolerance 1%; MPN CRCW040231K6FKED; LCSC C482148
SW301: PWR; SW_SPDT_PCM12; MPN PCM12SMTR; LCSC C221841
TP301, TP302, TP303, TP304, TP305, TP306, TP307: TP; TestPoint_Pad_D1.5mm
U301: R5460N212AF; SOT-23-6; MPN R5460N212AF-TR-FE; LCSC C259717
U302: TPS566238PRQFR; Texas_RQF0009A_VQFN-HR-9_1.5x2mm_P0.5mm; MPN TPS566238PRQFR; LCSC C2876603
U303: TPS62933DRLR; SOT-583-8; MPN TPS62933DRLR; LCSC C3200405

Connections:
/2S battery, protection, 3V3 and Pi 5 V bucks/BAT_BM: J301.2, R308.1
/2S battery, protection, 3V3 and Pi 5 V bucks/PI_EN: C312.1, Q303.3 (D), R310.2, U302.3 (EN)
/2S battery, protection, 3V3 and Pi 5 V bucks/PWR_EN: R306.2, R307.1, SW301.2 (B), U303.2 (EN)
/2S battery, protection, 3V3 and Pi 5 V bucks/U302_FB: C311.2, R301.2, R302.1, U302.2 (FB)
/PI_5V_PG: R313.2, U302.9 (PG); also elsewhere on the board
/PI_PWR_OFF: Q303.1 (G), R312.1; also elsewhere on the board
unnamed: F301.1, J301.3
unnamed: Q301.5 (D), Q302.5 (D)
unnamed: Q301.4 (G), U301.1 (DOUT)
unnamed: Q302.4 (G), U301.2 (COUT)
unnamed: R309.1, U301.3 (V-)
unnamed: C316.1, R308.2, U301.4 (VC)
unnamed: C306.2, U302.7 (BST)
unnamed: C306.1, L301.1, U302.8 (SW)
unnamed: C305.1, U302.1 (VCC)
unnamed: C323.1, U303.6 (BST)
unnamed: R320.2, R321.1, U303.8 (FB)
unnamed: C322.1, U303.7 (SS)
unnamed: C323.2, L302.1, U303.5 (SW)
VBAT: F301.2, R305.1, TP302.1 (1_1); also elsewhere on the board
VSYS: C301.1, C302.1, C303.1, C304.1, C320.1, C321.1, R306.1, TP301.1 (1_1), U302.5 (VIN), U302.6 (VIN), U303.3 (VIN); also elsewhere on the board

Notes on the sheet:
2S BATTERY, FUSE AND PROTECTION (R5460)
POWER SWITCH AND UVLO
PI 5 V RAIL — TPS566238P, 5.15 V / 5 A (TO THE PI USB-C OUTPUT, SHEET 7)
ALWAYS-ON 3.3 V RAIL — TPS62933 at 1.2 MHz
TEST POINTS, FLAGS AND NOTES
2S2P Li-ion pack (JST VH, 10 A): 1 = B−, 2 = midpoint, 3 = B+
Q301 discharge (S on B−) · Q302 charge (S on P− = board GND)
R5460N212AF: overcharge 4.29 V/cell (release 4.05 V), overdischarge 3.00 V (3.20 V), discharge overcurrent 0.2 V / (2·RDS(on)): CSD17579Q3A (8.7 mΩ typ @ 10 V) → ≈ 10 A cold, ≈ 7 A hot (12 ms delay); short circuit 1.1 V (300 µs). R305/R308 330 Ω (< 1 kΩ) + C315/C316 100 nF filter VDD and VC; R309 1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
OFF
SW301 in OFF ties PWR_EN to GND: 3.3 V buck off, and with it the Pi rail (PI_EN pull-up) — the contact sees ≤ 1.8 V. ON: 86.6k/23.2k divider → start-up ≈ 5.6 V (< 6.0 V protector cut-off and < VSYSMIN 7.0 V). Charging works with the robot switched off.
Input: 3×10 µF + 100 nF (C304 at the VIN/PGND pins)
Vout = 0.6 V × (1 + 182k/24.0k) = 5.15 V (Pi 5 input 5.0–5.25 V). D-CAP3 at 600 kHz; 98 % max duty (frequency foldback): regulates 5.15 V at 5 A down to ≈ 5.5 V in. L301 2.2 µH (Isat 11 A); valley limit ≥ 6.1 A. Cout 3×47 µF (≈ 75 µF effective at 5 V, limit 220 µF incl. C701). EN: pulled to +3V3 (o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
Vout = 0.8 V × (1 + 31.6k/10k) = 3.33 V. RT to GND → 1.2 MHz. Css 33 nF → 4.8 ms. L302 3.3 µH (Isat 8 A); Cout 2×22 µF X5R. ESP32-S3, expander, sensors, head board.
NOTES • VSYS: BQ25798 power-path output (6.0–8.4 V; ≥ 7.0 V with input). Feeds the TB6612 and both bucks. • Board GND = pack P− (after Q302). Never tie BAT− to GND except through Q301/Q302. • Off-state draw: bucks in shutdown, protector (≈ 4 µA) and BQ25798 battery-only (≈ 17 µA, ADC off). • Capaci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

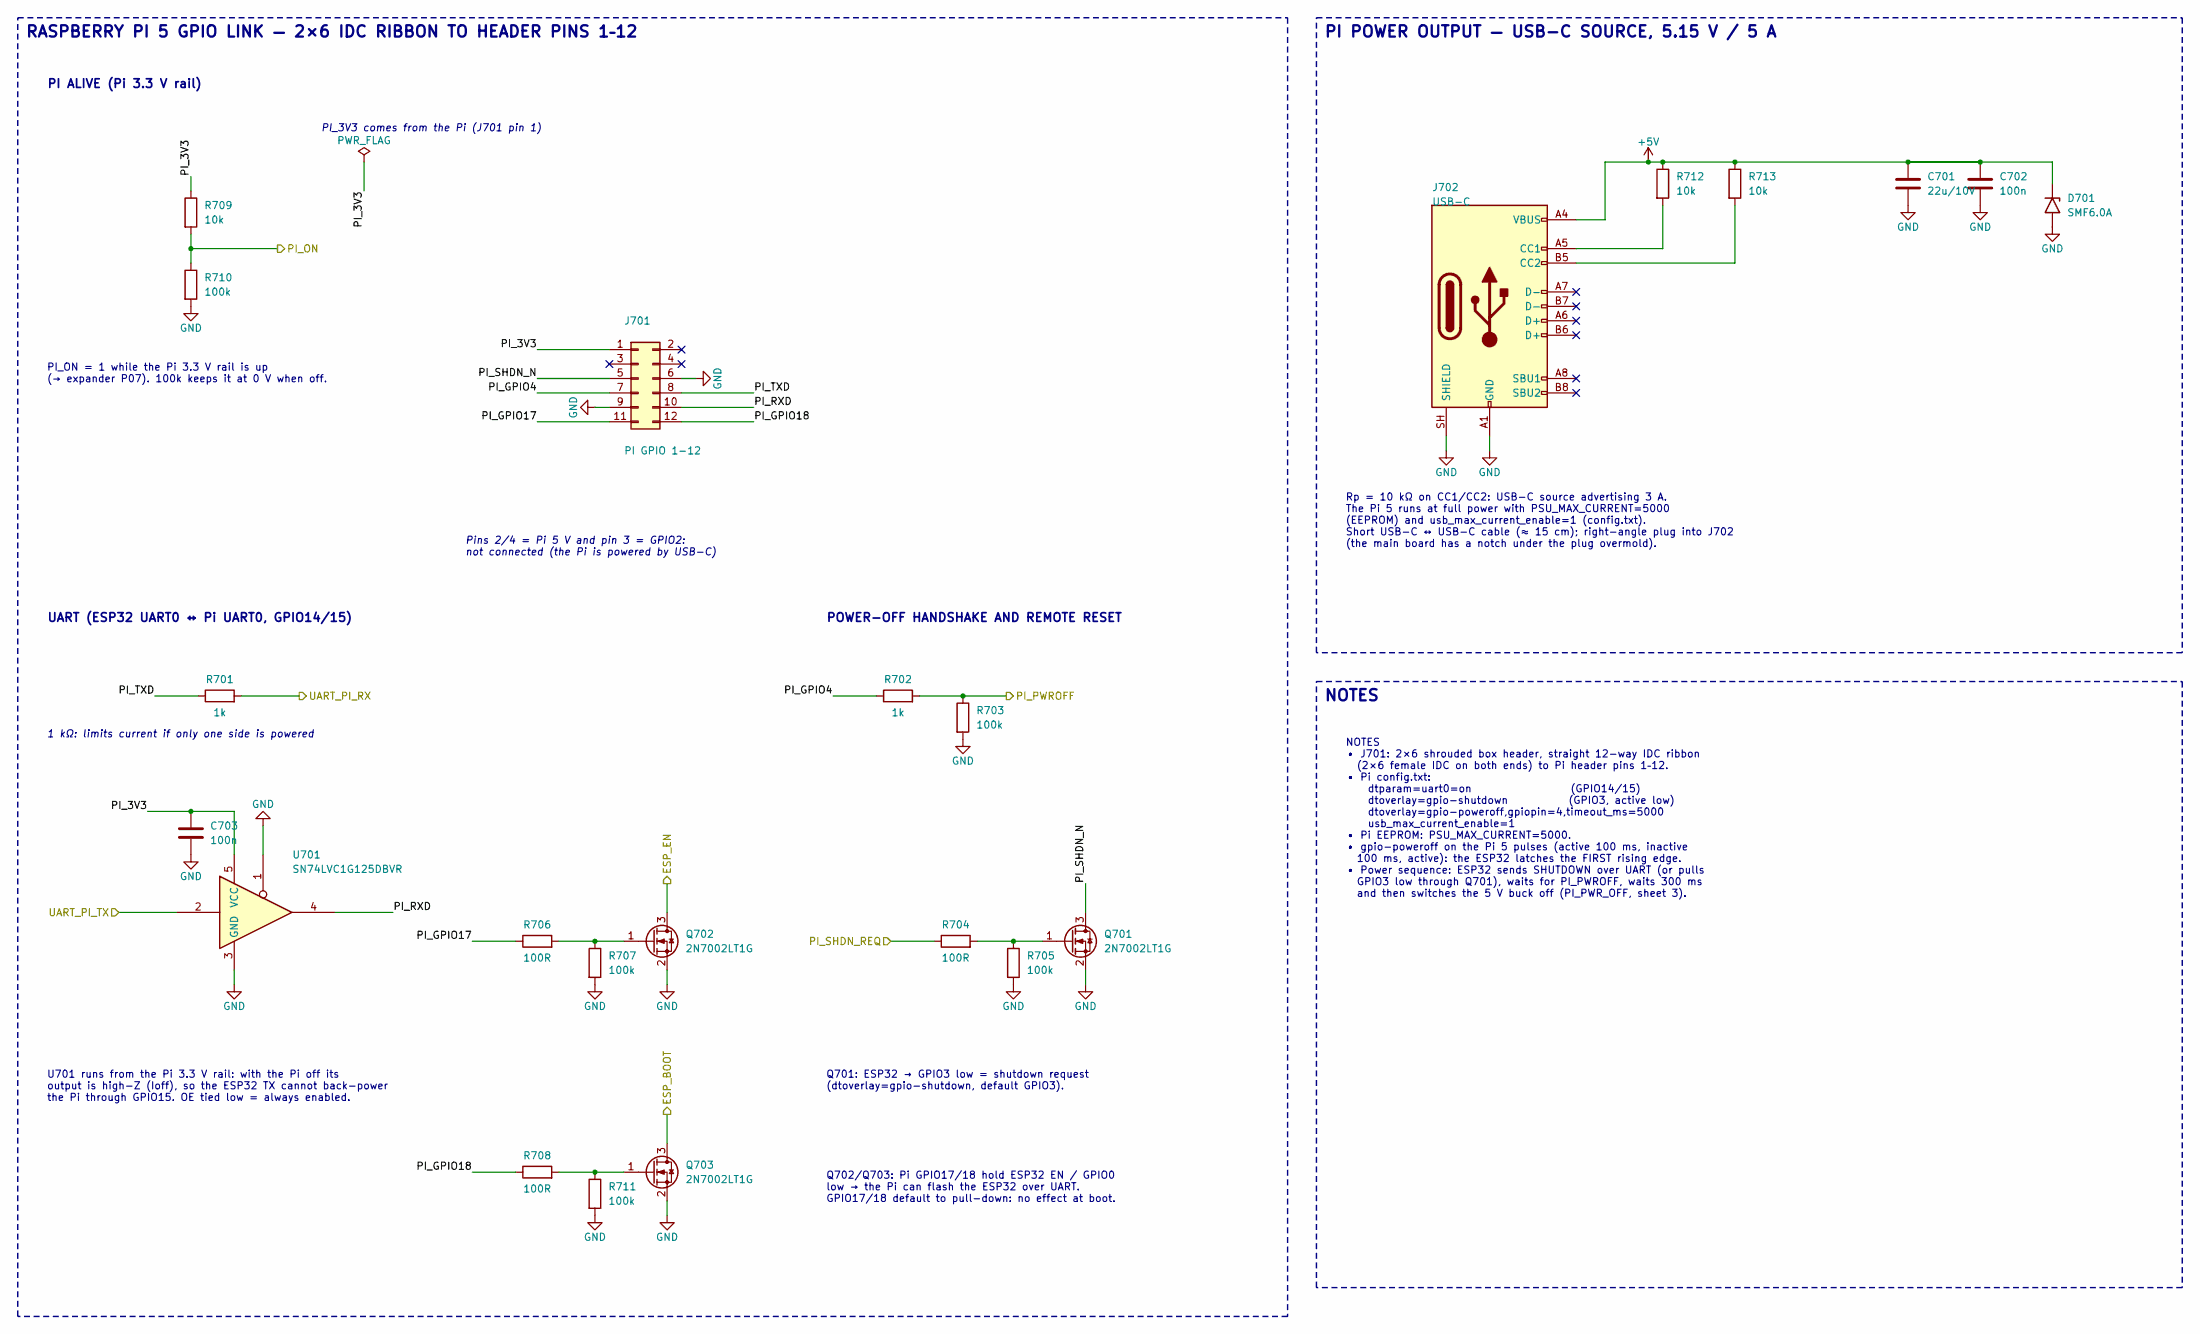
[picture p101: schematic pi.kicad_sch, Raspberry Pi 5 link and power output]

Parts:
C701: 22u/10V; C_0805_2012Metric; Voltage 10V; MPN LMK212BJ226MG-T; LCSC C92814
C702, C703: 100n; C_0402_1005Metric; Voltage 50V; MPN CL05B104KB54PNC; LCSC C307331
D701: SMF6.0A; D_SMF; MPN SMF6.0A; LCSC C123790
J701: PI GPIO 1-12; IDC-Header_2x06_P2.54mm_Vertical; MPN 2.54-2*6P box header; LCSC C9136
J702: USB-C; USB_C_Receptacle_HRO_TYPE-C-31-M-12_GCT_USB4105; MPN TYPE-C-31-M-12; LCSC C165948
Q701, Q702, Q703: 2N7002LT1G; SOT-23; MPN 2N7002LT1G; LCSC C16338
R701, R702: 1k; R_0402_1005Metric; Tolerance 1%; MPN RC0402FR-071KL; LCSC C106235
R703, R705, R707, R710, R711: 100k; R_0402_1005Metric; Tolerance 1%; MPN RC0402FR-07100KL; LCSC C60491
R704, R706, R708: 100R; R_0402_1005Metric; Tolerance 1%; MPN RC0402FR-07100RL; LCSC C106232
R709, R712, R713: 10k; R_0402_1005Metric; Tolerance 1%; MPN RC0402FR-0710KL; LCSC C60490
U701: SN74LVC1G125DBVR; SOT-23-5; MPN SN74LVC1G125DBVR; LCSC C23654

Connections:
/ESP_BOOT: Q703.3 (D); also elsewhere on the board
/ESP_EN: Q702.3 (D); also elsewhere on the board
/PI_ON: R709.2, R710.1; also elsewhere on the board
/PI_PWROFF: R702.2, R703.1; also elsewhere on the board
/PI_SHDN_REQ: R704.1; also elsewhere on the board
/Raspberry Pi 5 link and USB-C power/PI_3V3: C703.1, J701.1, R709.1, U701.5 (VCC)
/Raspberry Pi 5 link and USB-C power/PI_GPIO4: J701.7, R702.1
/Raspberry Pi 5 link and USB-C power/PI_GPIO17: J701.11, R706.1
/Raspberry Pi 5 link and USB-C power/PI_GPIO18: J701.12, R708.1
/Raspberry Pi 5 link and USB-C power/PI_RXD: J701.10, U701.4
/Raspberry Pi 5 link and USB-C power/PI_SHDN_N: J701.5, Q701.3 (D)
/Raspberry Pi 5 link and USB-C power/PI_TXD: J701.8, R701.1
/UART_PI_RX: R701.2; also elsewhere on the board
/UART_PI_TX: U701.2; also elsewhere on the board
unnamed: J702.A5 (CC1), R712.2
unnamed: J702.B5 (CC2), R713.2
unnamed: Q701.1 (G), R704.2, R705.1
unnamed: Q702.1 (G), R706.2, R707.1
unnamed: Q703.1 (G), R708.2, R711.1

Notes on the sheet:
RASPBERRY PI 5 GPIO LINK — 2×6 IDC RIBBON TO HEADER PINS 1–12
PI POWER OUTPUT — USB-C SOURCE, 5.15 V / 5 A
NOTES
Pins 2/4 = Pi 5 V and pin 3 = GPIO2: not connected (the Pi is powered by USB-C)
PI ALIVE (Pi 3.3 V rail)
PI_ON = 1 while the Pi 3.3 V rail is up (→ expander P07). 100k keeps it at 0 V when off.
PI_3V3 comes from the Pi (J701 pin 1)
UART (ESP32 UART0 ↔ Pi UART0, GPIO14/15)
1 kΩ: limits current if only one side is powered
U701 runs from the Pi 3.3 V rail: with the Pi off its output is high-Z (Ioff), so the ESP32 TX cannot back-power the Pi through GPIO15. OE tied low = always enabled.
POWER-OFF HANDSHAKE AND REMOTE RESET
Q701: ESP32 → GPIO3 low = shutdown request (dtoverlay=gpio-shutdown, default GPIO3).
Q702/Q703: Pi GPIO17/18 hold ESP32 EN / GPIO0 low → the Pi can flash the ESP32 over UART. GPIO17/18 default to pull-down: no effect at boot.
Rp = 10 kΩ on CC1/CC2: USB-C source advertising 3 A. The Pi 5 runs at full power with PSU_MAX_CURRENT=5000 (EEPROM) and usb_max_current_enable=1 (config.txt). Short USB-C ↔ USB-C cable (≈ 15 cm); right-angle plug into J702 (the main board has a notch under the plug overmold).
NOTES • J701: 2×6 shrouded box header, straight 12-way IDC ribbon (2×6 female IDC on both ends) to Pi header pins 1–12. • Pi config.txt: dtparam=uart0=on (GPIO14/15) dtoverlay=gpio-shutdown (GPIO3, active low) dtoverlay=gpio-poweroff,gpiopin=4,timeout_ms=5000 usb_max_current_enable=1 • Pi EEPROM: P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

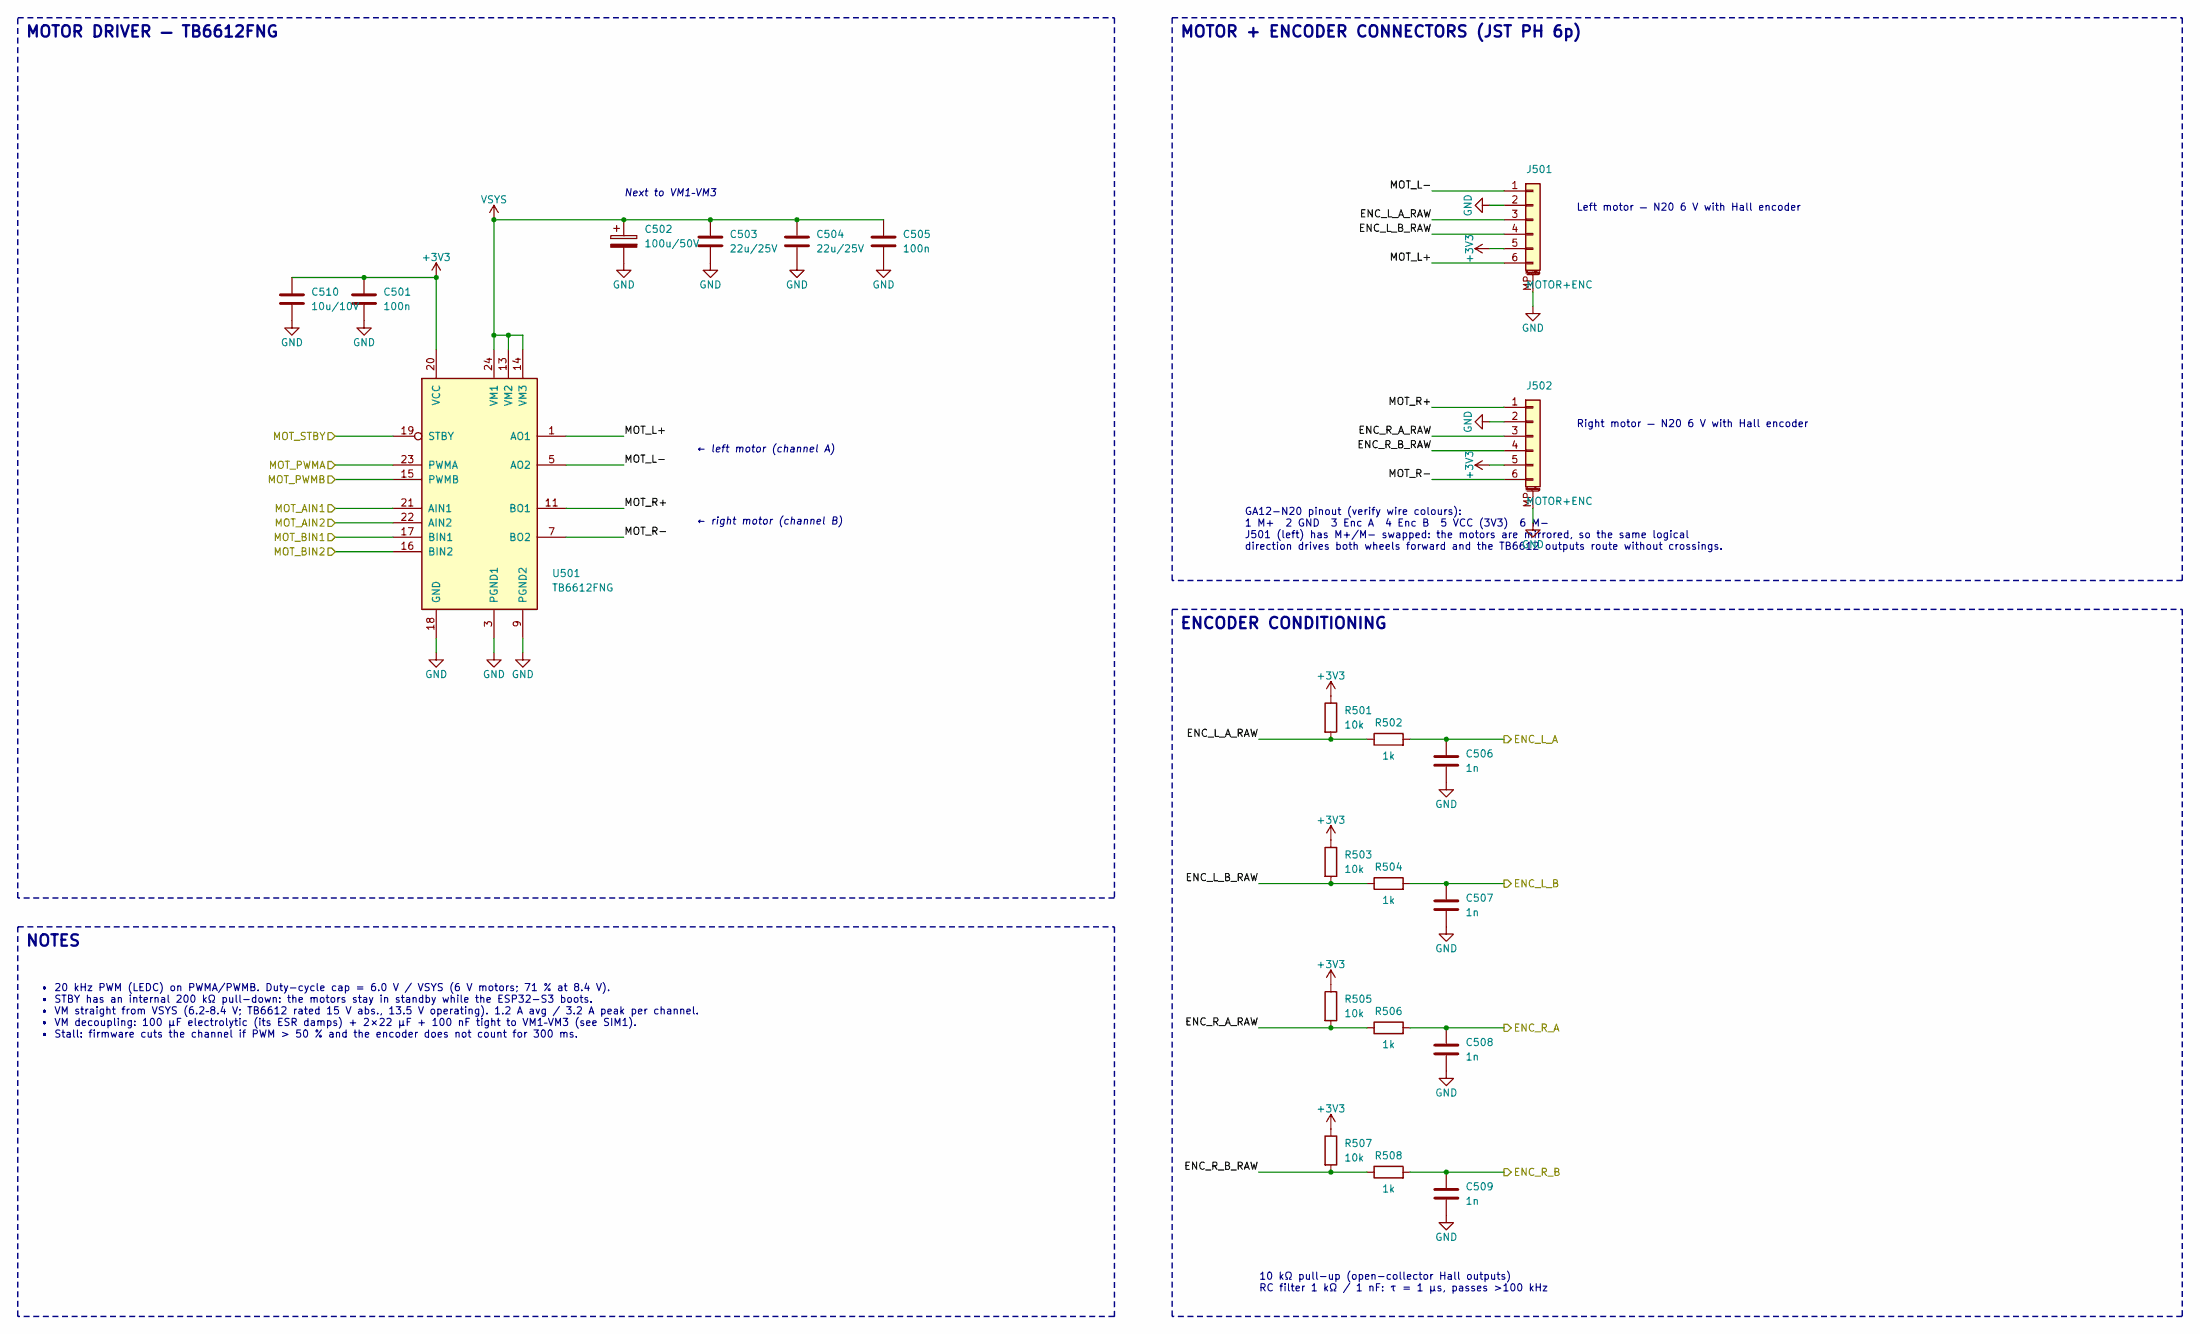
[picture p102: schematic motors.kicad_sch, Motors and encoders]

Parts:
C501, C505: 100n; C_0402_1005Metric; Voltage 50V; MPN CL05B104KB54PNC; LCSC C307331
C502: 100u/50V; CP_Elec_6.3x7.7; Voltage 50V; MPN EEE-FTH101XAP; LCSC C165974
C503, C504: 22u/25V; C_1206_3216Metric; Voltage 25V; MPN CL31A226KAHNNNE; LCSC C12891
C506, C507, C508, C509: 1n; C_0402_1005Metric; Voltage 50V; MPN CL05B102KB5NNNC; LCSC C14442
C510: 10u/10V; C_0603_1608Metric; Voltage 10V; MPN CC0603KRX5R6BB106; LCSC C326057
J501, J502: MOTOR+ENC; JST_PH_S6B-PH-SM4-TB_1x06-1MP_P2.00mm_Horizontal; MPN S6B-PH-SM4-TB(LF)(SN); LCSC C265405
R501, R503, R505, R507: 10k; R_0402_1005Metric; Tolerance 1%; MPN RC0402FR-0710KL; LCSC C60490
R502, R504, R506, R508: 1k; R_0402_1005Metric; Tolerance 1%; MPN RC0402FR-071KL; LCSC C106235
U501: TB6612FNG; SSOP-24_5.3x8.2mm_P0.65mm; MPN TB6612FNG,C,8,EL; LCSC C141517

Connections:
/ENC_L_A: C506.1, R502.2; also elsewhere on the board
/ENC_L_B: C507.1, R504.2; also elsewhere on the board
/ENC_R_A: C508.1, R506.2; also elsewhere on the board
/ENC_R_B: C509.1, R508.2; also elsewhere on the board
/MOT_AIN1: U501.21 (AIN1); also elsewhere on the board
/MOT_AIN2: U501.22 (AIN2); also elsewhere on the board
/MOT_BIN1: U501.17 (BIN1); also elsewhere on the board
/MOT_BIN2: U501.16 (BIN2); also elsewhere on the board
/MOT_PWMA: U501.23 (PWMA); also elsewhere on the board
/MOT_PWMB: U501.15 (PWMB); also elsewhere on the board
/MOT_STBY: U501.19 (STBY); also elsewhere on the board
/Motors and encoders/ENC_L_A_RAW: J501.3, R501.2, R502.1
/Motors and encoders/ENC_L_B_RAW: J501.4, R503.2, R504.1
/Motors and encoders/ENC_R_A_RAW: J502.3, R505.2, R506.1
/Motors and encoders/ENC_R_B_RAW: J502.4, R507.2, R508.1
/Motors and encoders/MOT_L+: J501.6, U501.1 (AO1), U501.2 (AO1)
/Motors and encoders/MOT_L-: J501.1, U501.5 (AO2), U501.6 (AO2)
/Motors and encoders/MOT_R+: J502.1, U501.11 (BO1), U501.12 (BO1)
/Motors and encoders/MOT_R-: J502.6, U501.7 (BO2), U501.8 (BO2)
VSYS: C502.1, C503.1, C504.1, C505.1, U501.13 (VM2), U501.14 (VM3), U501.24 (VM1); also elsewhere on the board

Notes on the sheet:
MOTOR DRIVER — TB6612FNG
MOTOR + ENCODER CONNECTORS (JST PH 6p)
ENCODER CONDITIONING
NOTES
Next to VM1–VM3
← left motor (channel A)
← right motor (channel B)
Left motor — N20 6 V with Hall encoder
Right motor — N20 6 V with Hall encoder
GA12-N20 pinout (verify wire colours): 1 M+ 2 GND 3 Enc A 4 Enc B 5 VCC (3V3) 6 M- J501 (left) has M+/M− swapped: the motors are mirrored, so the same logical direction drives both wheels forward and the TB6612 outputs route without crossings.
10 kΩ pull-up (open-collector Hall outputs) RC filter 1 kΩ / 1 nF: τ = 1 µs, passes >100 kHz
• 20 kHz PWM (LEDC) on PWMA/PWMB. Duty-cycle cap = 6.0 V / VSYS (6 V motors; 71 % at 8.4 V). • STBY has an internal 200 kΩ pull-down: the motors stay in standby while the ESP32-S3 boots. • VM straight from VSYS (6.2–8.4 V; TB6612 rated 15 V abs., 13.5 V operating). 1.2 A avg / 3.2 A peak per channe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

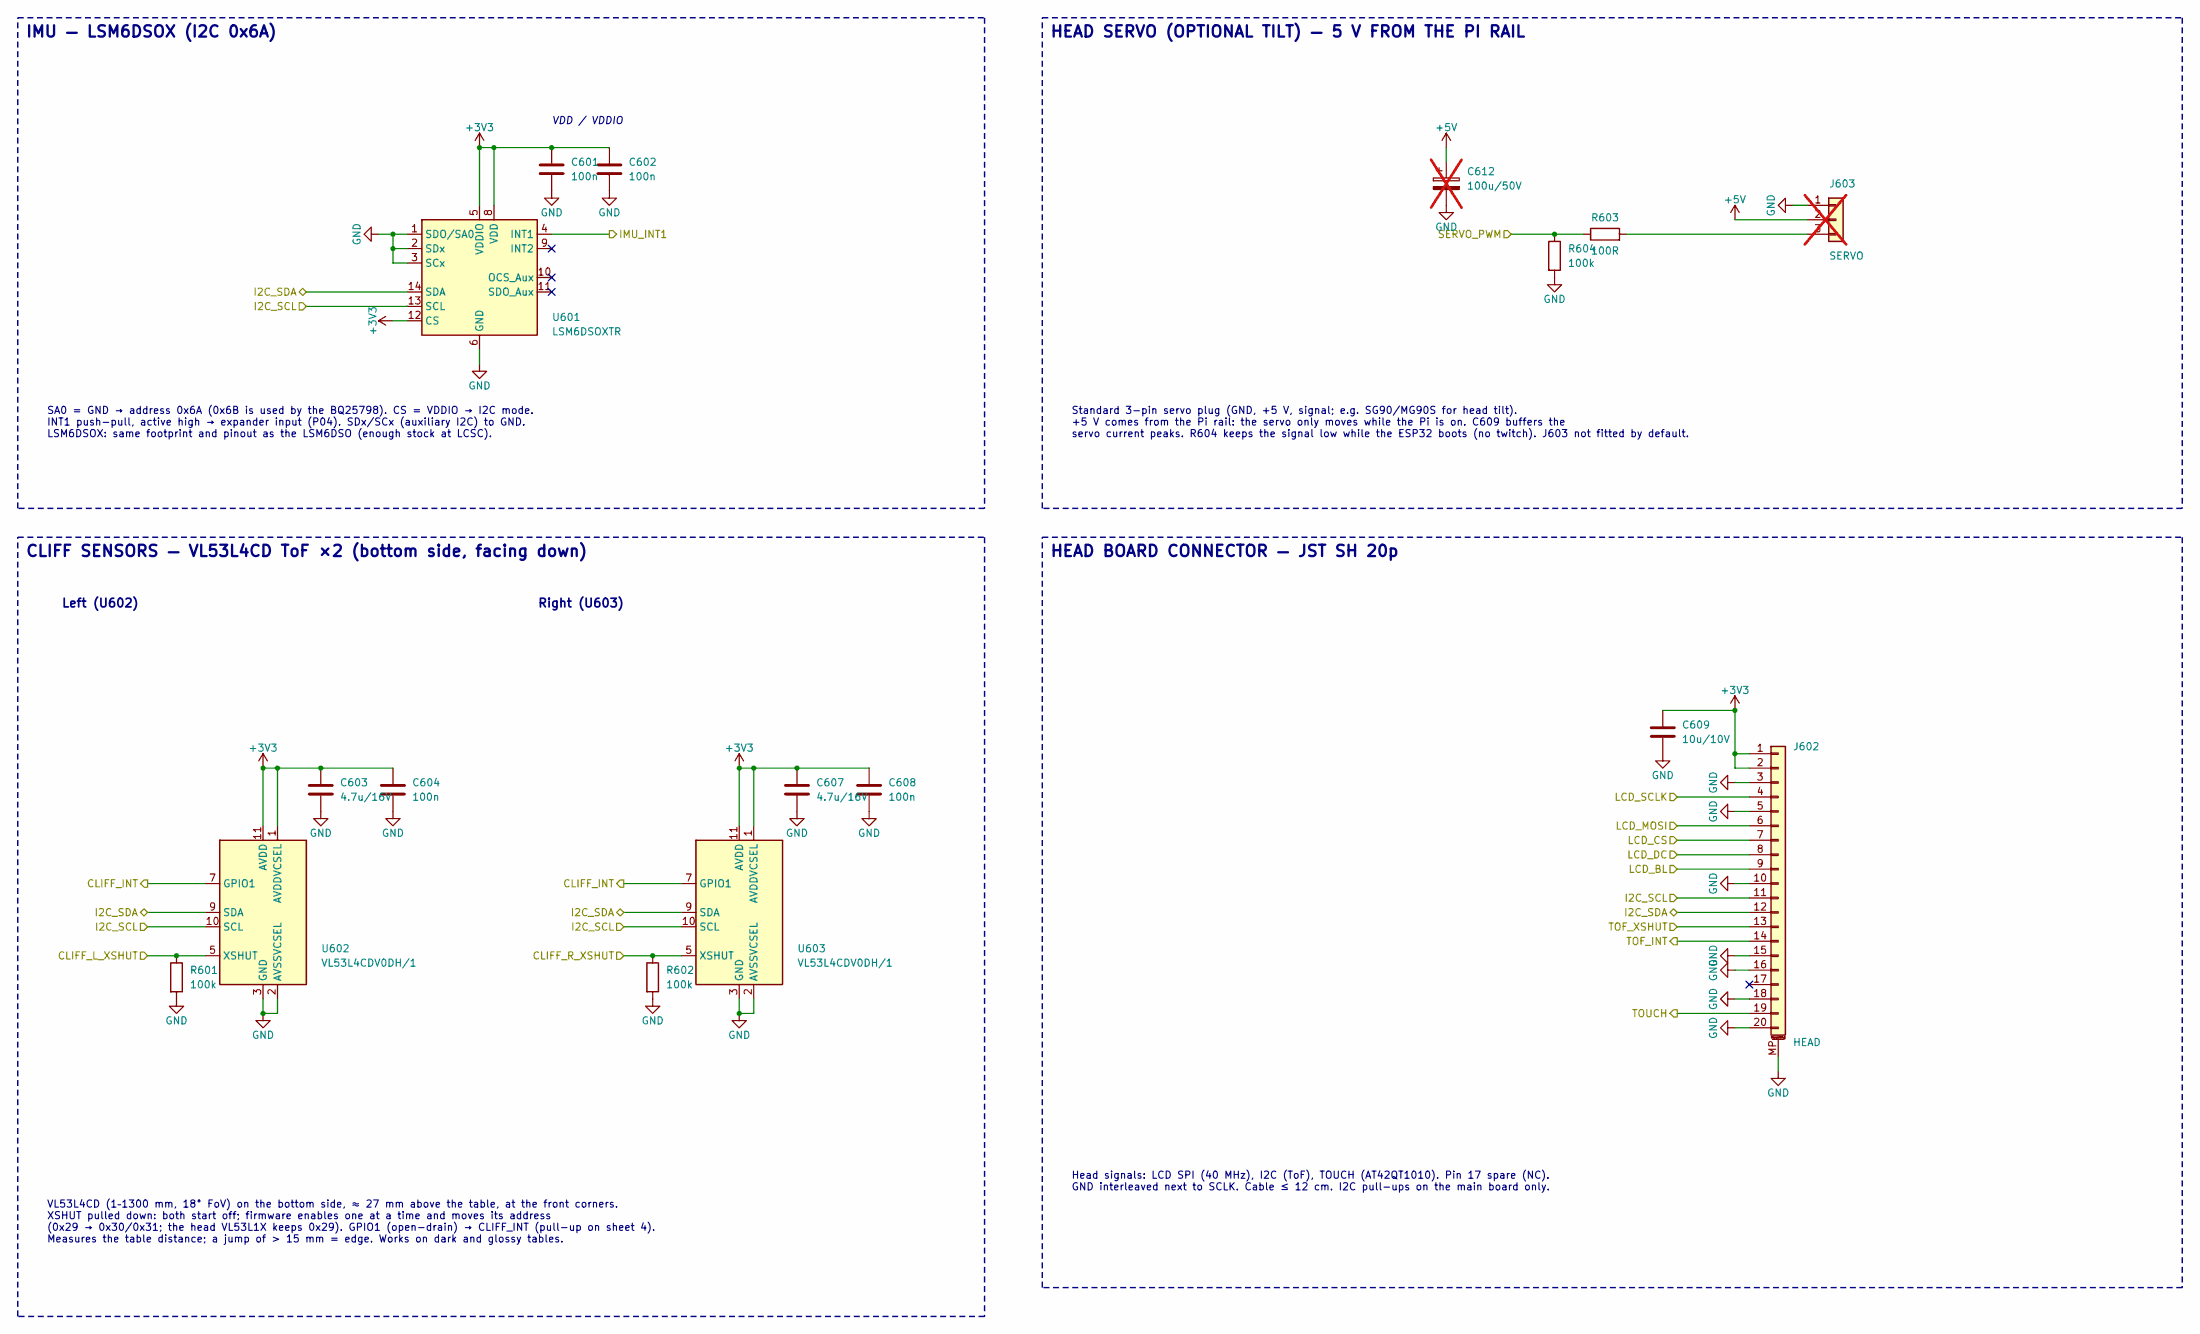
[picture p103: schematic sensors.kicad_sch, IMU, cliff sensors, servo and head connector]

Parts:
C601, C602, C604, C608: 100n; C_0402_1005Metric; Voltage 50V; MPN CL05B104KB54PNC; LCSC C307331
C603, C607: 4.7u/16V; C_0603_1608Metric; Voltage 16V; MPN CL10A475KO8NNNC; LCSC C19666
C609: 10u/10V; C_0603_1608Metric; Voltage 10V; MPN CC0603KRX5R6BB106; LCSC C326057
C612: 100u/50V; CP_Elec_6.3x7.7; Voltage 50V; MPN EEE-FTH101XAP; LCSC C165974; not fitted
J602: HEAD; JST_SH_SM20B-SRSS-TB_1x20-1MP_P1.00mm_Horizontal; MPN SM20B-SRSS-TB(LF)(SN); LCSC C160415
J603: SERVO; PinHeader_1x03_P2.54mm_Vertical; MPN 2.54-1*3P header; LCSC C49257; not fitted
R601, R602, R604: 100k; R_0402_1005Metric; Tolerance 1%; MPN RC0402FR-07100KL; LCSC C60491
R603: 100R; R_0402_1005Metric; Tolerance 1%; MPN RC0402FR-07100RL; LCSC C106232
U601: LSM6DSOXTR; LGA-14_3x2.5mm_P0.5mm_LayoutBorder3x4y; MPN LSM6DSOXTR; LCSC C481766
U602, U603: VL53L4CDV0DH/1; ST_VL53L4CD; MPN VL53L4CDV0DH/1; LCSC C3178291

Connections:
/CLIFF_INT: U602.7 (GPIO1), U603.7 (GPIO1); also elsewhere on the board
/CLIFF_L_XSHUT: R601.1, U602.5 (XSHUT); also elsewhere on the board
/CLIFF_R_XSHUT: R602.1, U603.5 (XSHUT); also elsewhere on the board
/I2C_SCL: J602.11, U601.13 (SCL), U602.10 (SCL), U603.10 (SCL); also elsewhere on the board
/I2C_SDA: J602.12, U601.14 (SDA), U602.9 (SDA), U603.9 (SDA); also elsewhere on the board
/IMU_INT1: U601.4 (INT1); also elsewhere on the board
/LCD_BL: J602.9; also elsewhere on the board
/LCD_CS: J602.7; also elsewhere on the board
/LCD_DC: J602.8; also elsewhere on the board
/LCD_MOSI: J602.6; also elsewhere on the board
/LCD_SCLK: J602.4; also elsewhere on the board
/SERVO_PWM: R603.1, R604.1; also elsewhere on the board
/TOF_INT: J602.14; also elsewhere on the board
/TOF_XSHUT: J602.13; also elsewhere on the board
/TOUCH: J602.19; also elsewhere on the board
unnamed: J603.3, R603.2

Notes on the sheet:
IMU — LSM6DSOX (I2C 0x6A)
CLIFF SENSORS — VL53L4CD ToF ×2 (bottom side, facing down)
HEAD SERVO (OPTIONAL TILT) — 5 V FROM THE PI RAIL
HEAD BOARD CONNECTOR — JST SH 20p
VDD / VDDIO
SA0 = GND → address 0x6A (0x6B is used by the BQ25798). CS = VDDIO → I2C mode. INT1 push-pull, active high → expander input (P04). SDx/SCx (auxiliary I2C) to GND. LSM6DSOX: same footprint and pinout as the LSM6DSO (enough stock at LCSC).
Left (U602)
Right (U603)
VL53L4CD (1–1300 mm, 18° FoV) on the bottom side, ≈ 27 mm above the table, at the front corners. XSHUT pulled down: both start off; firmware enables one at a time and moves its address (0x29 → 0x30/0x31; the head VL53L1X keeps 0x29). GPIO1 (open-drain) → CLIFF_INT (pull-up on sheet 4). Measures the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
Standard 3-pin servo plug (GND, +5 V, signal; e.g. SG90/MG90S for head tilt). +5 V comes from the Pi rail: the servo only moves while the Pi is on. C609 buffers the servo current peaks. R604 keeps the signal low while the ESP32 boots (no twitch). J603 not fitted by default.
Head signals: LCD SPI (40 MHz), I2C (ToF), TOUCH (AT42QT1010). Pin 17 spare (NC). GND interleaved next to SCLK. Cable ≤ 12 cm. I2C pull-ups on the main board only.

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
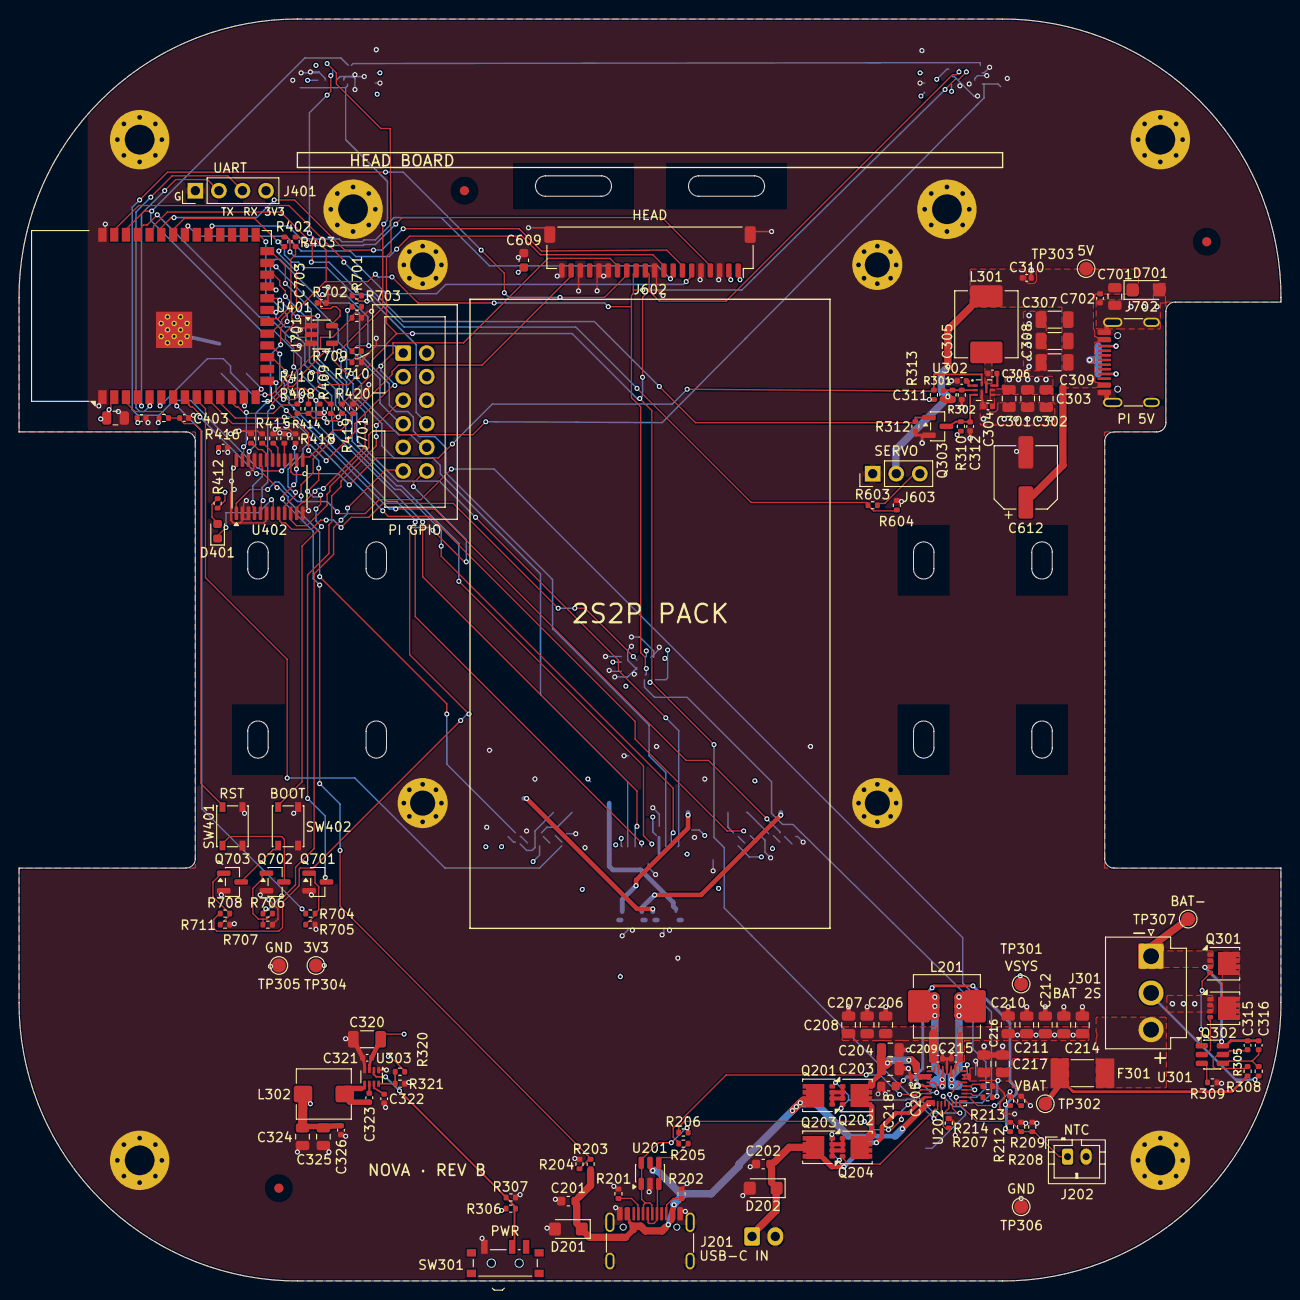
[picture p104: board nova-main.kicad_pcb from above]

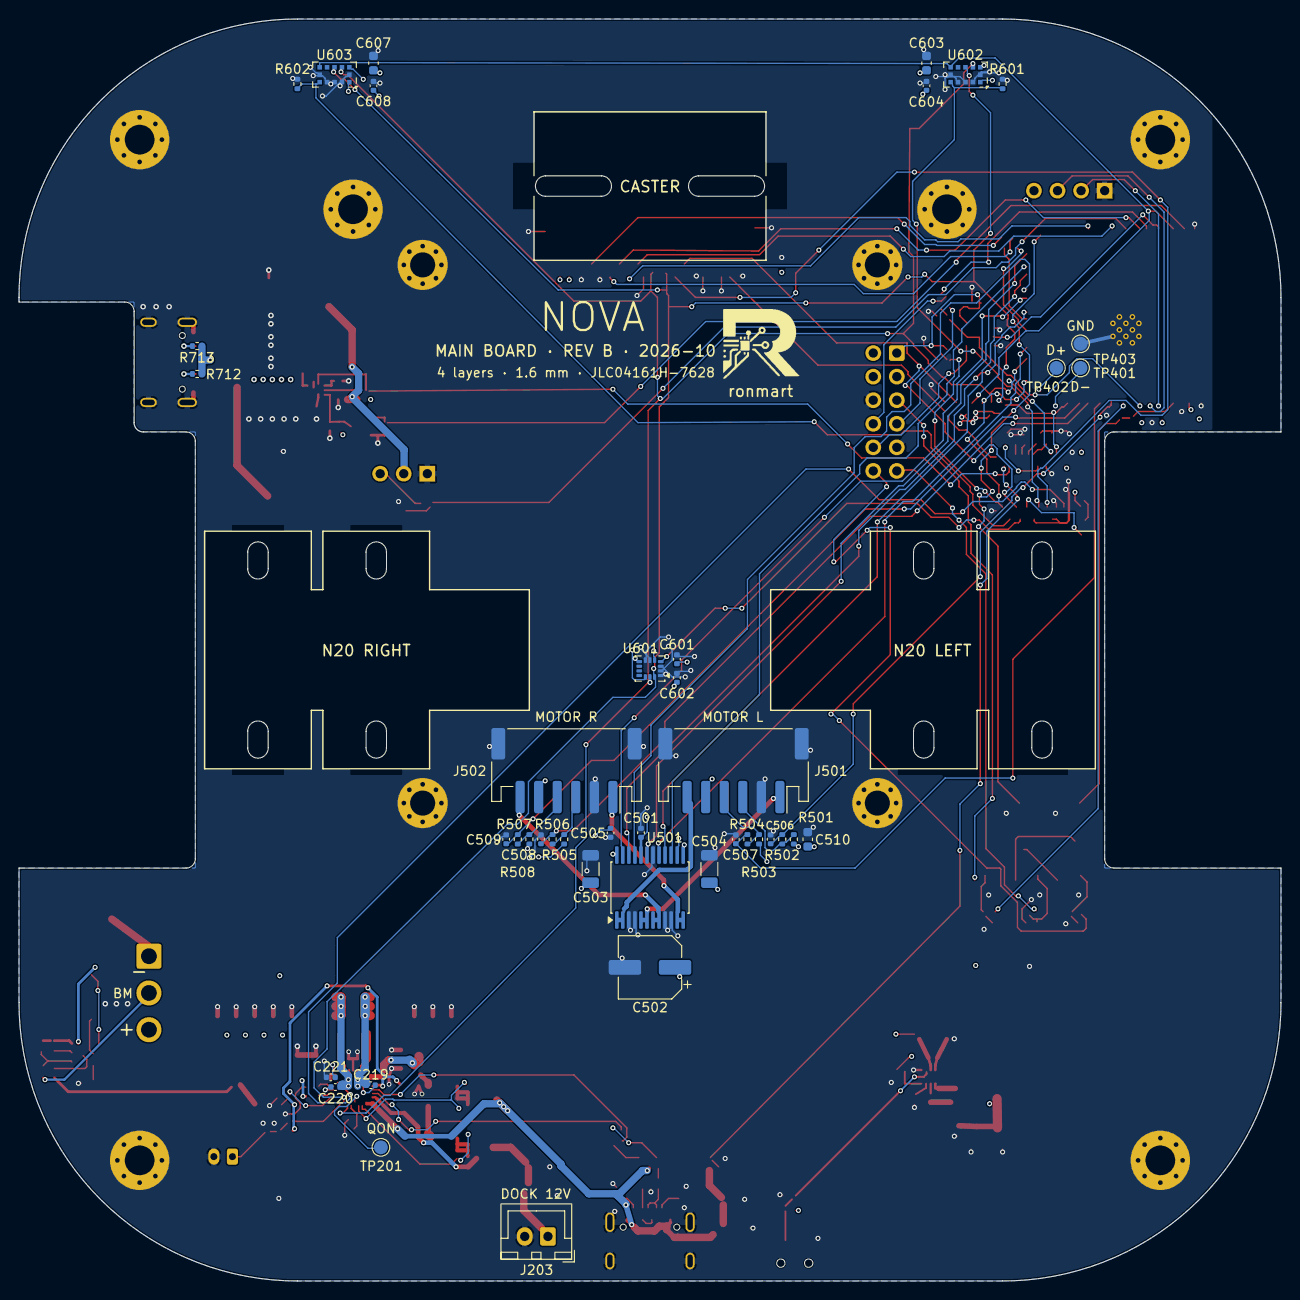
[picture p105: board nova-main.kicad_pcb from below]

Board: 4 copper layers, 136.0 x 136.0 mm, 201 parts (42 on the bottom side), 121 nets.
