ronmart17/nova-robot/generator/project_files.py

import json, os

def kicad_pro(path, name, sheets, netclasses=True, board=False):
    pro = {
        "meta": {"filename": f"{name}.kicad_pro", "version": 3},
        "sheets": [[u, n] for u, n in sheets],
        "text_variables": {"REV": "B", "PROJECT": "NOVA"},
        "libraries": {"pinned_footprint_libs": [], "pinned_symbol_libs": []},
        "schematic": {"drawing": {"default_line_thickness": 6.0, "default_text_size": 50.0, "pin_symbol_size": 25.0,
                                  "label_size_ratio": 0.375, "text_offset_ratio": 0.15, "intersheets_ref_show": True,
                                  "intersheets_ref_short": False, "intersheets_ref_own_page": False,
                                  "intersheets_ref_prefix": "", "intersheets_ref_suffix": ""},
                      "meta": {"version": 1}, "subpart_first_id": 65, "subpart_id_separator": 0},
        "net_settings": {
            "meta": {"version": 4},
            "classes": [
                {"name": "Default", "clearance": 0.15, "track_width": 0.15, "via_diameter": 0.55, "via_drill": 0.3,
                 "diff_pair_width": 0.2, "diff_pair_gap": 0.15, "priority": 2147483647, "wire_width": 6, "bus_width": 12,
                 "schematic_color": "rgba(0, 0, 0, 0.000)", "pcb_color": "rgba(0, 0, 0, 0.000)"},
                {"name": "Power", "clearance": 0.15, "track_width": 0.6, "via_diameter": 0.6, "via_drill": 0.3,
                 "diff_pair_width": 0.2, "diff_pair_gap": 0.15, "priority": 0, "wire_width": 6, "bus_width": 12,
                 "schematic_color": "rgba(194, 0, 0, 1.000)", "pcb_color": "rgba(0, 0, 0, 0.000)"},
                {"name": "Motor", "clearance": 0.15, "track_width": 0.5, "via_diameter": 0.6, "via_drill": 0.3,
                 "diff_pair_width": 0.2, "diff_pair_gap": 0.15, "priority": 1, "wire_width": 6, "bus_width": 12,
                 "schematic_color": "rgba(132, 0, 132, 1.000)", "pcb_color": "rgba(0, 0, 0, 0.000)"},
                {"name": "USB", "clearance": 0.15, "track_width": 0.25, "via_diameter": 0.6, "via_drill": 0.3,
                 "diff_pair_width": 0.25, "diff_pair_gap": 0.15, "priority": 3, "wire_width": 6, "bus_width": 12,
                 "schematic_color": "rgba(0, 132, 132, 1.000)", "pcb_color": "rgba(0, 0, 0, 0.000)"},
            ],
            "net_colors": None, "netclass_assignments": None,
            "netclass_patterns": [{"netclass": "Power", "pattern": p} for p in
                                  ("VSYS", "VBAT", "CHG_VBUS", "CHG_PMID", "VBUS_USB", "VDOCK*", "VIN_*", "+5V", "+3V3", "GND", "*CHG_SW*", "*_SW",
                                   "BAT-", "BAT+*", "PROT_MID", "ACDRV?_S", "PLATE_*")] +
                                 [{"netclass": "Motor", "pattern": "MOT_*[+-]"}, {"netclass": "USB", "pattern": "USB_D*"}] if netclasses else [],
        },
    }
    if board:
        pro["board"] = board_settings()
    json.dump(pro, open(path, 'w'), indent=2)

def board_settings():
    """Board design rules (JLCPCB 4 layers, no surcharges: track/space ≥ 0.127 mm, drill ≥ 0.3 mm)."""
    return {
        "3dviewports": [],
        "design_settings": {
            "defaults": {
                "board_outline_line_width": 0.1, "copper_line_width": 0.2, "copper_text_italic": False,
                "copper_text_size_h": 1.5, "copper_text_size_v": 1.5, "copper_text_thickness": 0.3, "copper_text_upright": False,
                "courtyard_line_width": 0.05, "dimension_precision": 4, "dimension_units": 3,
                "dimensions": {"arrow_length": 1270000, "extension_offset": 500000, "keep_text_aligned": True,
                               "suppress_zeroes": False, "text_position": 0, "units_format": 1},
                "fab_line_width": 0.1, "fab_text_italic": False, "fab_text_size_h": 1.0, "fab_text_size_v": 1.0,
                "fab_text_thickness": 0.15, "fab_text_upright": False, "other_line_width": 0.1, "other_text_italic": False,
                "other_text_size_h": 1.0, "other_text_size_v": 1.0, "other_text_thickness": 0.15, "other_text_upright": False,
                "pads": {"drill": 0.8, "height": 1.6, "width": 1.6},
                "silk_line_width": 0.12, "silk_text_italic": False, "silk_text_size_h": 0.8, "silk_text_size_v": 0.8,
                "silk_text_thickness": 0.12, "silk_text_upright": False,
                "zones": {"min_clearance": 0.25}
            },
            "diff_pair_dimensions": [],
            "drc_exclusions": [],
            "meta": {"version": 2},
            "rule_severities": {
                "annular_width": "error", "clearance": "error", "connection_width": "warning", "copper_edge_clearance": "error",
                "copper_sliver": "warning", "courtyards_overlap": "error", "diff_pair_gap_out_of_range": "error",
                "diff_pair_uncoupled_length_too_long": "error", "drill_out_of_range": "error", "duplicate_footprints": "warning",
                "extra_footprint": "warning", "footprint": "error", "footprint_symbol_mismatch": "warning",
                "footprint_type_mismatch": "ignore", "hole_clearance": "error", "hole_near_hole": "error",
                "holes_co_located": "warning", "invalid_outline": "error", "isolated_copper": "warning",
                "item_on_disabled_layer": "error", "items_not_allowed": "error", "length_out_of_range": "error",
                "lib_footprint_issues": "warning", "lib_footprint_mismatch": "ignore", "malformed_courtyard": "error",
                "microvia_drill_out_of_range": "error", "missing_courtyard": "ignore", "missing_footprint": "warning",
                "net_conflict": "warning", "npth_inside_courtyard": "ignore", "padstack": "warning",
                "pth_inside_courtyard": "ignore", "shorting_items": "error", "silk_edge_clearance": "warning",
                "silk_over_copper": "warning", "silk_overlap": "warning", "skew_out_of_range": "error",
                "solder_mask_bridge": "error", "starved_thermal": "error", "text_height": "warning",
                "text_thickness": "warning", "through_hole_pad_without_hole": "error", "too_many_vias": "error",
                "track_dangling": "warning", "track_width": "error", "tracks_crossing": "error",
                "unconnected_items": "error", "unresolved_variable": "error", "via_dangling": "warning",
                "zones_intersect": "error"
            },
            "rules": {
                "max_error": 0.005, "min_clearance": 0.15, "min_connection": 0.0, "min_copper_edge_clearance": 0.3,
                "min_groove_width": 0.0, "min_hole_clearance": 0.25, "min_hole_to_hole": 0.25,
                "min_microvia_diameter": 0.2, "min_microvia_drill": 0.1, "min_resolved_spokes": 1,
                "min_silk_clearance": 0.0, "min_text_height": 0.8, "min_text_thickness": 0.12,
                "min_through_hole_diameter": 0.3, "min_track_width": 0.15, "min_via_annular_width": 0.1,
                "min_via_diameter": 0.5, "solder_mask_to_copper_clearance": 0.0, "use_height_for_length_calcs": True
            },
            "teardrop_options": [{"td_onpadsmd": True, "td_onroundshapesonly": False, "td_ontrackend": False,
                                  "td_onviapad": True}],
            "teardrop_parameters": [],
            "track_widths": [0.0, 0.15, 0.2, 0.25, 0.3, 0.4, 0.5, 0.6, 0.8, 1.0, 1.2, 1.5],
            "tuning_pattern_settings": {},
            "via_dimensions": [{"diameter": 0.0, "drill": 0.0}, {"diameter": 0.55, "drill": 0.3}, {"diameter": 0.6, "drill": 0.3}],
            "zones_allow_external_fillets": False
        },
        "ipc2581": {"dist": "", "distpn": "", "internal_id": "", "mfg": "", "mpn": ""},
        "layer_pairs": [],
        "layer_presets": [],
        "viewports": []
    }

def lib_tables(proj_dir, rel='../lib'):
    open(os.path.join(proj_dir, 'sym-lib-table'), 'w').write(
        '(sym_lib_table\n\t(version 7)\n\t(lib (name "robot")(type "KiCad")(uri "${KIPRJMOD}/' + rel + '/robot.kicad_sym")(options "")(descr "NOVA — project symbols"))\n)\n')
    open(os.path.join(proj_dir, 'fp-lib-table'), 'w').write(
        '(fp_lib_table\n\t(version 7)\n\t(lib (name "robot")(type "KiCad")(uri "${KIPRJMOD}/' + rel + '/robot.pretty")(options "")(descr "NOVA — project footprints (with 3D models)"))\n)\n')
